Dhaval437/Baymax/assembly/amplifier-esp32-wiring.png

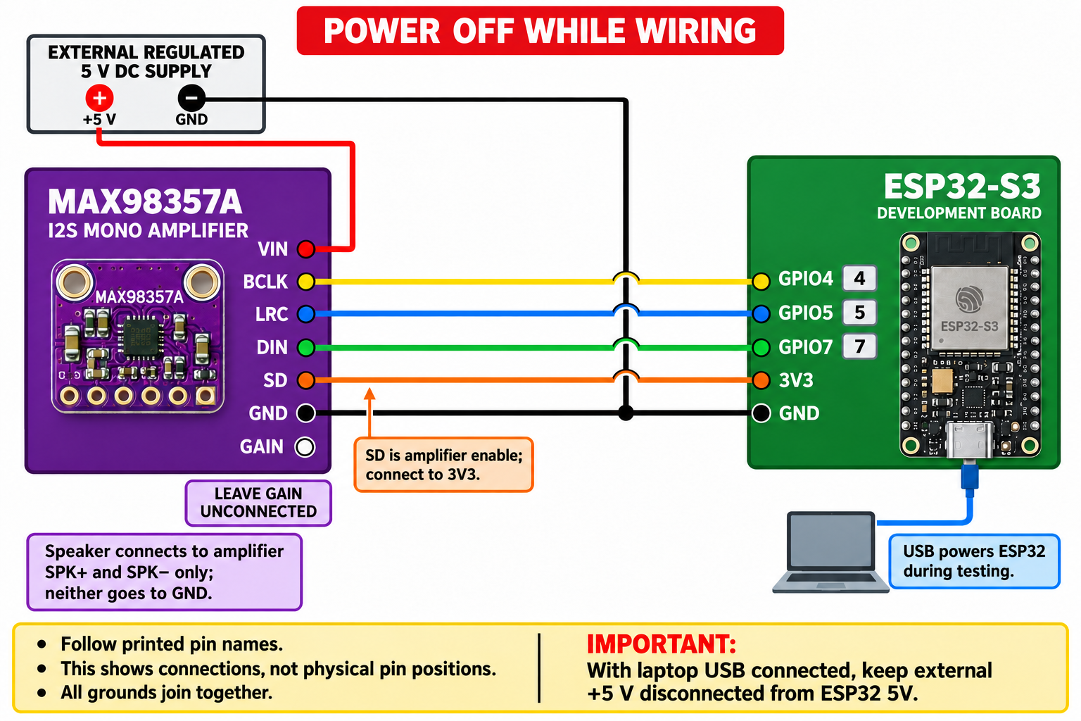
assembly/amplifier-esp32-wiring.png
