Dhaval437/Baymax/assembly/audio-wiring-corrected.png

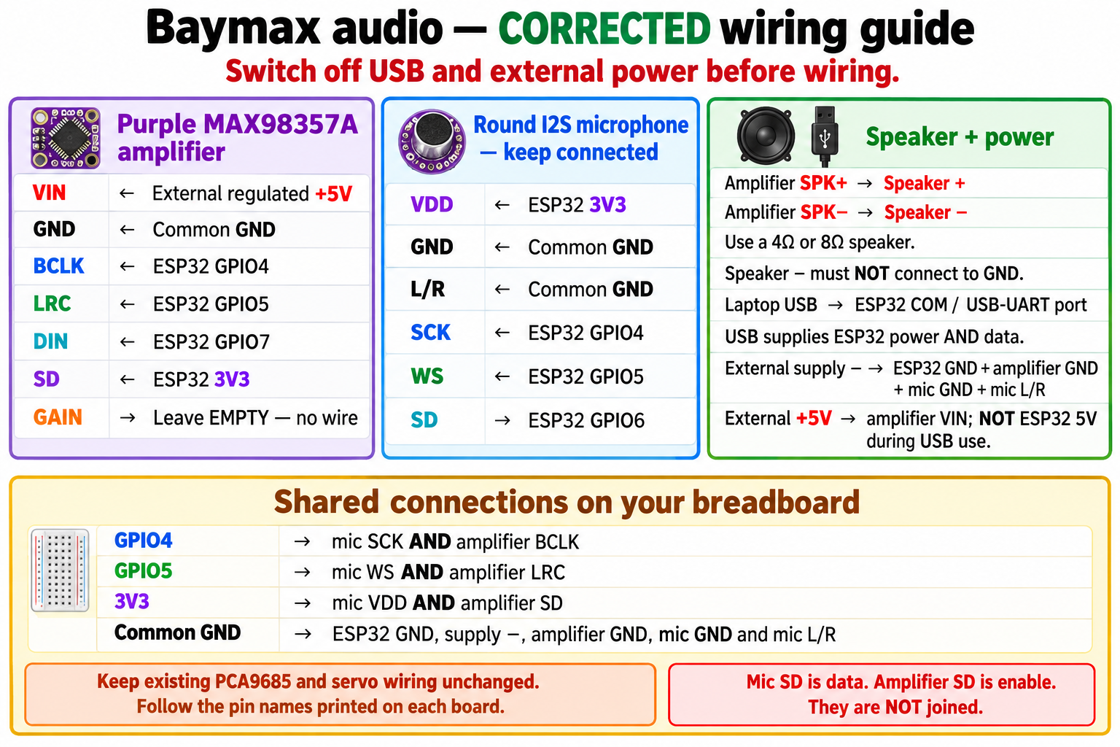
assembly/audio-wiring-corrected.png
