Dhaval437/Baymax/README.md

<div align=center>

# Mini Baymax

### A voice-first, expressive companion robot powered by an ESP32-S3 and local AI






**Listen. Think. Speak. Move.**

[Quick start](#quick-start) · [How it works](#how-it-works) · [Hardware](#hardware) · [Documentation](#documentation)

</div>

---

Mini Baymax is a laptop-assisted companion robot that listens for **“Baymax”** or a distress cue, transcribes speech, creates a contextual response with a local language model, speaks it aloud, and performs gentle head and arm gestures.

The project combines an ESP32-S3 audio and motion controller with a local Node.js service, Whisper speech recognition, Ollama conversation generation, and local voice synthesis. It is designed to keep conversations on the local network and continue working without a cloud AI subscription.

> [!IMPORTANT]
> This is an experimental hobby robot—not a medical device, emergency service, or clinically validated care system. Its health-related responses are limited educational guidance and may be wrong.

## Highlights

- **Hands-free conversation** — automatic listening, wake phrase detection, adaptive turn endings, and follow-up windows.
- **Local-first intelligence** — speech recognition, response generation, and voice synthesis run on the laptop.
- **Expressive movement** — smooth, bounded PCA9685 gestures for the head and two arms.
- **Live telemetry** — local dashboard for microphone levels, transcripts, timing, connectivity, and motion state.
- **Conversation memory** — recent turns are retained in RAM, with bounded summarization for longer discussions.
- **Phone setup** — configure Wi-Fi, update the laptop address, pause/resume, and install compatible firmware updates.
- **Resilient audio pipeline** — pre-roll capture, adaptive noise floor, speech-onset filtering, retries, and segmented replies.
- **Private by default** — authenticated device requests, local-only dashboards, temporary audio, and no persisted chat history.

## How It Works

```mermaid
flowchart LR
    User((You)) -->|voice| Mic[I2S microphone]
    Mic --> ESP[ESP32-S3 firmware]
    ESP -->|authenticated audio over Wi-Fi| Server[Node.js robot server]
    Server --> STT[Whisper speech recognition]
    STT --> LLM[Ollama · qwen3:1.7b]
    LLM --> TTS[Local voice synthesis]
    TTS -->|PCM audio + gesture cue| ESP
    ESP --> Speaker[I2S amplifier + speakers]
    ESP --> Motion[PCA9685 + servos]
    ESP -. USB telemetry .-> Dashboard[Local dashboard]
```

The ESP32 handles real-time capture, playback, Wi-Fi, and safe motion. The laptop handles the heavier AI workload. The robot therefore needs the laptop awake and connected to the same network during normal conversation.

## Quick Start

### Laptop prototype

Use this path to try the browser conversation interface without assembling the robot.

**Requirements**

- Windows, macOS, or Linux
- Node.js **22.9 or newer**
- A configured AI provider; local mode uses Ollama, FFmpeg, Python, `faster-whisper`, and the included speech worker

```powershell
git clone https://github.com/Dhaval437/Baymax.git
cd Baymax
Copy-Item .env.example .env
npm start
```

Open [http://127.0.0.1:8787](http://127.0.0.1:8787). For the full local model setup, follow [START_HERE.md](START_HERE.md).

### Complete robot

After configuring the local models, private environment file, and ESP32 firmware:

```powershell
npm run check:robot
.\Start-Baymax.cmd
```

The launcher starts:

| Service | Default address | Purpose |
|---|---|---|
| Browser prototype | `http://127.0.0.1:8787` | Text, microphone, and voice testing |
| Robot API | `http://<laptop-ip>:8788` | Authenticated ESP32 audio transport |
| Robot dashboard | `http://127.0.0.1:8793` | Live transcript, timing, audio, and hardware telemetry |

Upload the integrated firmware when required:

```powershell
powershell -ExecutionPolicy Bypass -File .\assembly\Build-Baymax.ps1 -Upload -Port COM14
```

Replace `COM14` with the ESP32's current port. Read [HARDWARE_SETUP.md](HARDWARE_SETUP.md) before applying external power or enabling motion.

## Configuration

Copy `.env.example` to `.env` and configure the laptop service:

```dotenv
AI_PROVIDER=local
LOCAL_MODEL=qwen3:1.7b
PORT=8787
BAYMAX_DEVICE_PORT=8788
BAYMAX_DEVICE_HOST=127.0.0.1
BAYMAX_DEVICE_TOKEN=REPLACE_WITH_AT_LEAST_32_RANDOM_CHARACTERS
```

Then copy `firmware/MiniBaymax/config.example.h` to `firmware/MiniBaymax/config.h` and set the same device token, Wi-Fi credentials, and laptop address.

> [!WARNING]
> Never commit `.env`, `config.h`, setup keys, Wi-Fi credentials, private firmware binaries, or files under `assembly/private/`.

### Local AI Stack

| Layer | Default implementation |
|---|---|
| Speech recognition | `faster-whisper` / Whisper `tiny.en` |
| Conversation | Ollama with `qwen3:1.7b` |
| Voice synthesis | Persistent local Python speech worker |
| Orchestration | Node.js HTTP services |
| Robot control | Arduino firmware for ESP32-S3 N16R8 |

Gemini and Groq adapters are also present for browser-prototype experiments, but local mode is the primary robot path.

## Hardware

The integrated build targets:

- ESP32-S3 N16R8 development board
- I2S microphone
- I2S amplifier and speakers
- PCA9685 servo controller at address `0x40`
- Three servo channels: head `0`, left arm `1`, right arm `2`
- Separate, correctly sized power for logic, audio, and servo loads

Motion is disabled by default in the shared configuration. Centre and test bare servos before connecting the mechanism, keep the robot clear of obstructions, and enable motion only after reviewing the assembly guide.

See [PARTS_INVENTORY.md](PARTS_INVENTORY.md), [MECHANICAL_LAYOUT.md](MECHANICAL_LAYOUT.md), and [ASSEMBLY_NEXT_STEPS.md](ASSEMBLY_NEXT_STEPS.md) for the physical build.

## Useful Commands

| Command | Description |
|---|---|
| `npm start` | Start the browser prototype |
| `npm run start:robot` | Start the robot API, browser app, dashboard, and speech worker |
| `npm run check:robot` | Check configuration, network address, local tools, and Ollama model |
| `npm test` | Run the Node.js regression suite |
| `npm run test:live` | Exercise the real local speech pipeline without moving hardware |
| `assembly\test-firmware-host.cmd` | Run native host tests for firmware policies and motion logic |

## Project Structure

```text
Baymax/
├── firmware/MiniBaymax/     # Integrated ESP32-S3 firmware
├── assembly/                # Build, upload, diagnostics, and verification tools
├── mechanical/              # Printable and mechanical design assets
├── public/                  # Browser app, dashboard, and phone setup UI
├── test/                    # Node, Python, and native regression tests
├── device-server.mjs        # Authenticated robot speech API
├── start-baymax.mjs         # Integrated laptop launcher
├── local-provider.mjs       # Local recognition, LLM, and speech adapter
└── conversation-policy.mjs  # Memory, response, and follow-up behavior
```

## Documentation

| Guide | Use it for |
|---|---|
| [START_HERE.md](START_HERE.md) | Laptop prototype and AI-provider setup |
| [SOFTWARE_READY.md](SOFTWARE_READY.md) | Integrated software behavior and startup |
| [HARDWARE_SETUP.md](HARDWARE_SETUP.md) | Wiring, power, and hardware bring-up |
| [ASSEMBLY_NEXT_STEPS.md](ASSEMBLY_NEXT_STEPS.md) | Safe physical assembly order |
| [assembly/PHONE_SETUP.md](assembly/PHONE_SETUP.md) | Wi-Fi provisioning and wireless updates |
| [assembly/FINAL_RELEASE.md](assembly/FINAL_RELEASE.md) | Installed firmware behavior and verification |
| [PARTS_INVENTORY.md](PARTS_INVENTORY.md) | Components and current inventory |

## Project Status

This repository is an **active hardware prototype**. Integrated firmware, authenticated Wi-Fi conversation, local speech processing, live telemetry, phone setup, and bounded servo control are implemented and covered by automated or bench verification.

Physical performance still depends on the assembled robot, room acoustics, network quality, power delivery, servo geometry, and local model behavior. Do not treat compiled firmware or simulated tests as proof of safe mechanical travel, reliable speech recognition, or medical correctness.

## Contributing

Issues and focused pull requests are welcome. Before submitting changes:

1. Keep credentials and generated private artifacts out of Git.
2. Run `npm test`.
3. Run the relevant firmware host tests for motion, capture, or setup-policy changes.
4. Document any hardware assumptions and distinguish simulation from physical verification.

## Disclaimer

This is an independent educational and hobby project inspired by a fictional healthcare companion. It is not affiliated with, endorsed by, or sponsored by Disney. “Baymax” and related character rights belong to their respective owners.

---

<div align=center>

Built with curiosity, careful testing, and a lot of gentle robot energy. 🤍

</div>
