Dhaval437/Baymax/output/CCD Practicals - Dhaval Gandhi/CCD Practical 06.pdf

### Practical no. 6

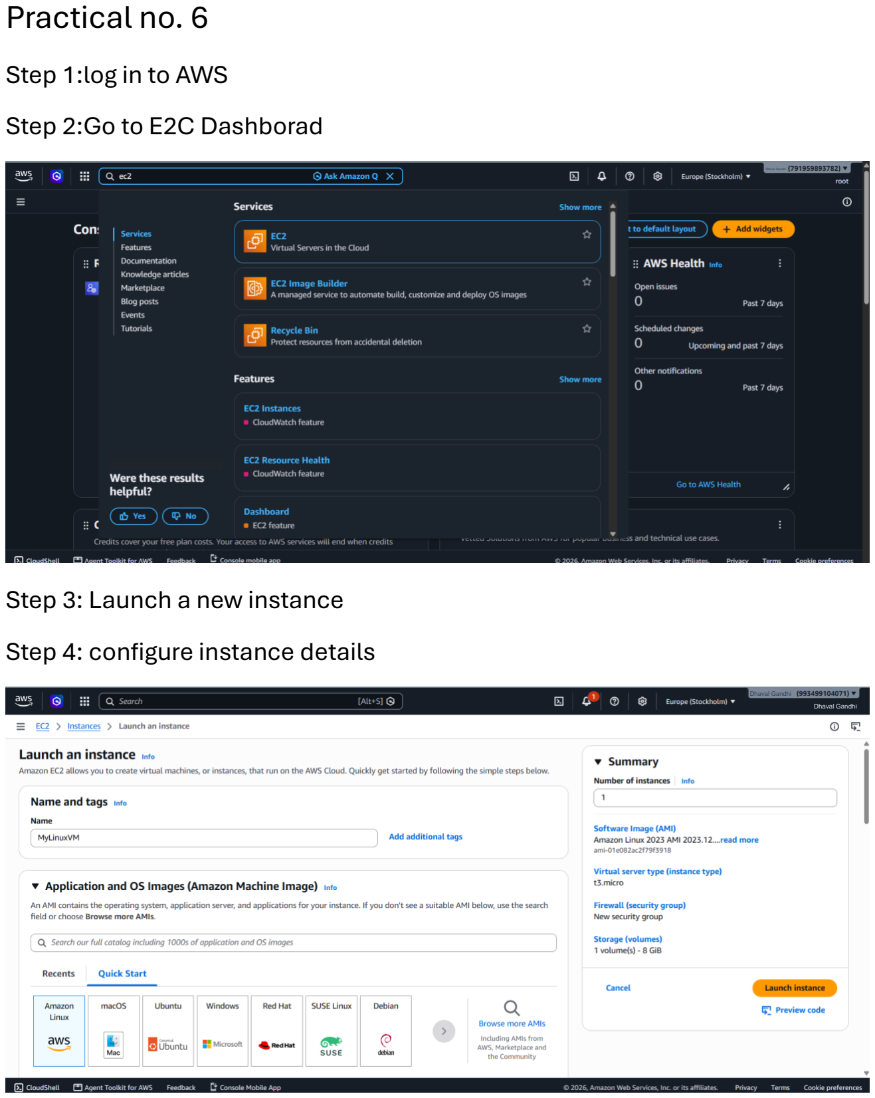
[picture p3: page 1]

Step 1:log in to AWS
Step 2:Go to E2C Dashborad
Step 3: Launch a new instance
Step 4: configure instance details

Dhaval Gandhi

Dhaval Gandhi
Dhaval Gandhi

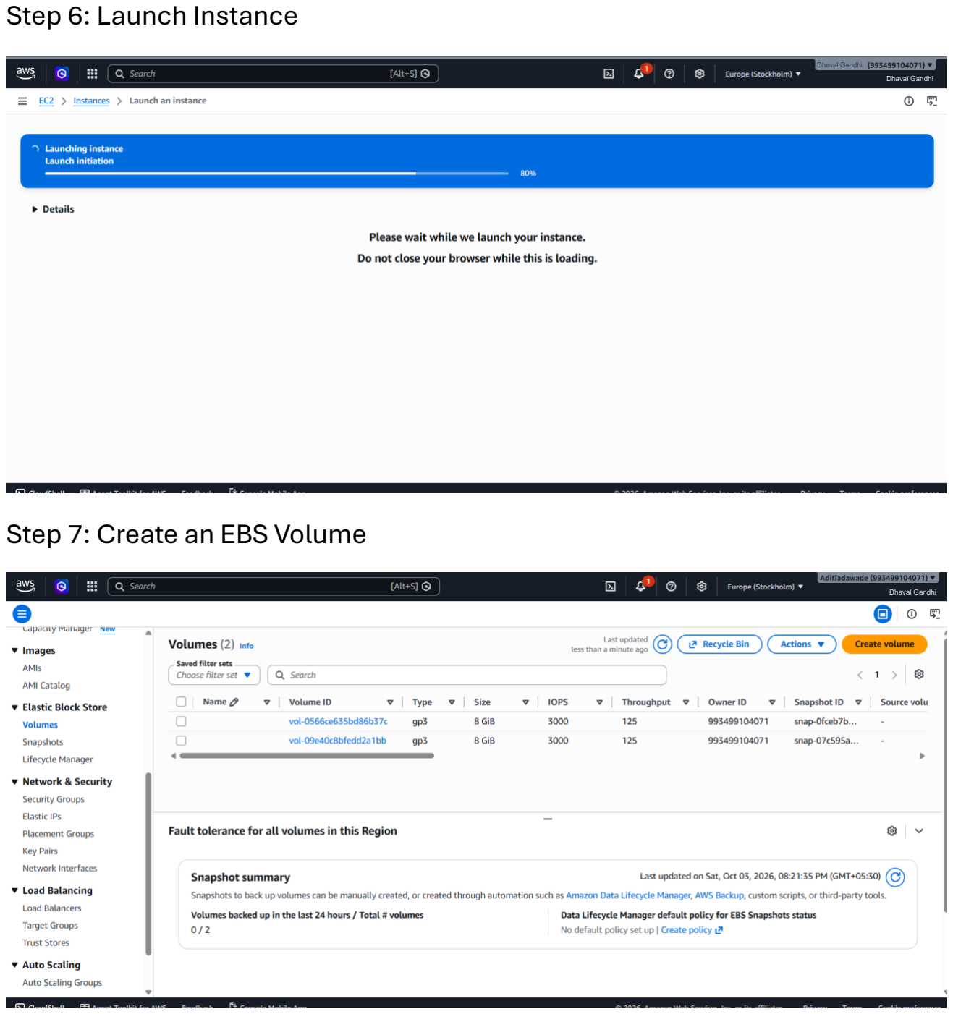
[picture p4: page 2]

Step 6: Launch Instance
Step 7: Create an EBS Volume

Dhaval Gandhi
Dhaval Gandhi

Dhaval Gandhi

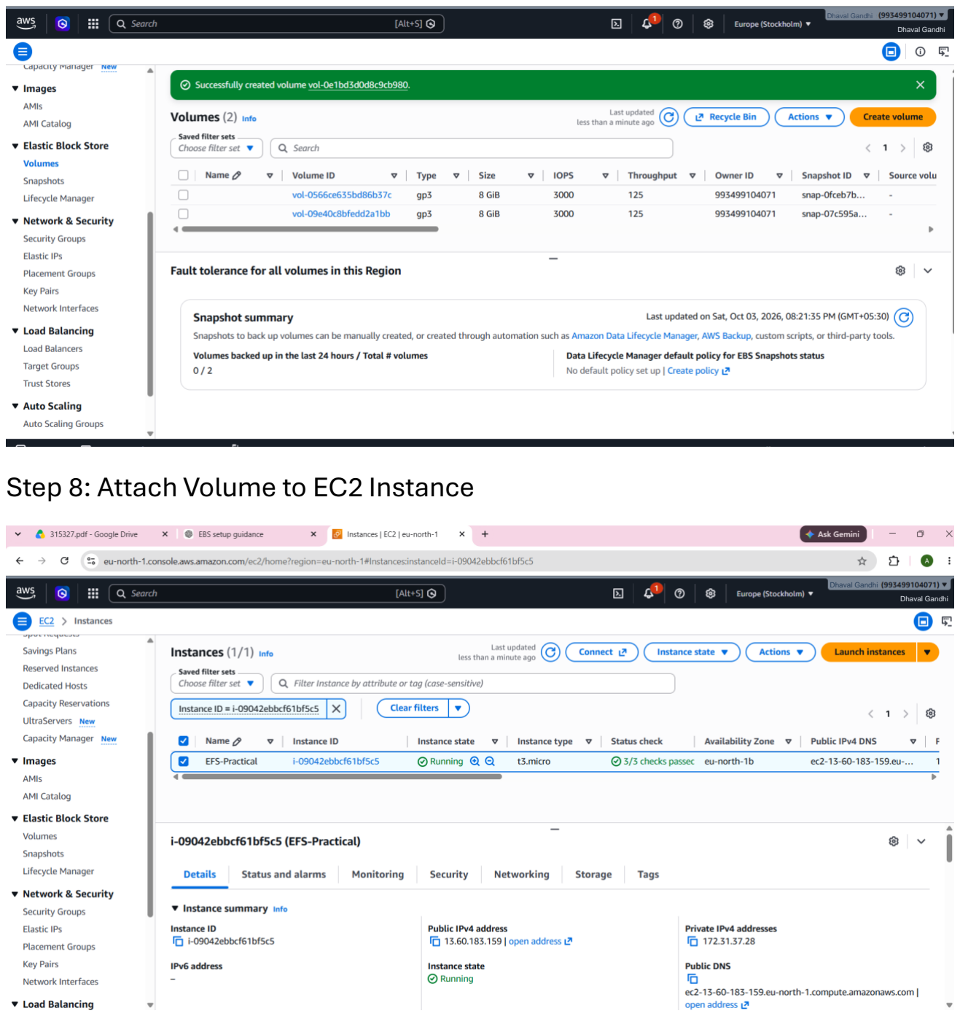
[picture p5: page 3]

Step 8: Attach Volume to EC2 Instance

Dhaval Gandhi
Dhaval Gandhi

Dhaval Gandhi

Dhaval Gandhi

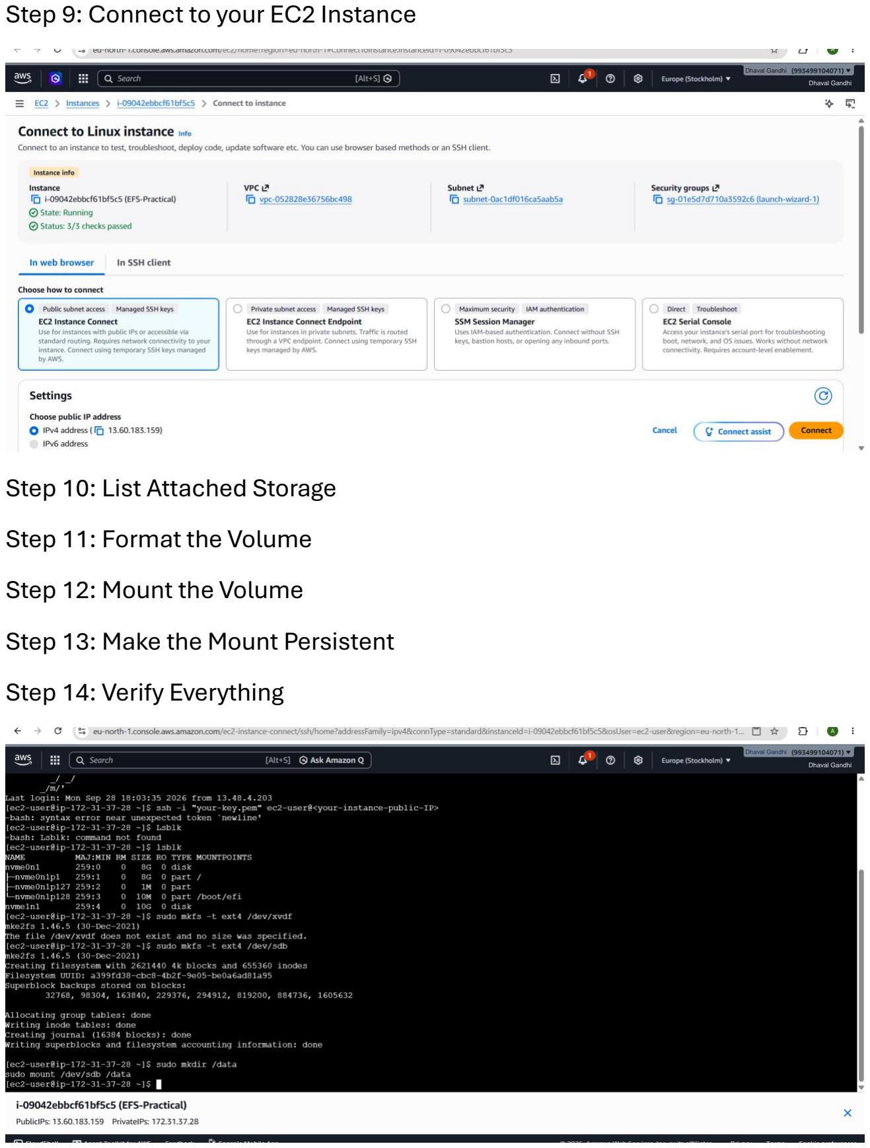
[picture p6: page 4]

Step 9: Connect to your EC2 Instance
Step 10: List Attached Storage
Step 11: Format the Volume
Step 12: Mount the Volume
Step 13: Make the Mount Persistent
Step 14: Verify Everything

Dhaval Gandhi

Dhaval Gandhi

Dhaval Gandhi
Dhaval Gandhi

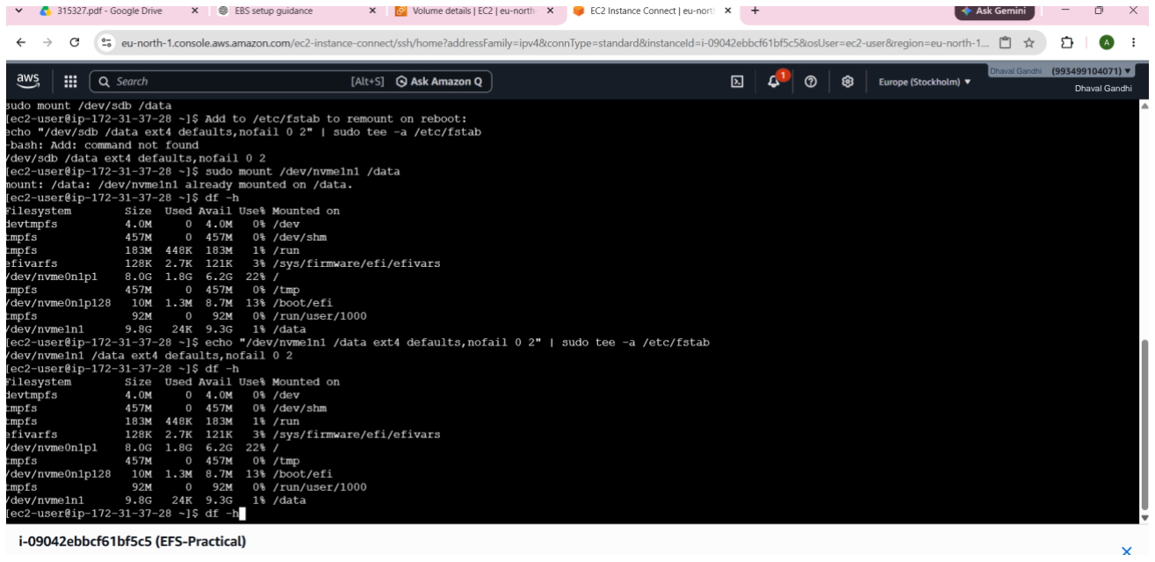
[picture p7: figure]
Dhaval Gandhi
