Dhaval437/Baymax/output/CCD Practicals - Dhaval Gandhi/CCD Practical 07.pdf

### Practical no. 7

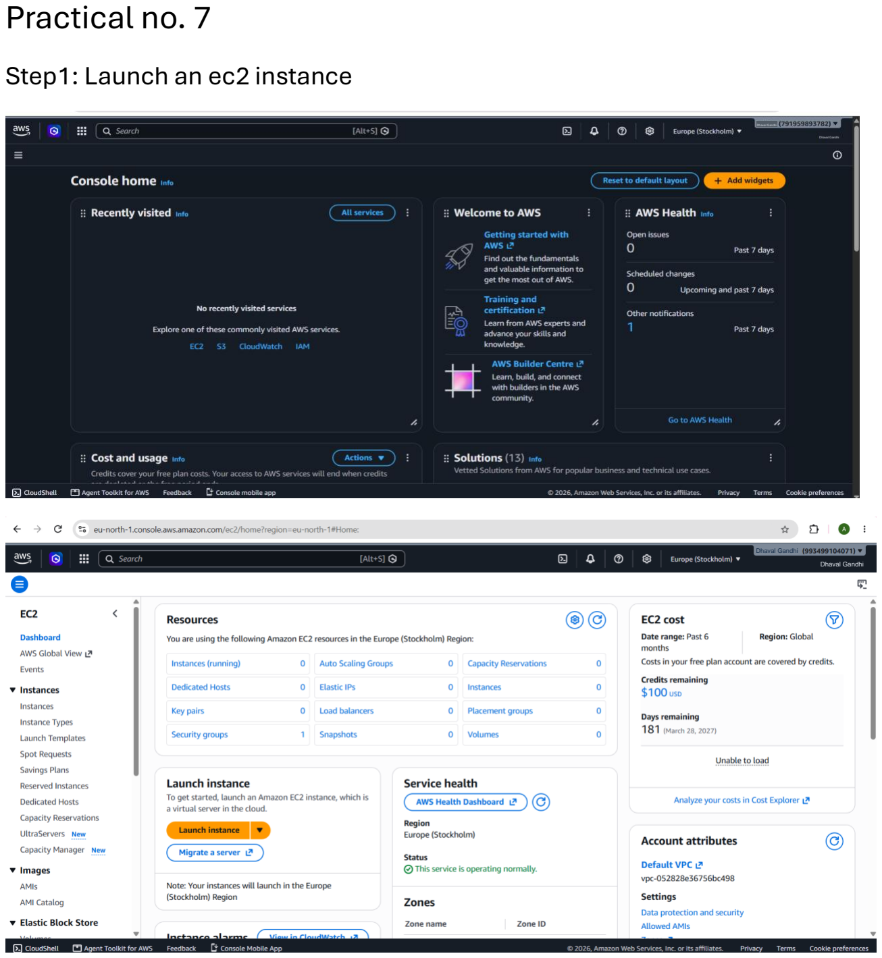
[picture p8: page 1]

Step1: Launch an ec2 instance

Dhaval Gandhi

Dhaval Gandhi

Dhaval Gandhi
Dhaval Gandhi

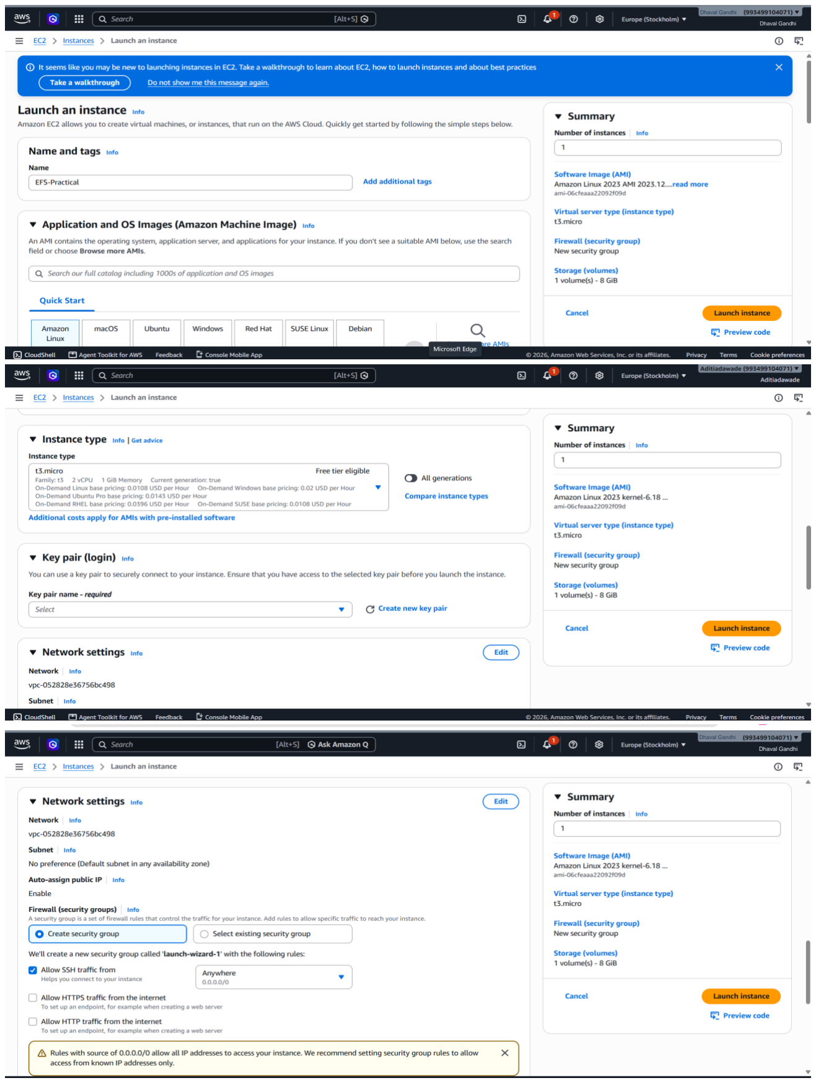
[picture p9: page 2]

Dhaval Gandhi

Dhaval Gandhi

Dhaval Gandhi
Dhaval Gandhi

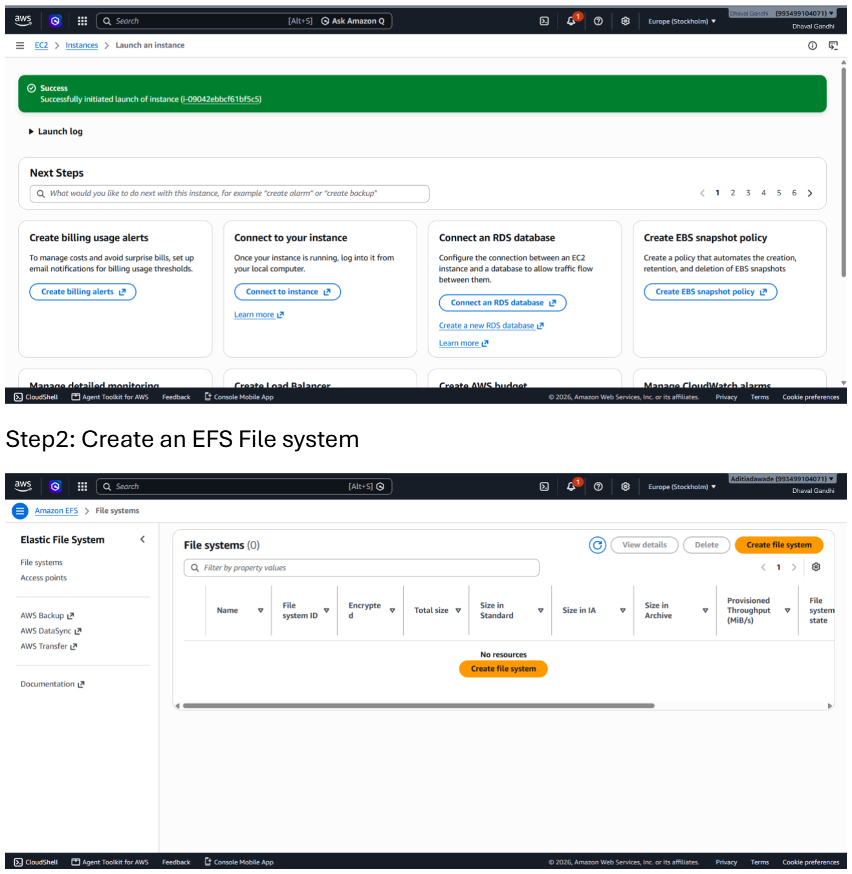
[picture p10: page 3]

Step2: Create an EFS File system

Dhaval Gandhi
Dhaval Gandhi

Dhaval Gandhi

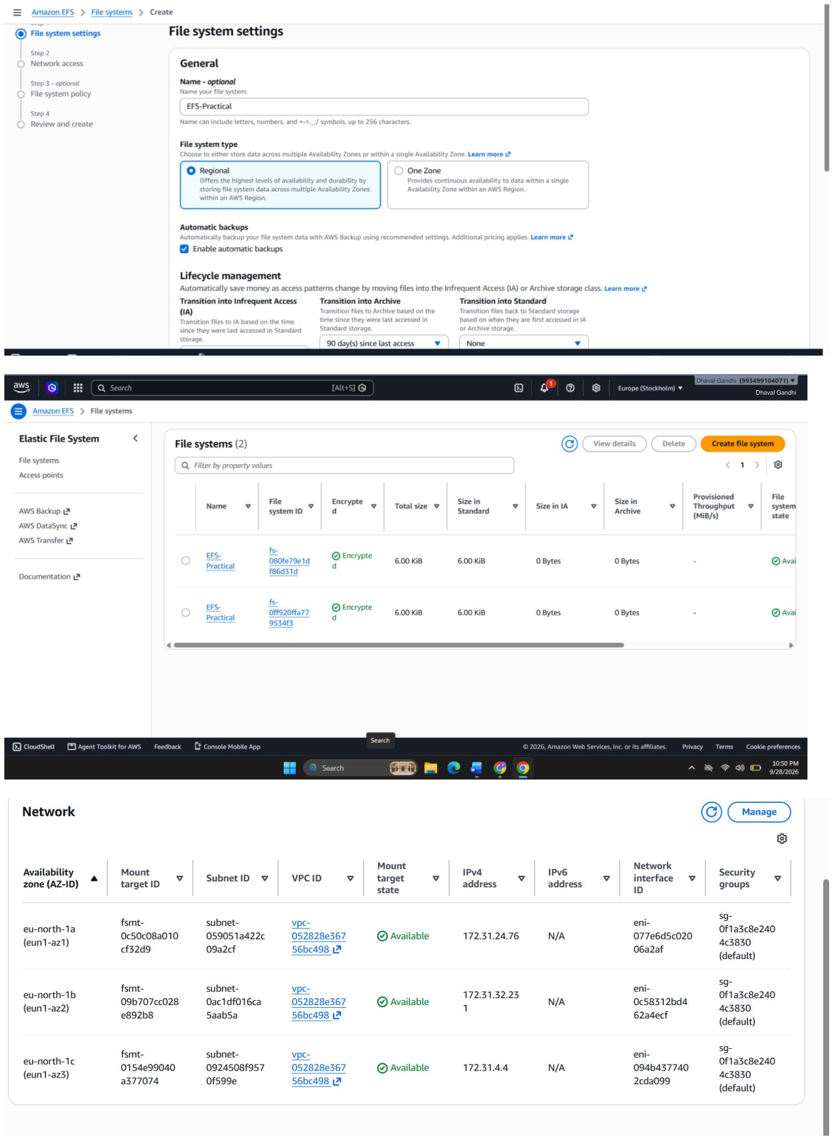
[picture p11: page 4]

Dhaval Gandhi
Dhaval Gandhi

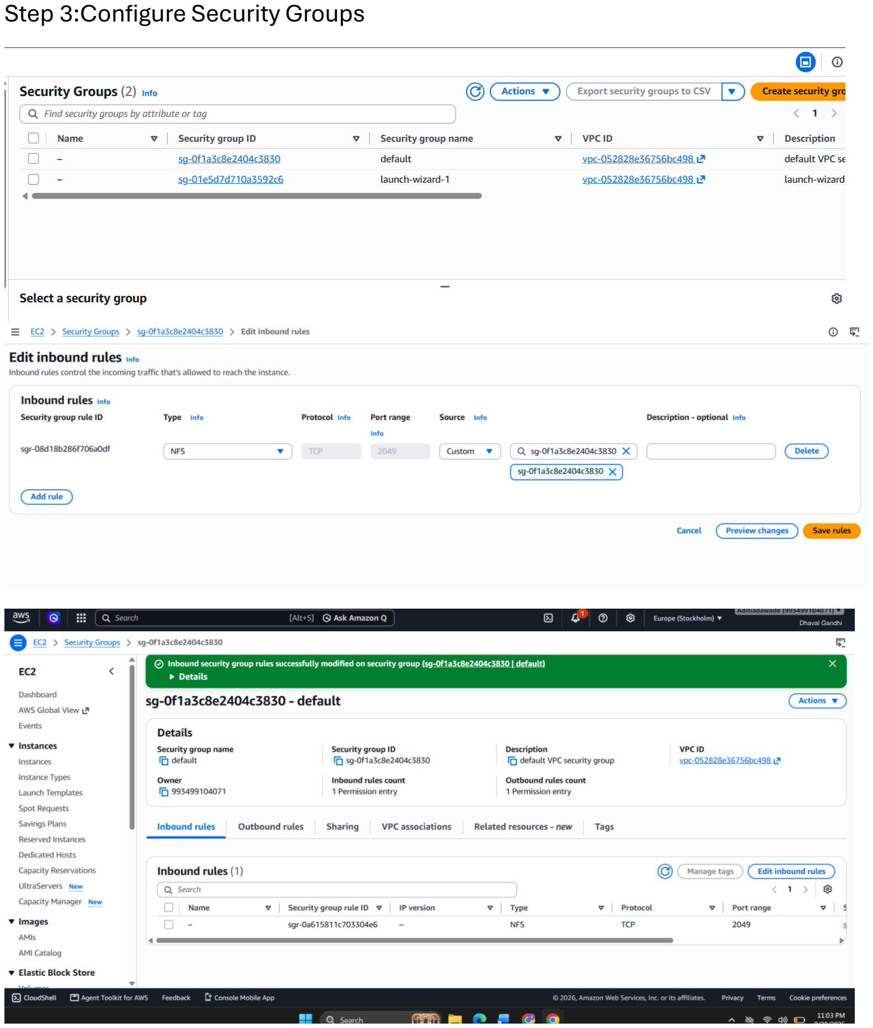
[picture p12: page 5]

Step 3:Configure Security Groups

Dhaval Gandhi

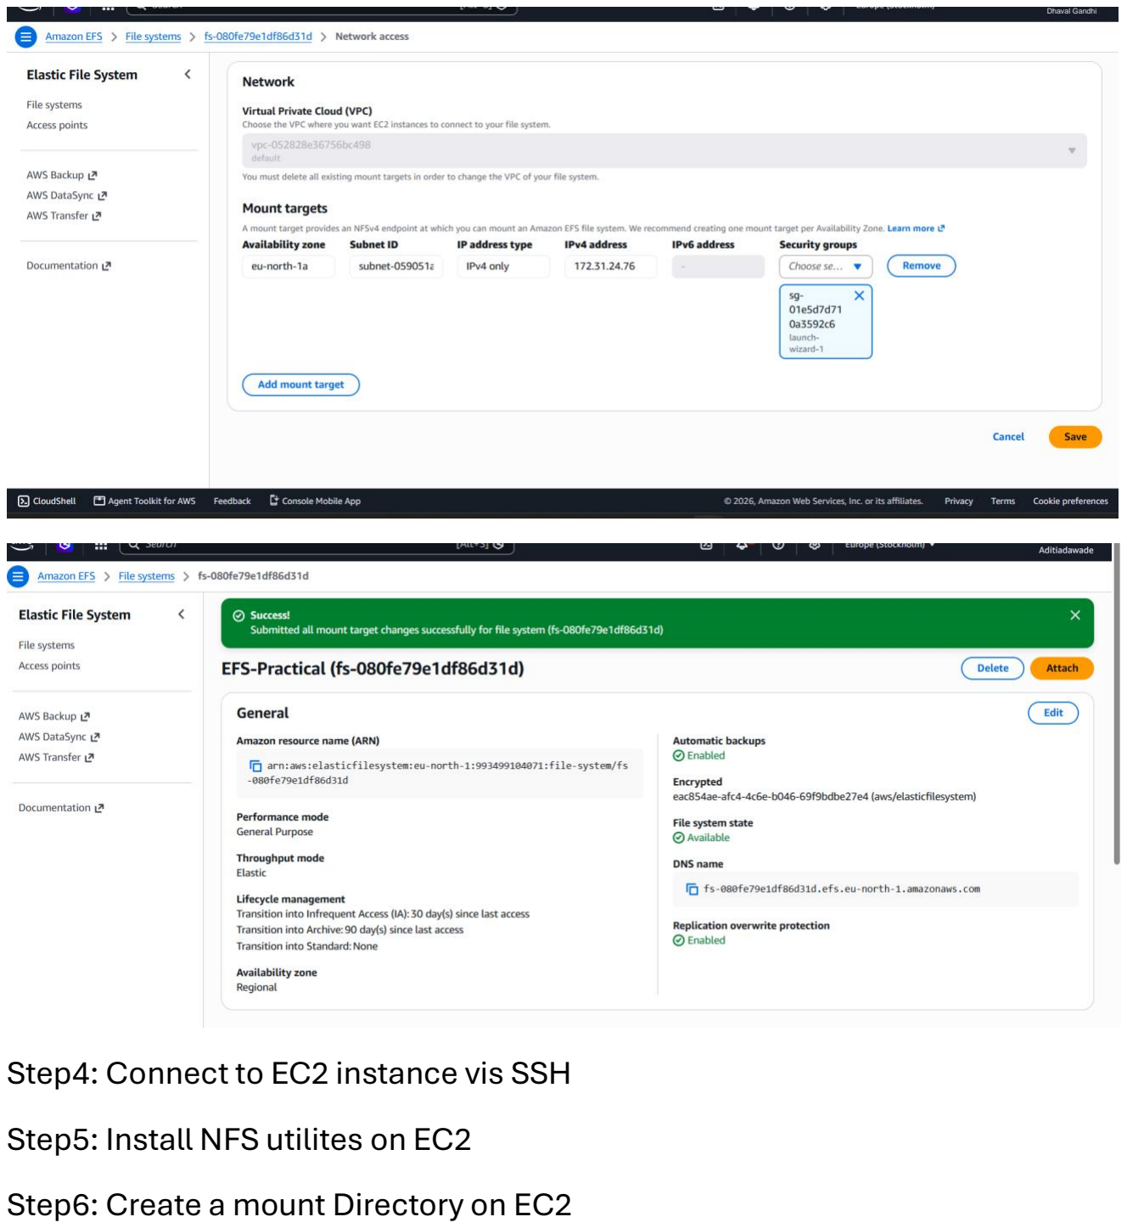
[picture p13: page 6]

Step4: Connect to EC2 instance vis SSH Step5: Install NFS utilites on EC2 Step6: Create a mount Directory on EC2

Dhaval Gandhi

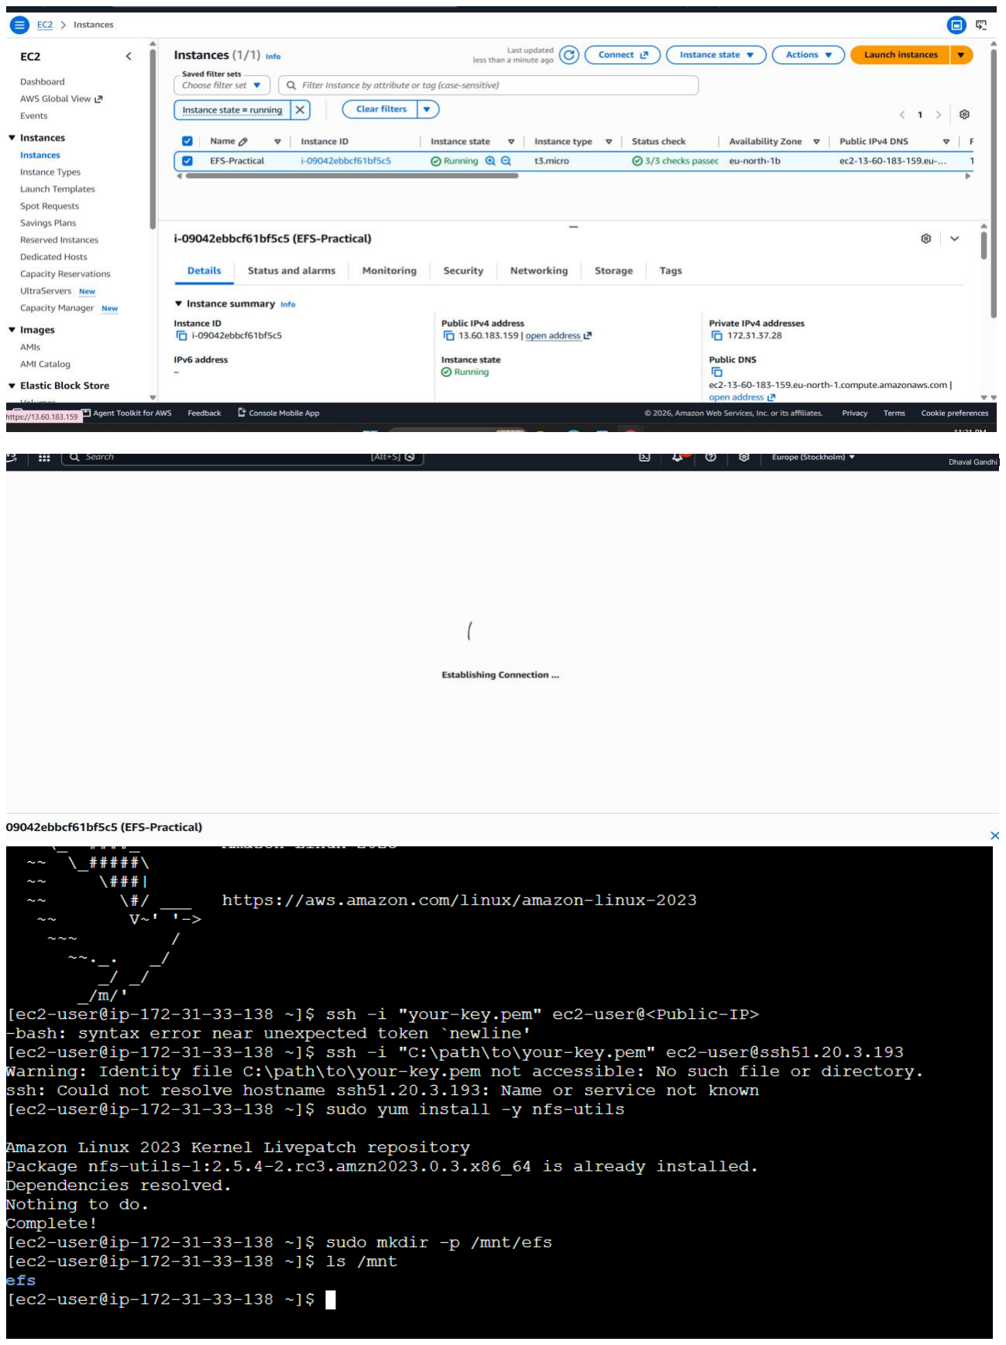
[picture p14: page 7]

Dhaval Gandhi

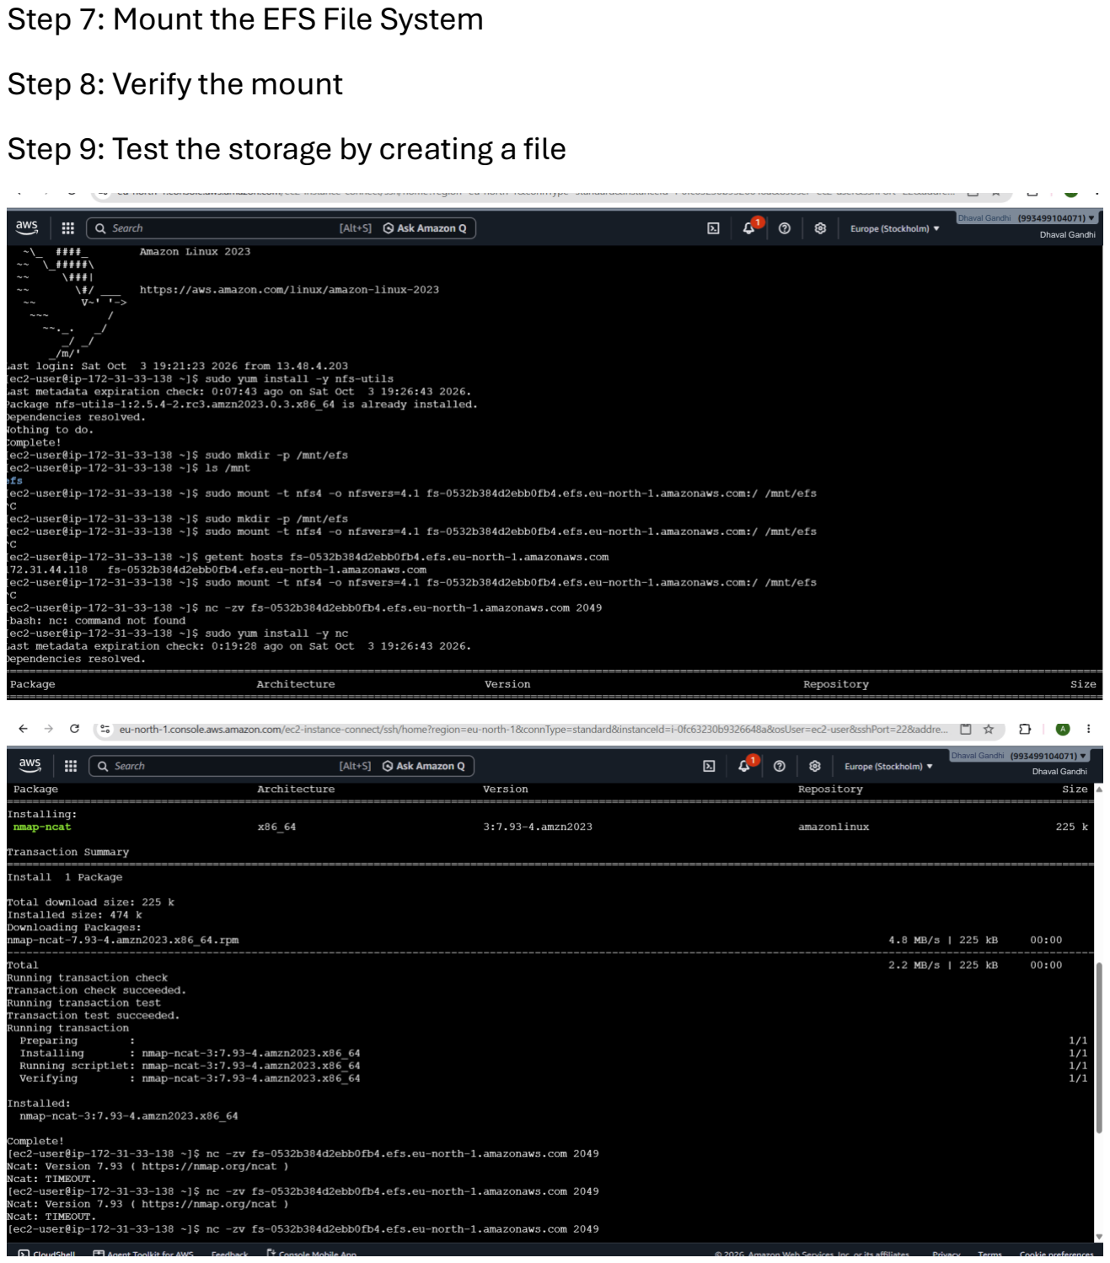
[picture p15: page 8]

Step 7: Mount the EFS File System
Step 8: Verify the mount
Step 9: Test the storage by creating a file

Dhaval Gandhi
Dhaval Gandhi

Dhaval Gandhi
Dhaval Gandhi

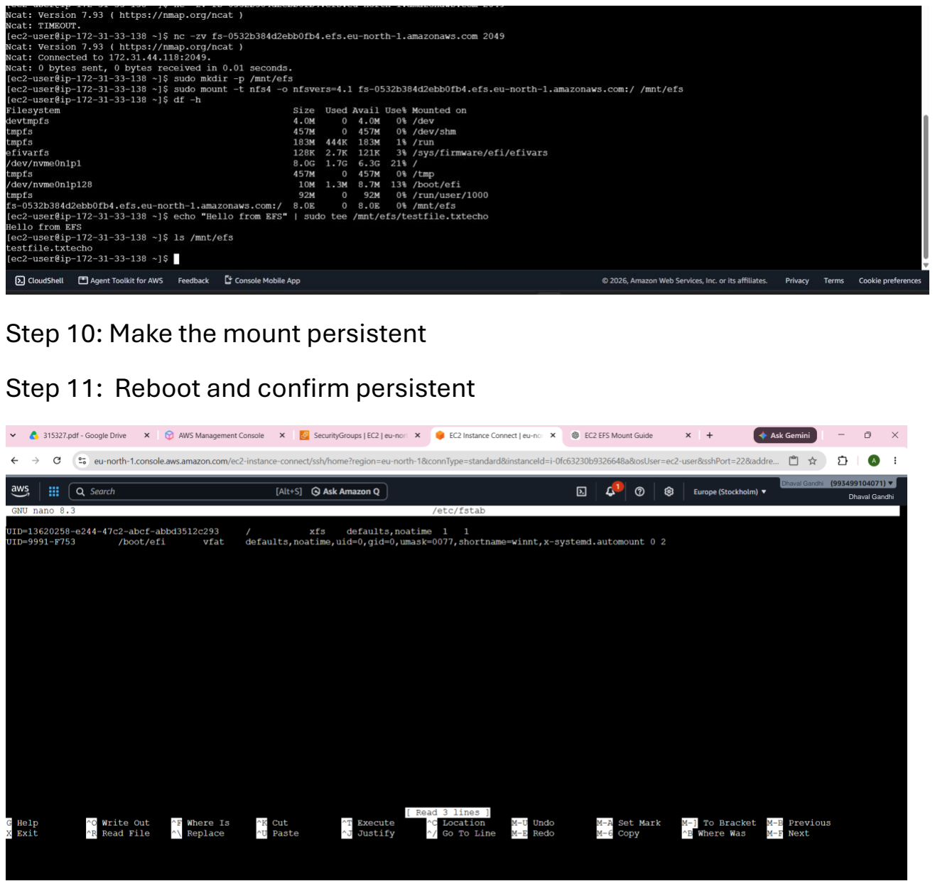
[picture p16: page 9]

Step 10: Make the mount persistent
Step 11: Reboot and confirm persistent

Dhaval Gandhi
Dhaval Gandhi

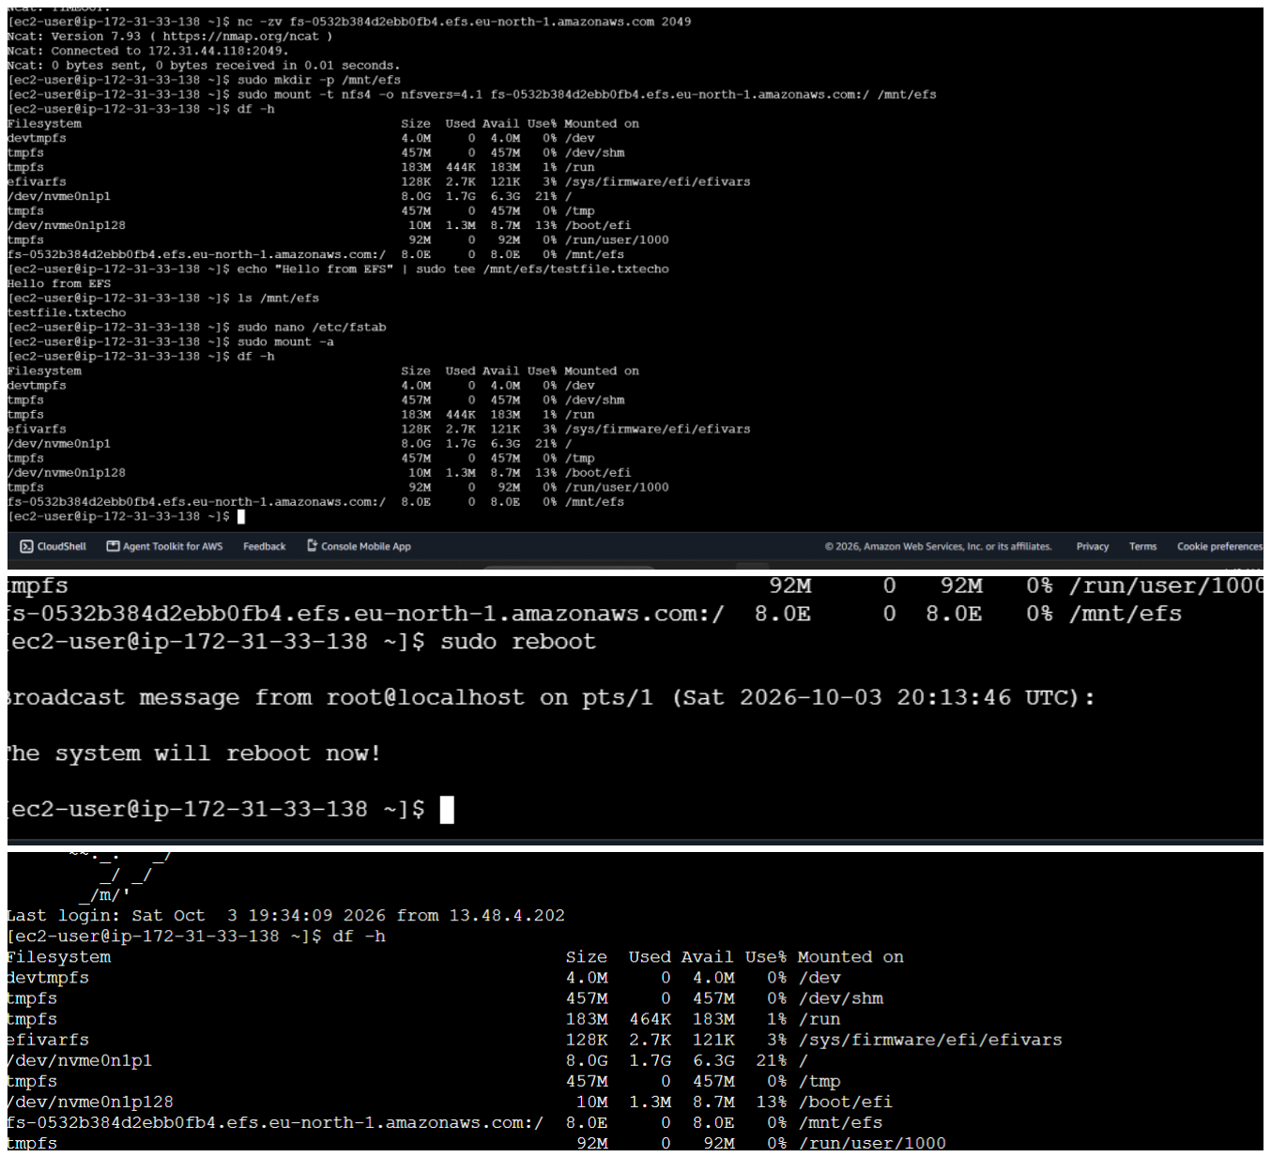
[picture p17: figure]
