Dhaval437/Baymax/output/CCD Practicals - Dhaval Gandhi/CCD Practical 04.pdf

Practical no. 4 Dhaval Gandhi | Dhaval Gandhi

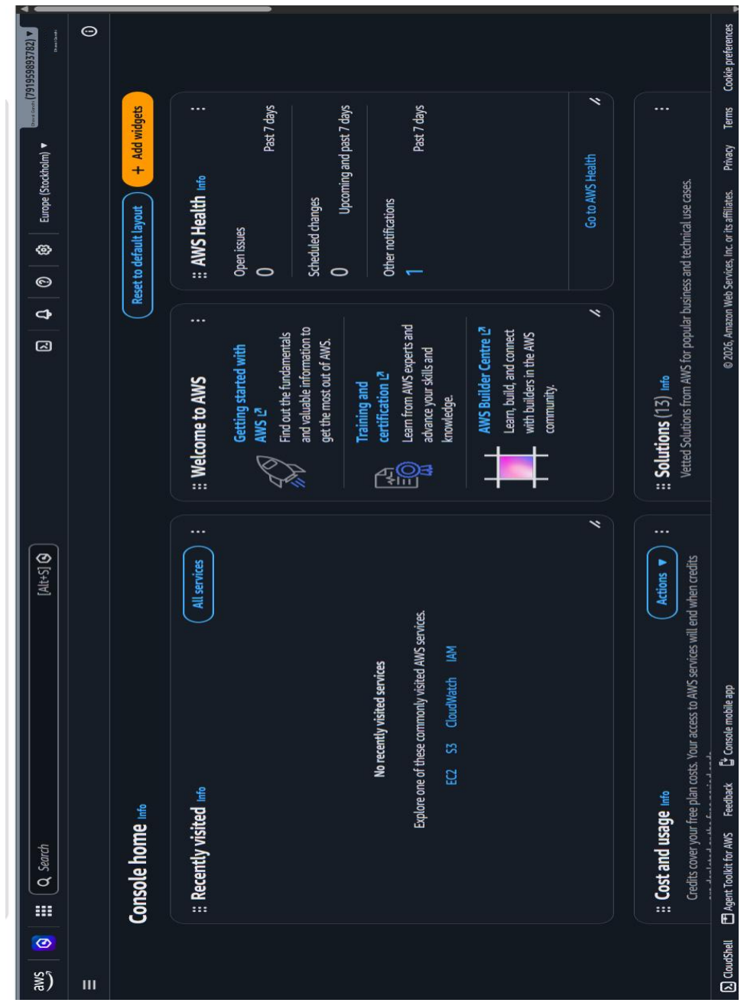
[picture p18: figure]
