Dhaval437/Baymax/output/CCD Practicals - Dhaval Gandhi/CCD Practical 05.pdf

### CCD Practical no. 5

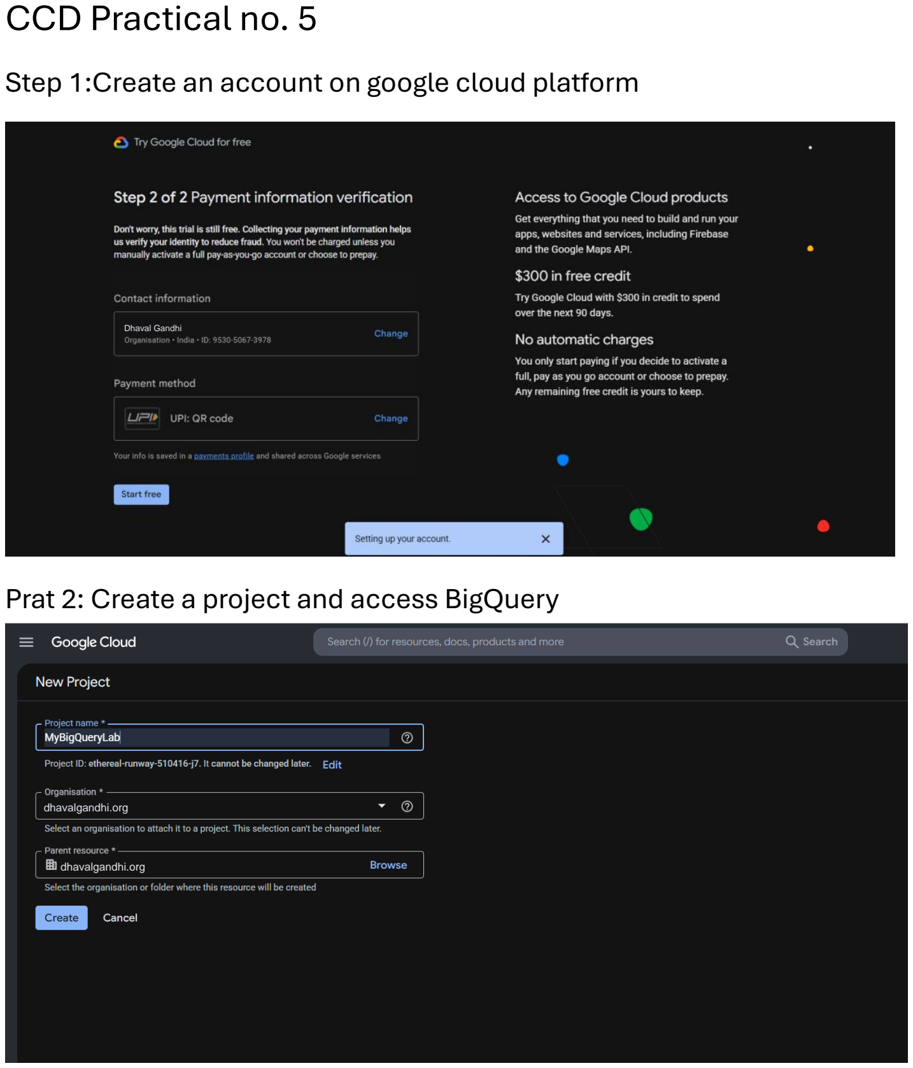
[picture p19: page 1]

Step 1:Create an account on google cloud platform

Prat 2: Create a project and access BigQuery

Dhaval Gandhi

dhavalgandhi.org

dhavalgandhi.org

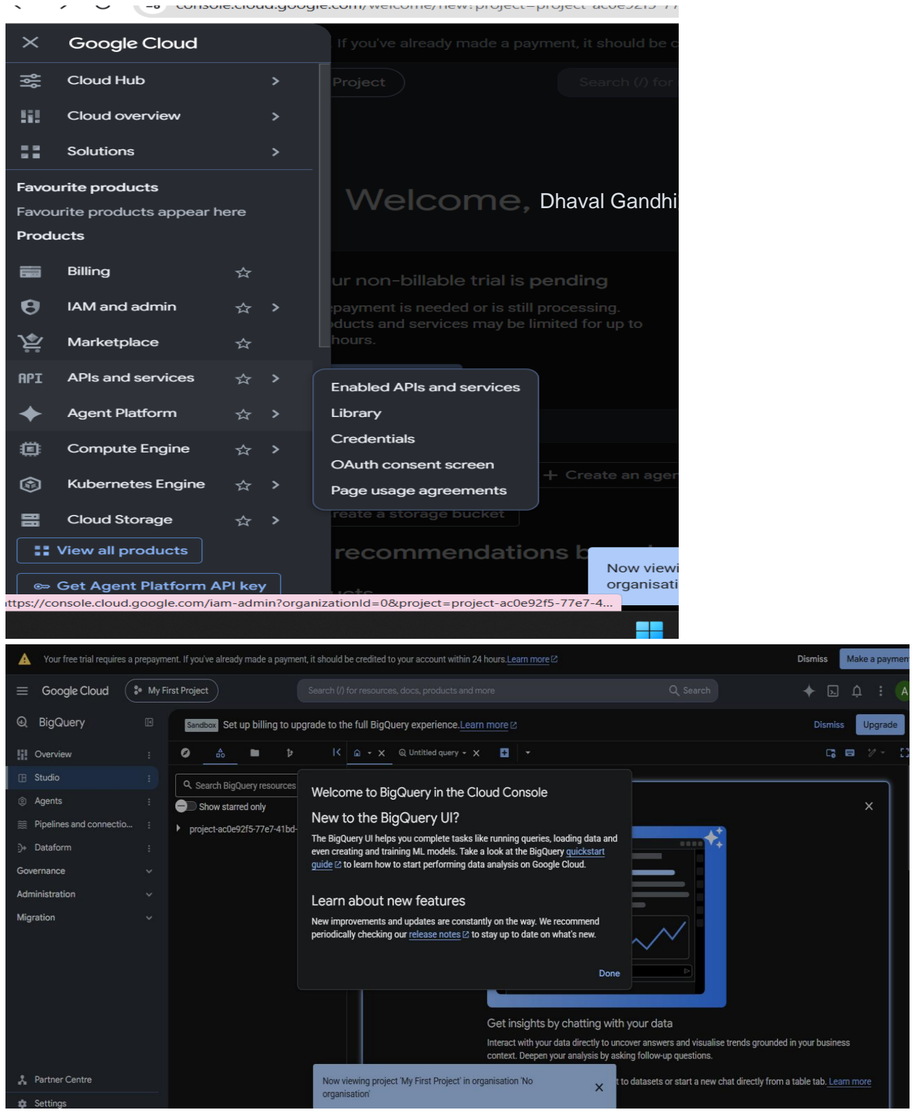
[picture p20: page 2]

Dhaval Gandhi

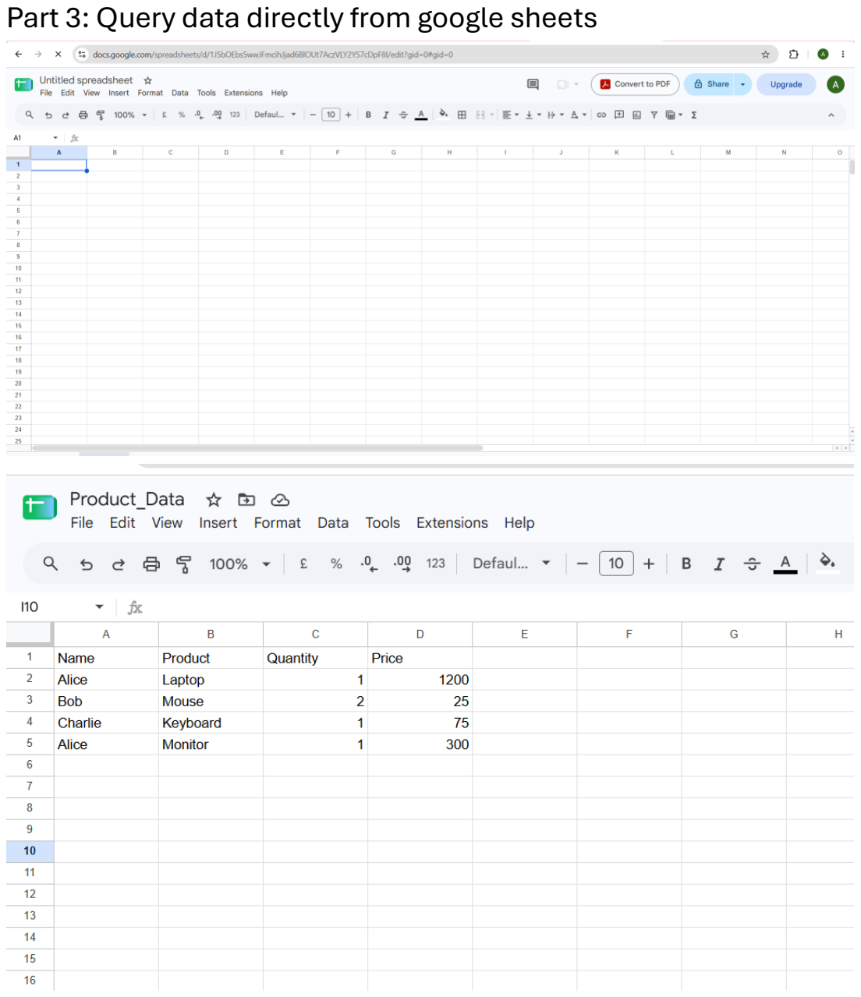
[picture p21: page 3]

Part 3: Query data directly from google sheets

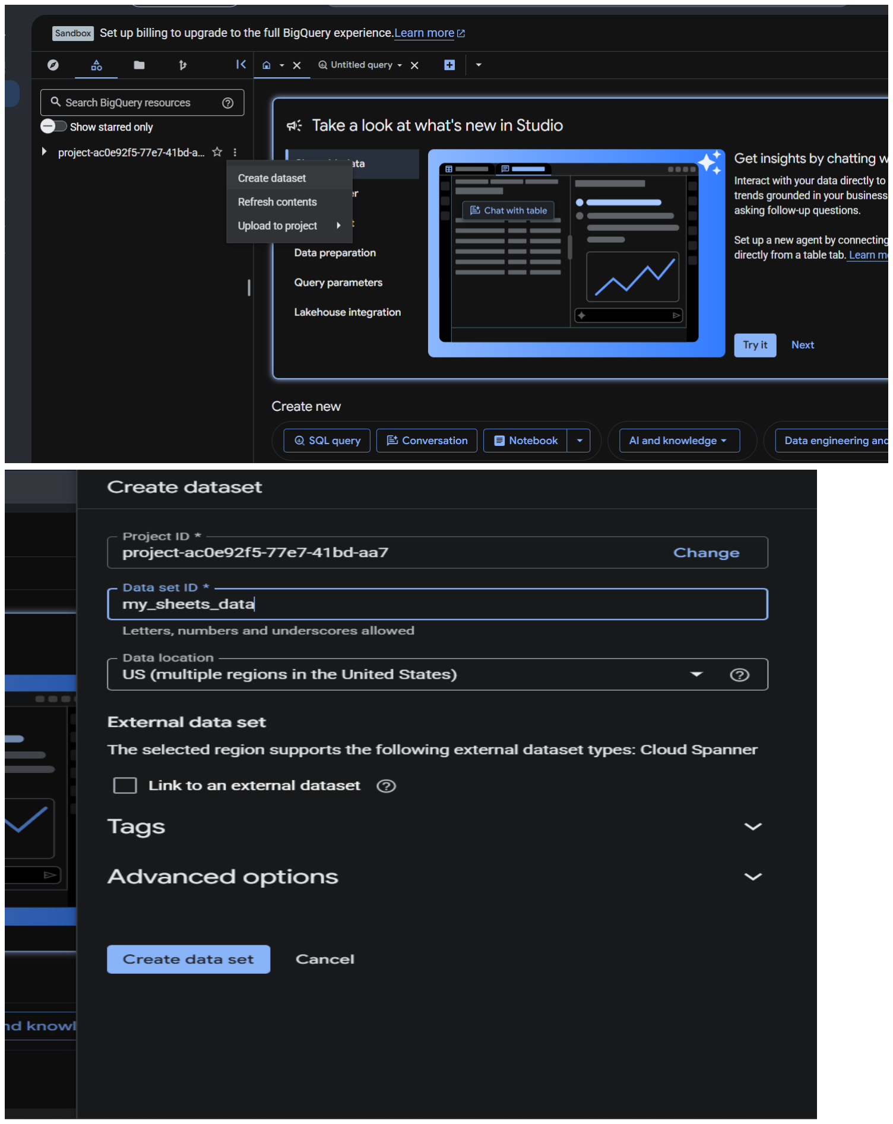
[picture p22: figure]
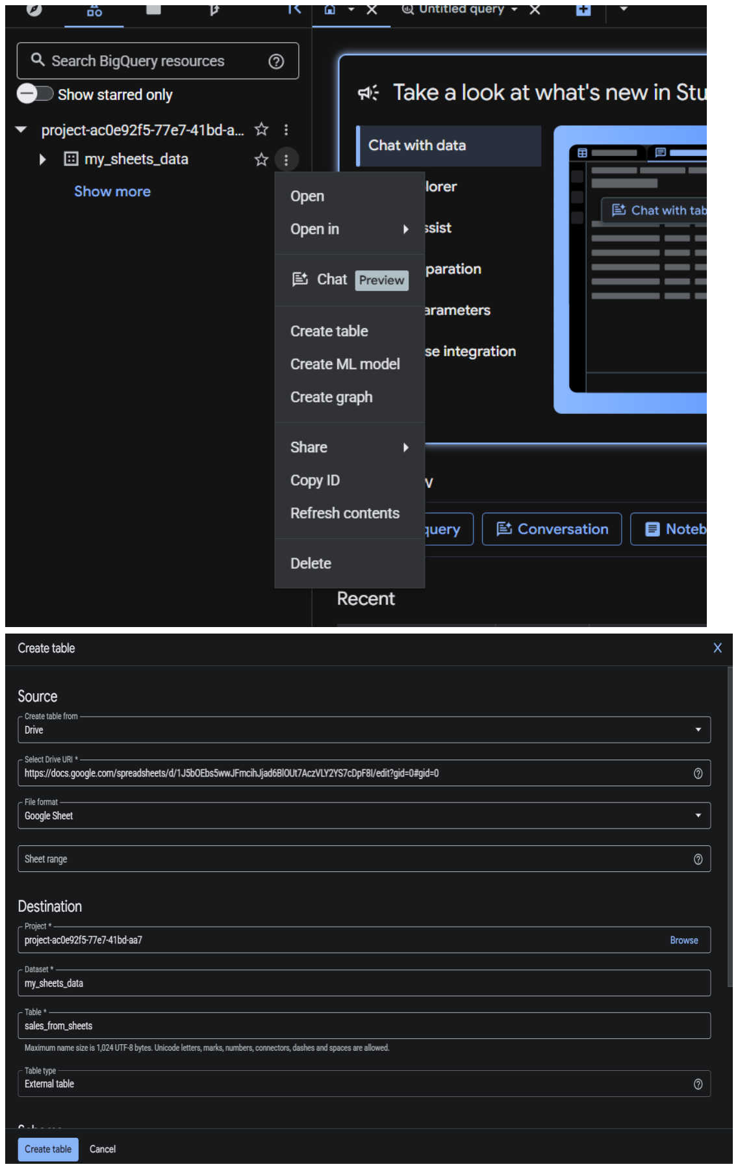
[picture p23: page 5]
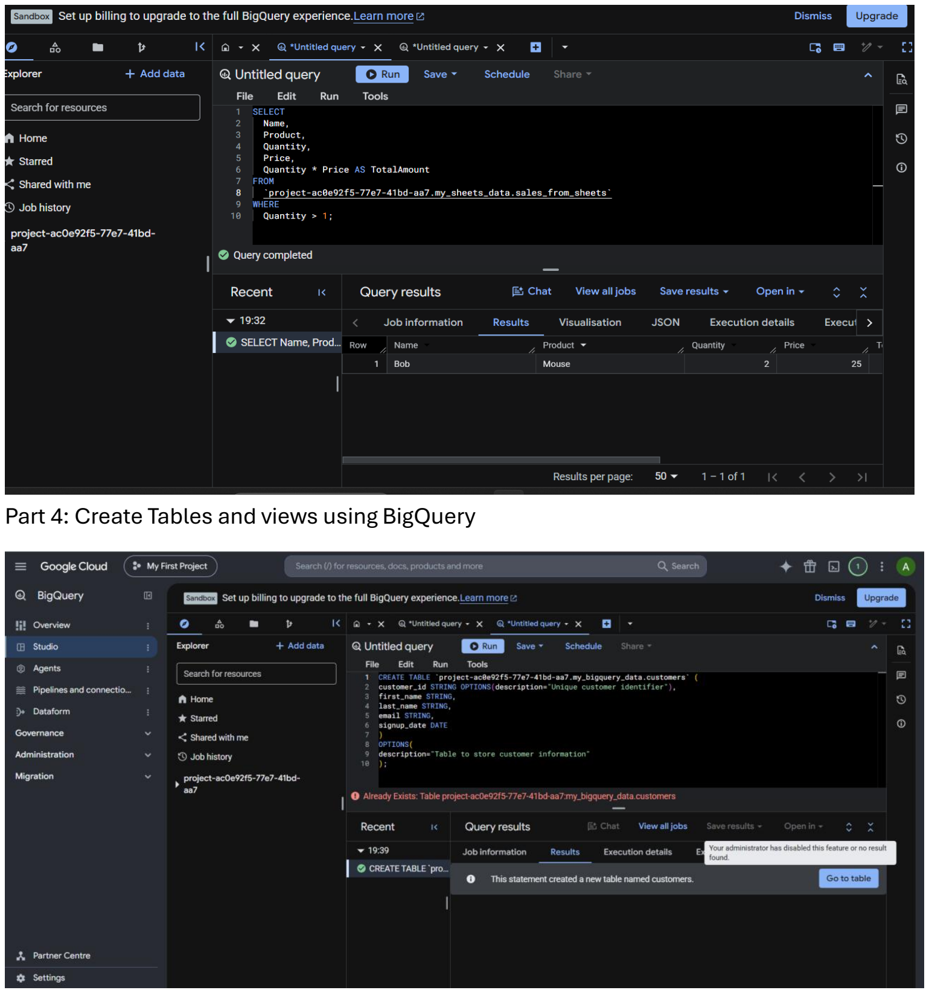
[picture p24: page 6]

Part 4: Create Tables and views using BigQuery

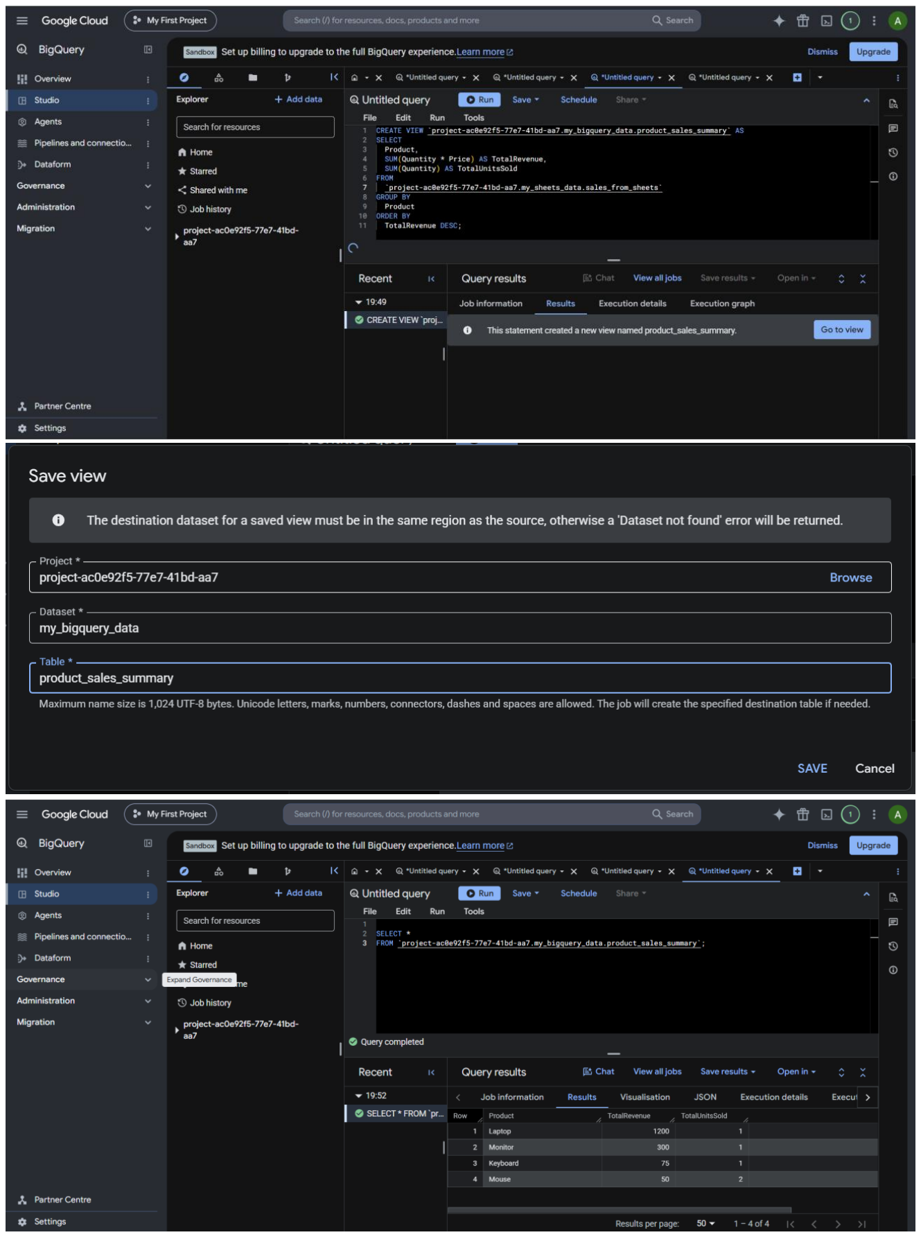
[picture p25: page 7]
