Dhaval437/Baymax/output/CCD Practicals - Dhaval Gandhi/CCD Practical 09.pdf

# Practical no. 9

# Step1: Set up AWS account and IAM

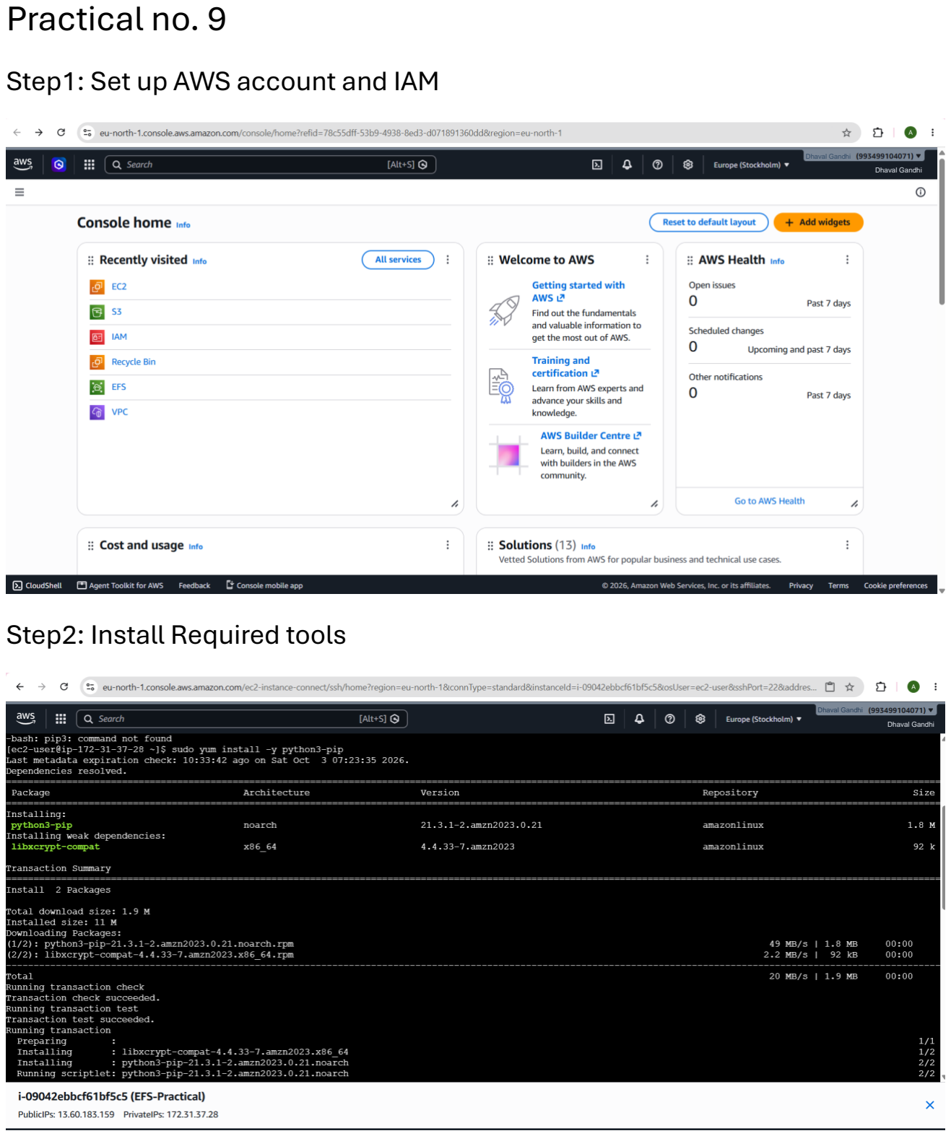
[picture p26: page 1]

# Step2: Install Required tools

Dhaval Gandhi
Dhaval Gandhi

Dhaval Gandhi
Dhaval Gandhi

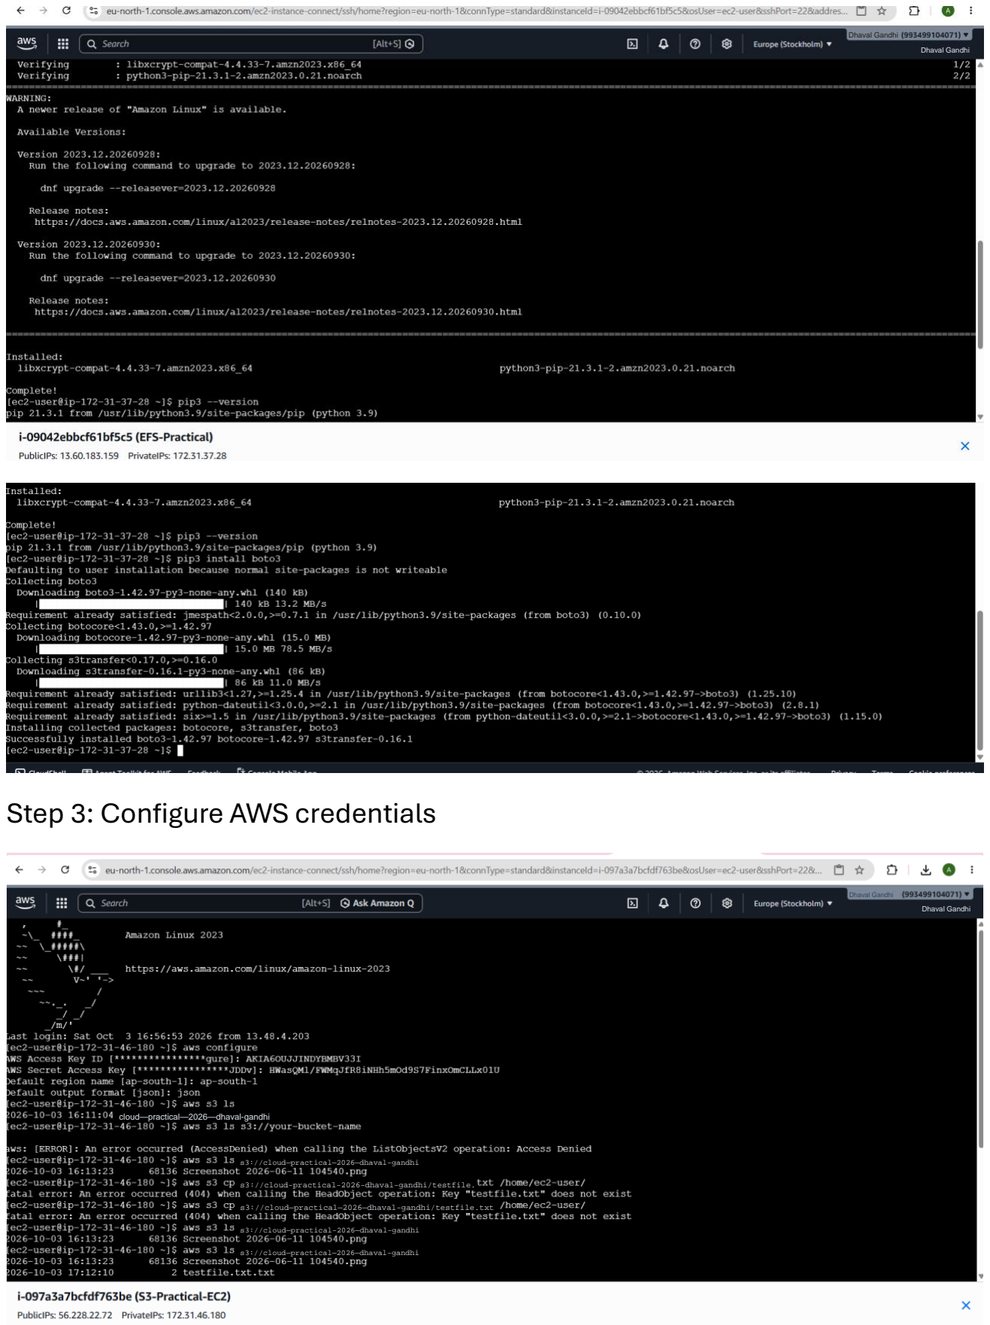
[picture p27: page 2]

# Step 3: Configure AWS credentials

Dhaval Gandhi

Dhaval Gandhi

Dhaval Gandhi
Dhaval Gandhi

### cloud—practical—2026—dhaval-gandhi

s3://cloud—practical—2026—dhaval-gandhi

s3://cloud-practical-2026-dhaval-gandhi/testfile.

s3://cloud—practical—2026—dhaval-gandhi/testfile.txt

s3://cloud—practical-2026—dhaval-gandhi

s3://cloud—practical—2026—dhaval-gandhi

# Step 4: Plan Your Script

# Step 5: initialize the Boto3 S3 client

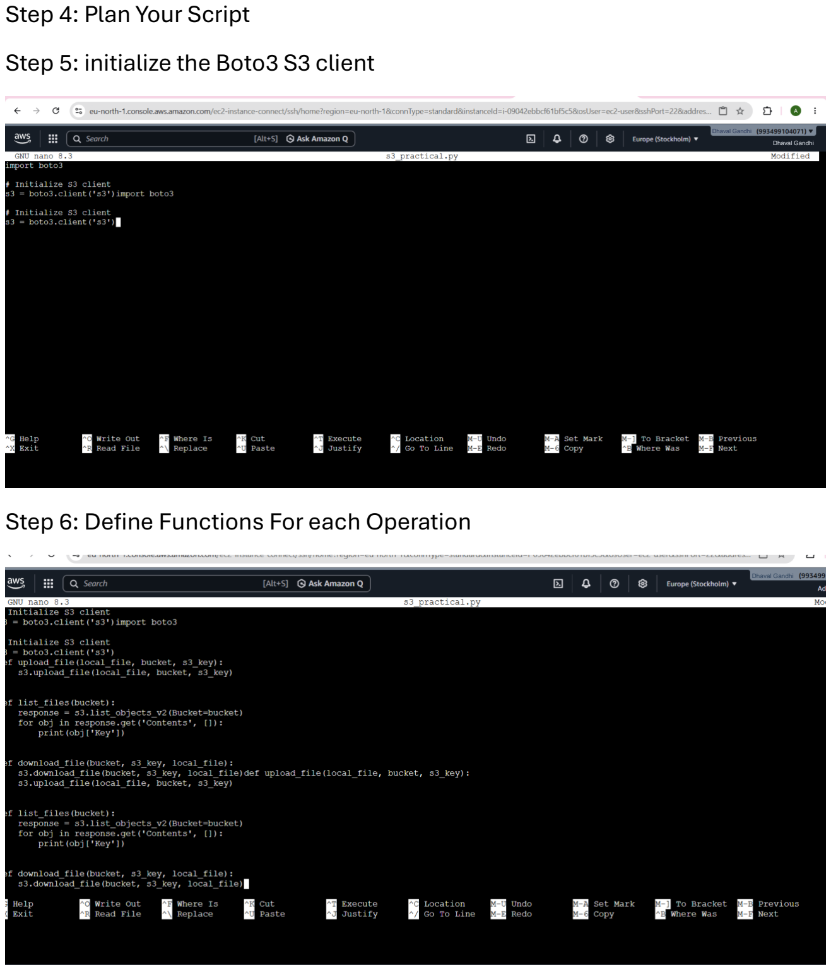
[picture p28: page 3]

# Step 6: Define Functions For each Operation

Dhaval Gandhi
Dhaval Gandhi

Dhaval Gandhi

# Step 7: Put it all together

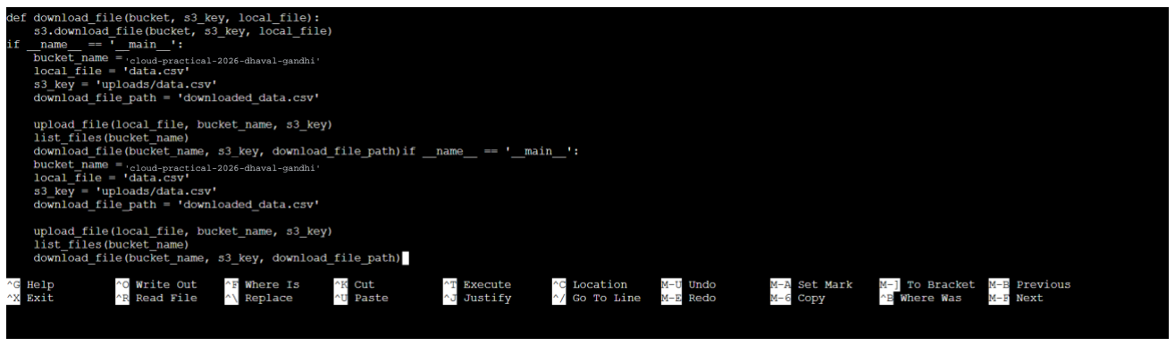
[picture p29: figure]
'cloud-practical-2026-dhaval-gandhi'

# Step 8: Test and Debug

# Step 9: Secure your Script

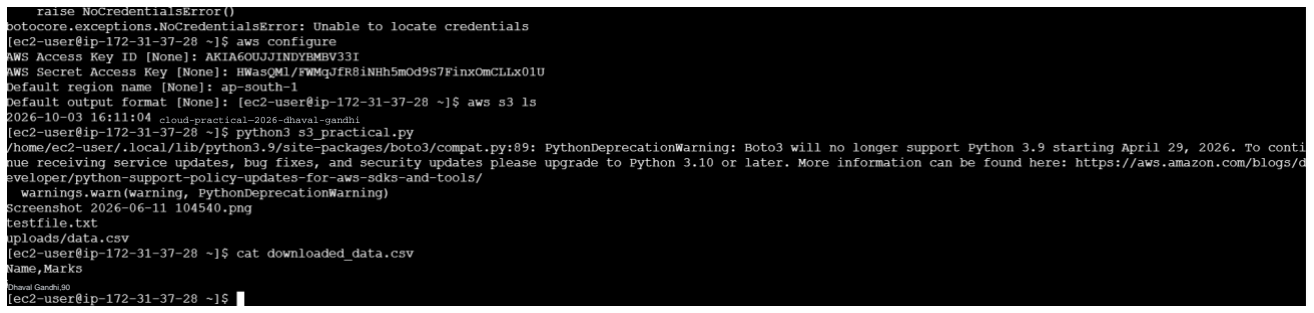
[picture p30: figure]
cloud-practical—2026-dhaval-gandhi; Dhaval Gandhi,90
