Dhaval437/Baymax/output/CCD Practicals - Dhaval Gandhi/CCD Practical 11.pdf

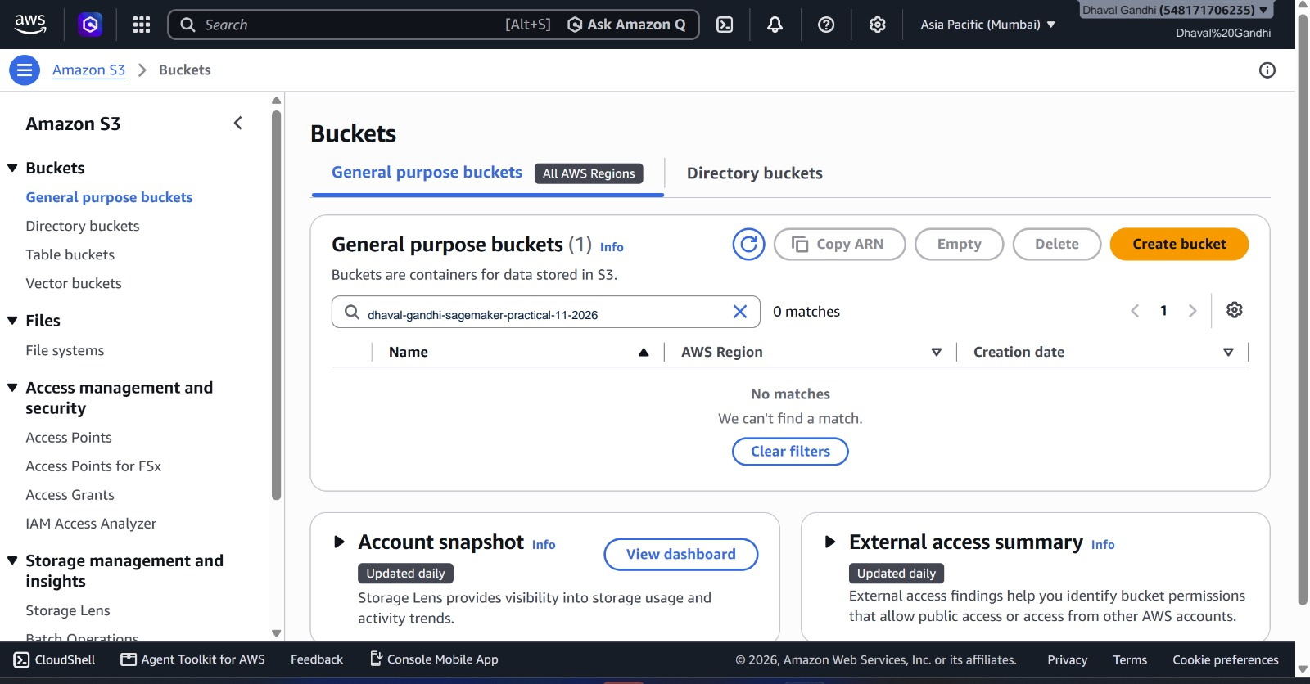
[picture p31: page 1]

dhaval-gandhi-sagemaker-practical-11-2026

Dhaval Gandhi
Dhaval%20Gandhi

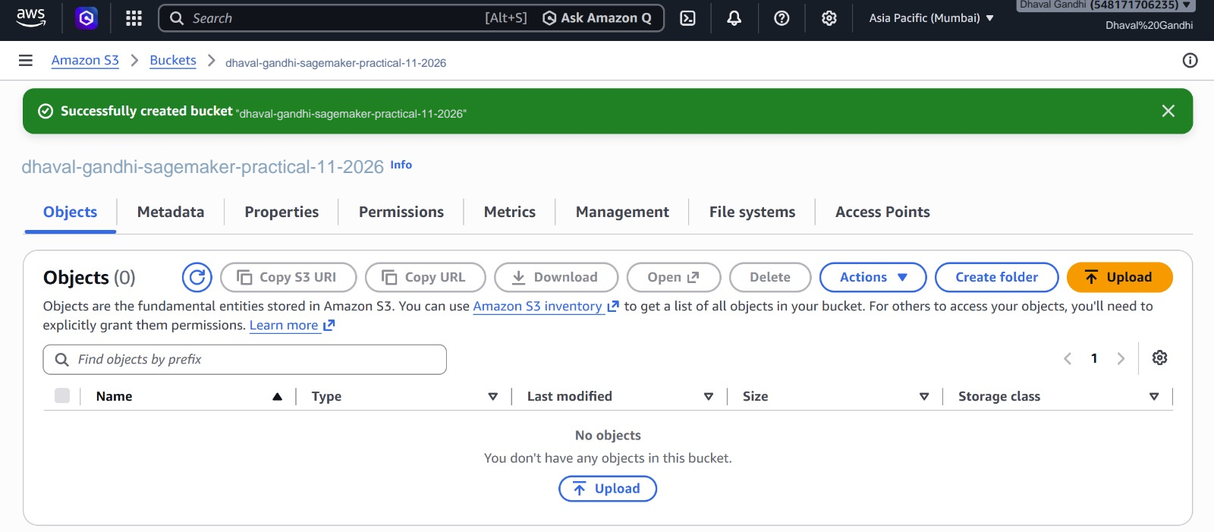
[picture p32: page 2]

dhaval-gandhi-sagemaker-practical-11-2026

"dhaval-gandhi-sagemaker-practical-11-2026"

## Dhaval Gandhi dhaval-gandhi-sagemaker-practical-11-2026

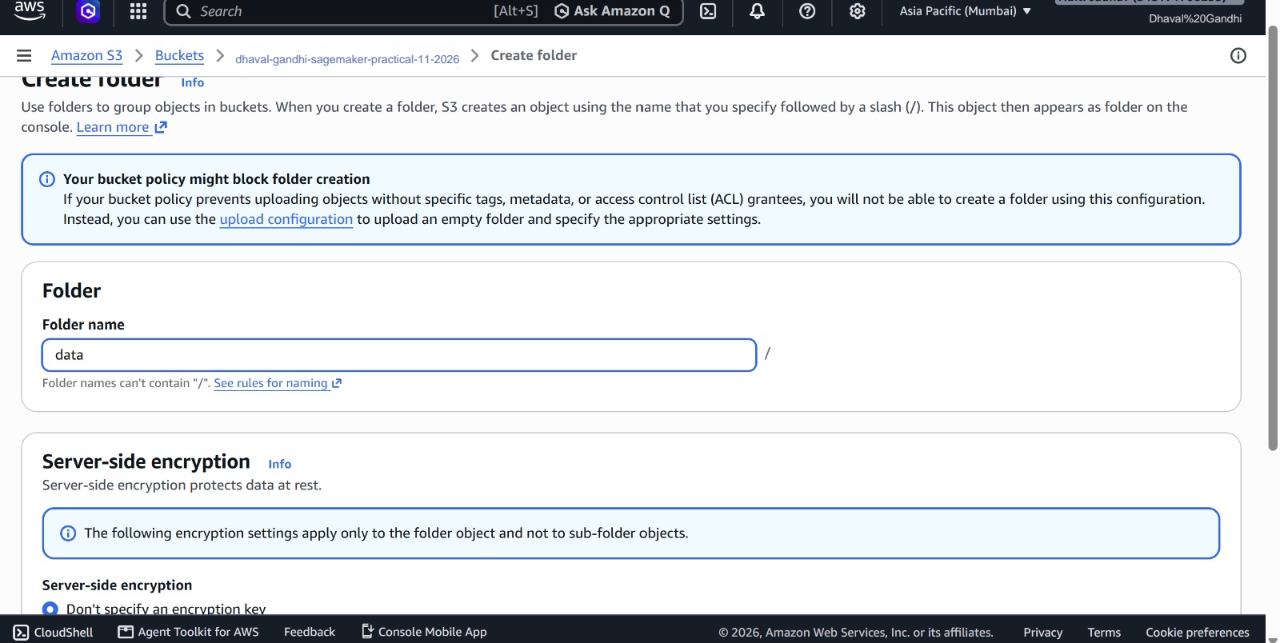
[picture p33: page 3]

dhaval-gandhi-sagemaker-practical-11-2026

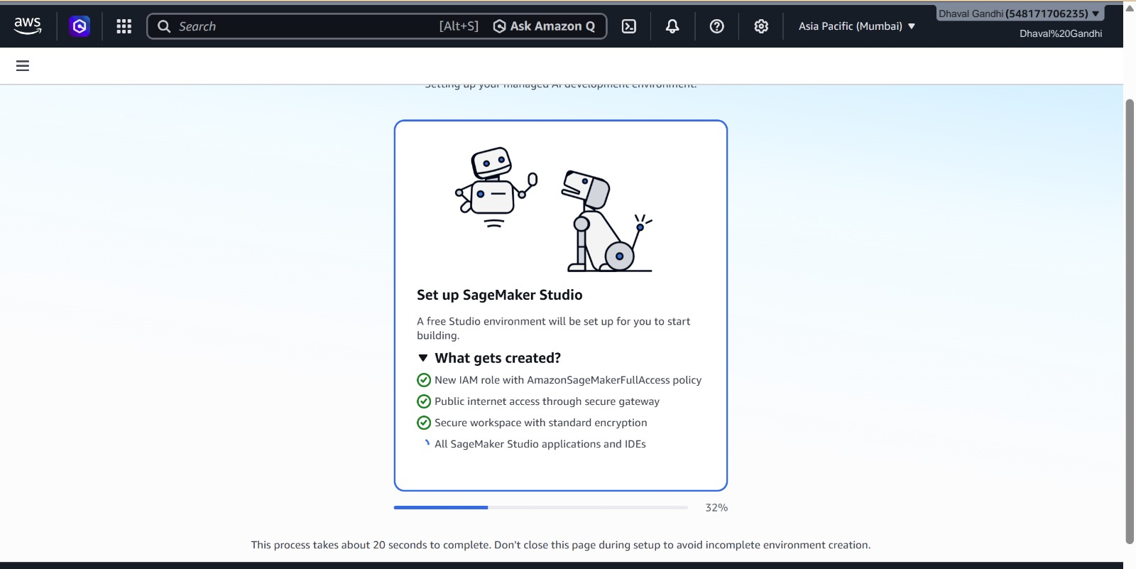
[picture p34: page 4]
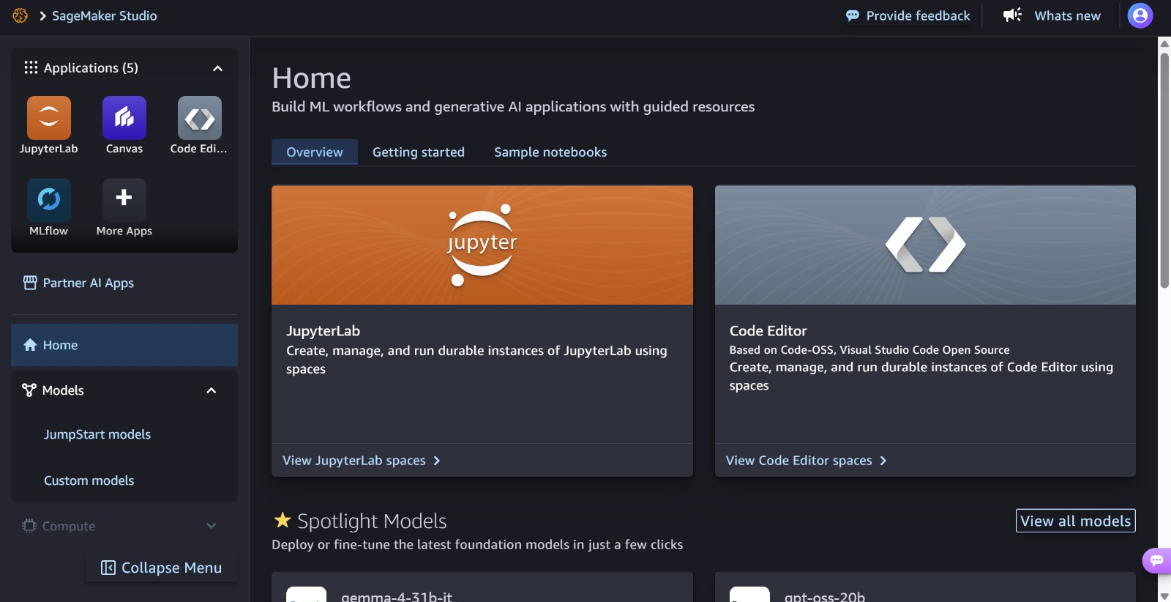
[picture p35: page 5]
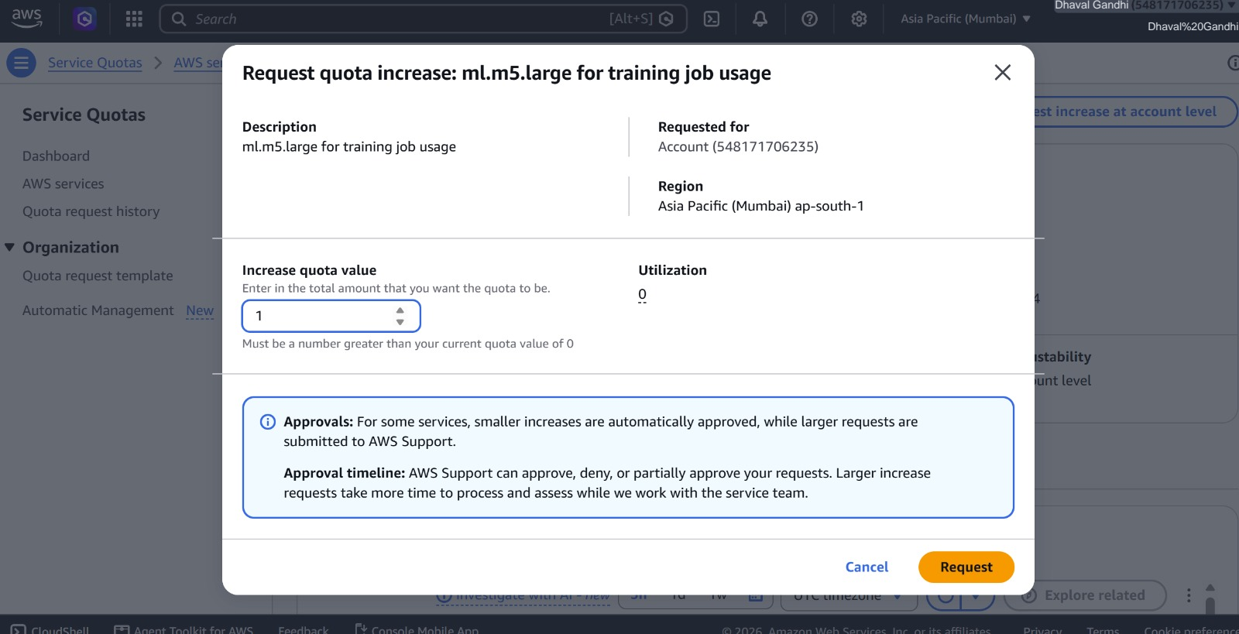
[picture p36: page 6]
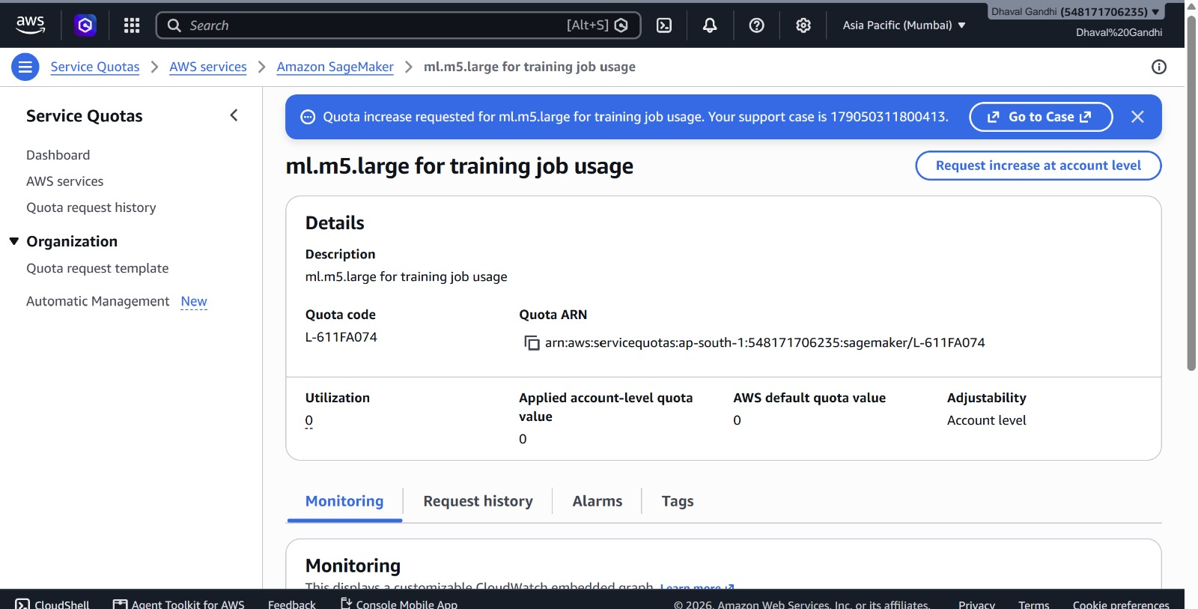
[picture p37: page 7]
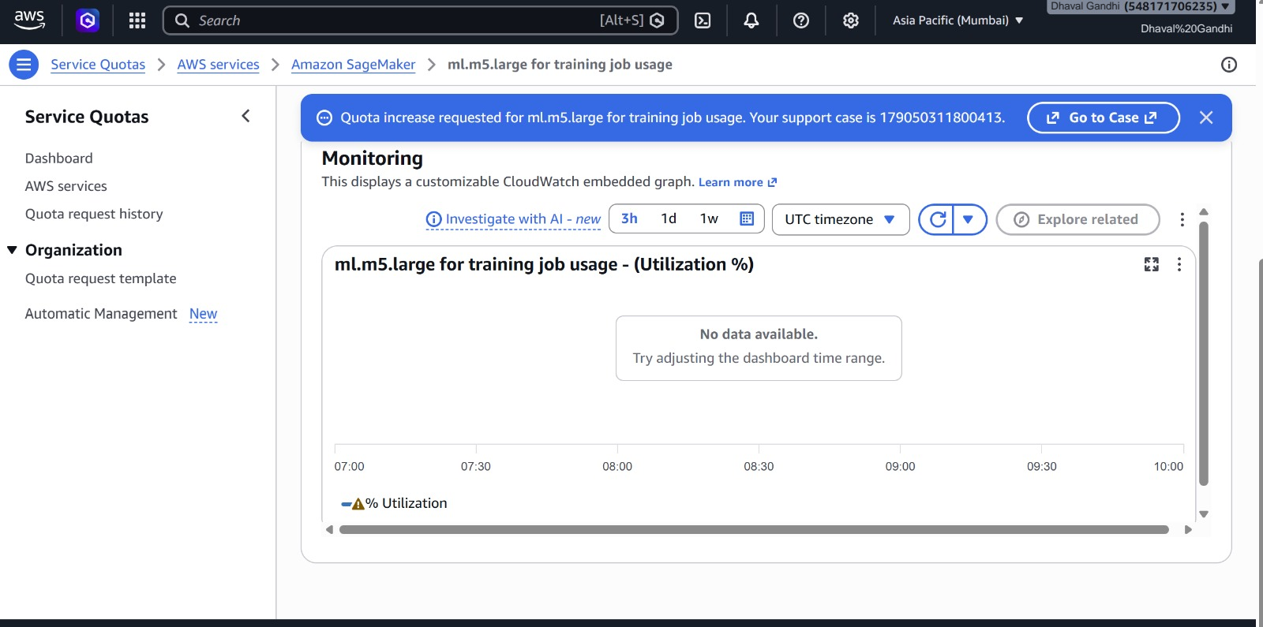
[picture p38: page 8]
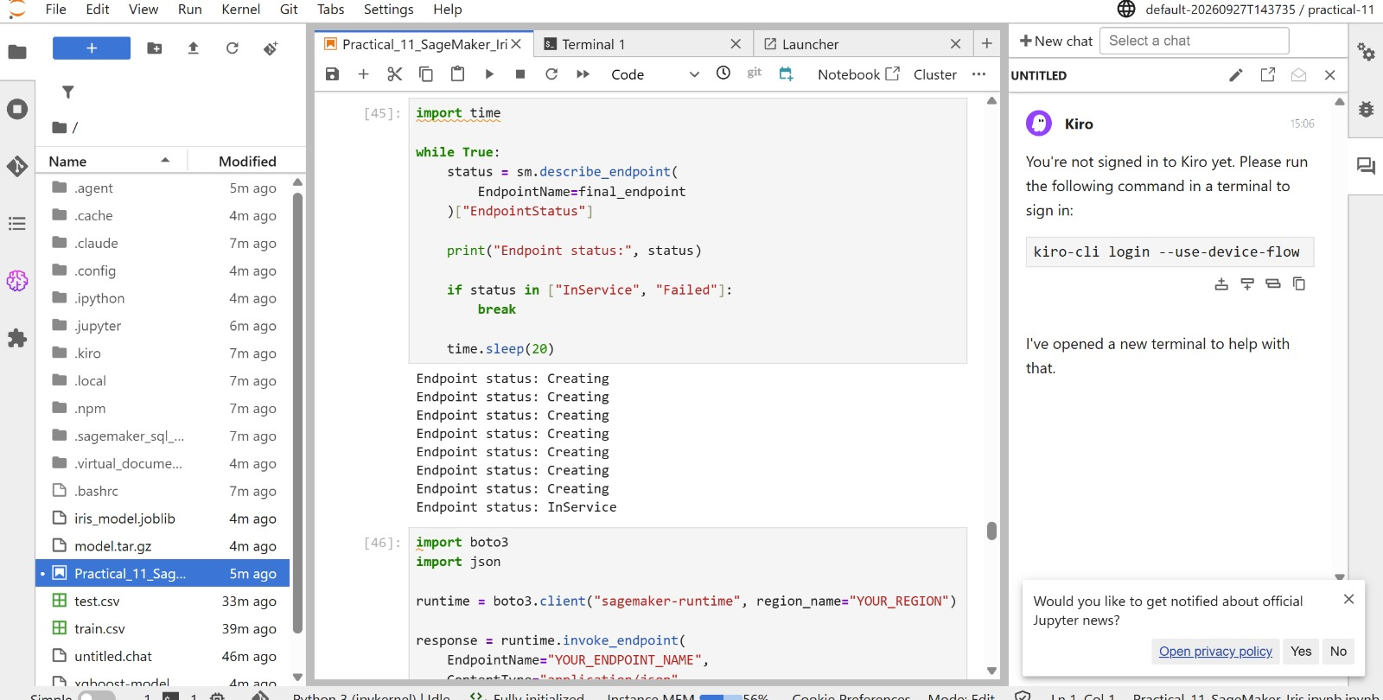
[picture p39: page 9]
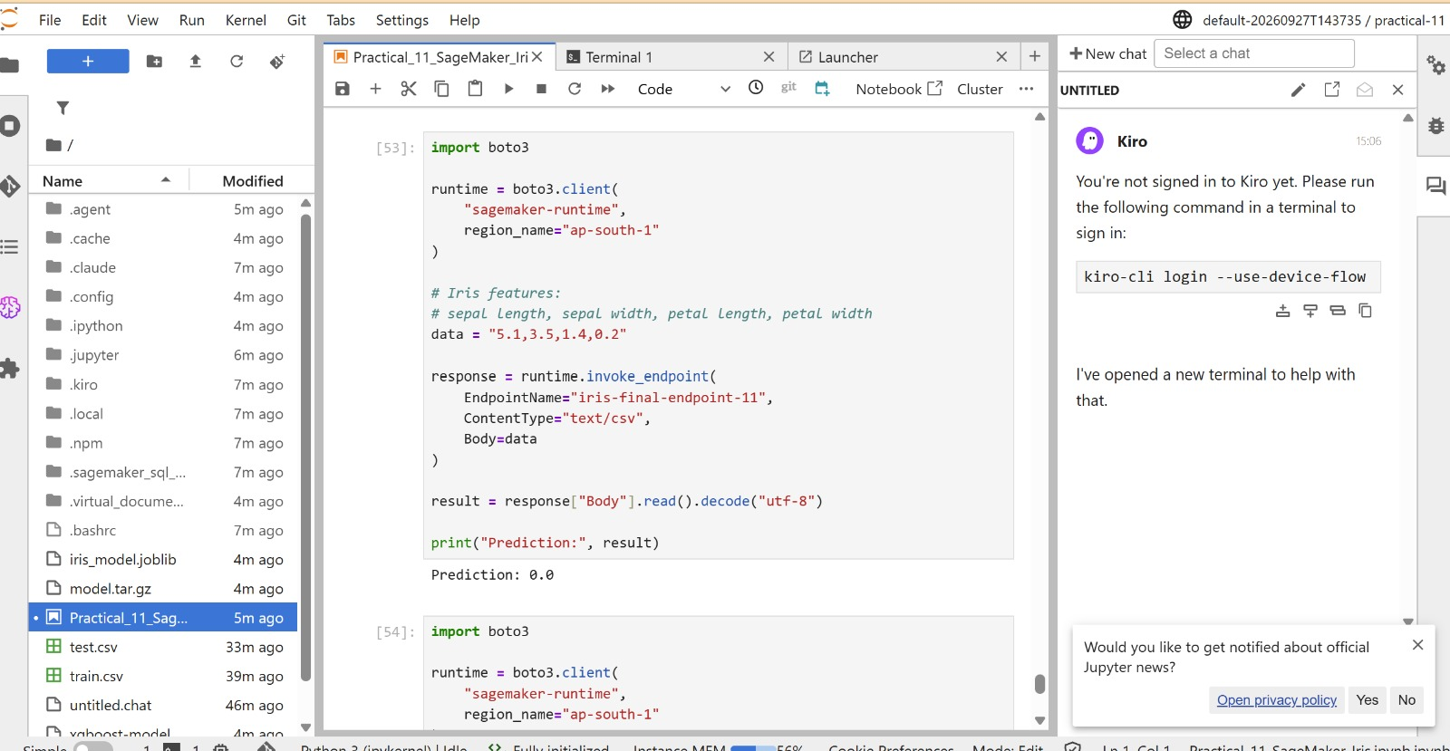
[picture p40: page 10]
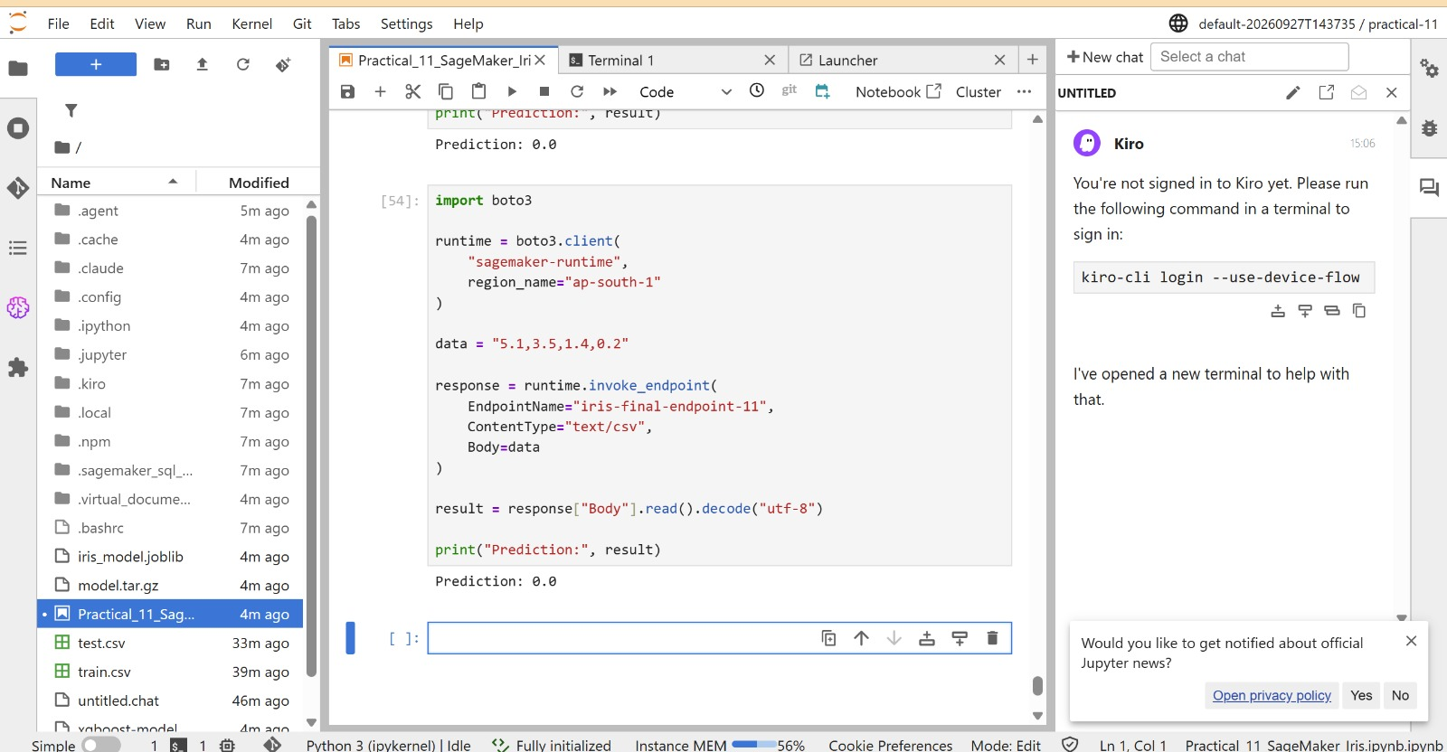
[picture p41: page 11]
