Dhaval437/Baymax/assembly/automatic-listening-concept-v2.png

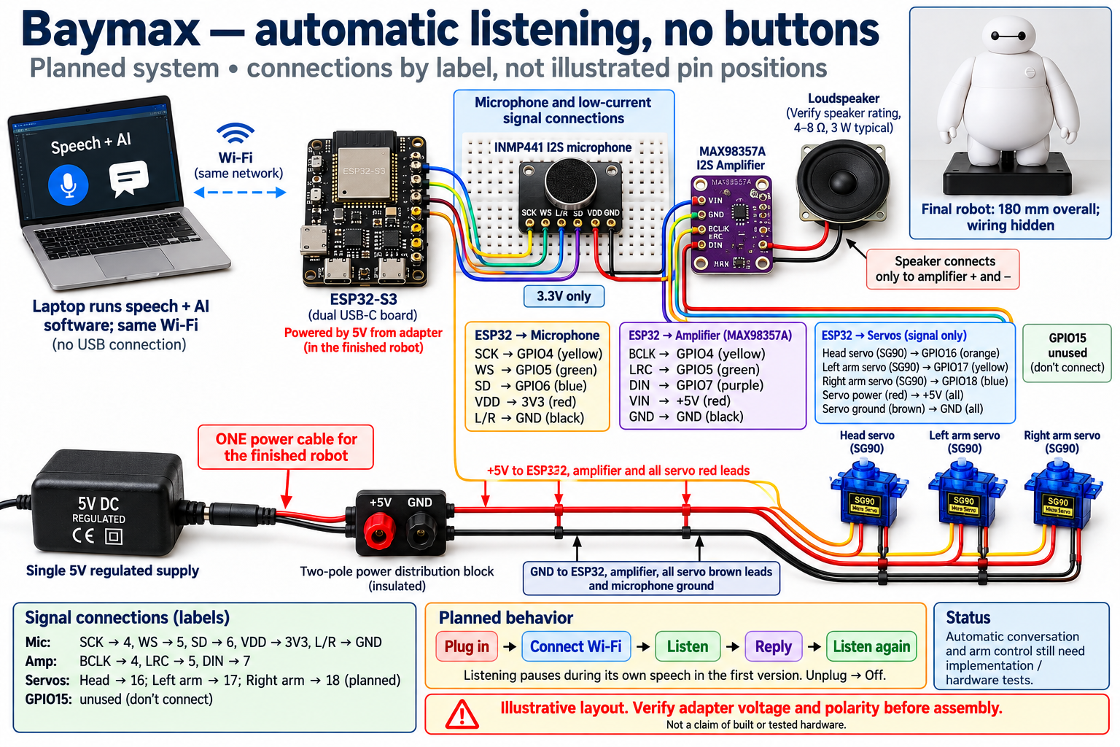
assembly/automatic-listening-concept-v2.png
