Dhaval437/Baymax/assembly/bench-overview-concept.png

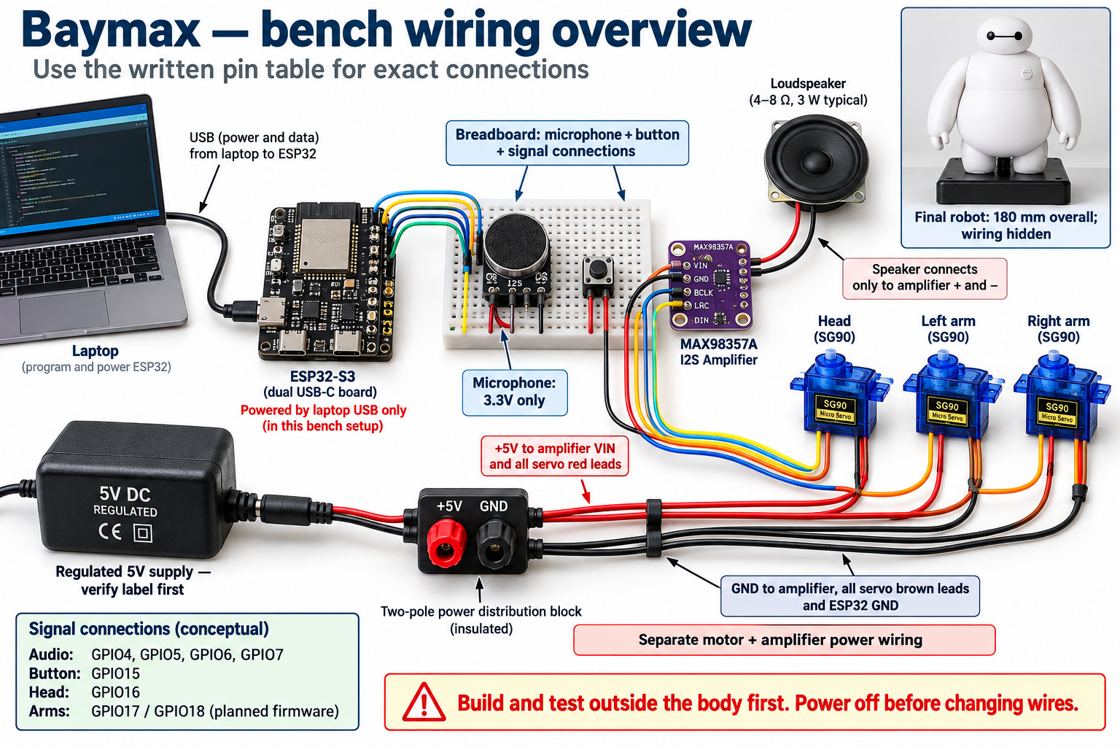
assembly/bench-overview-concept.png
