Dhaval437/Baymax/assembly/esp32-usbc-panel-mount-concept.png

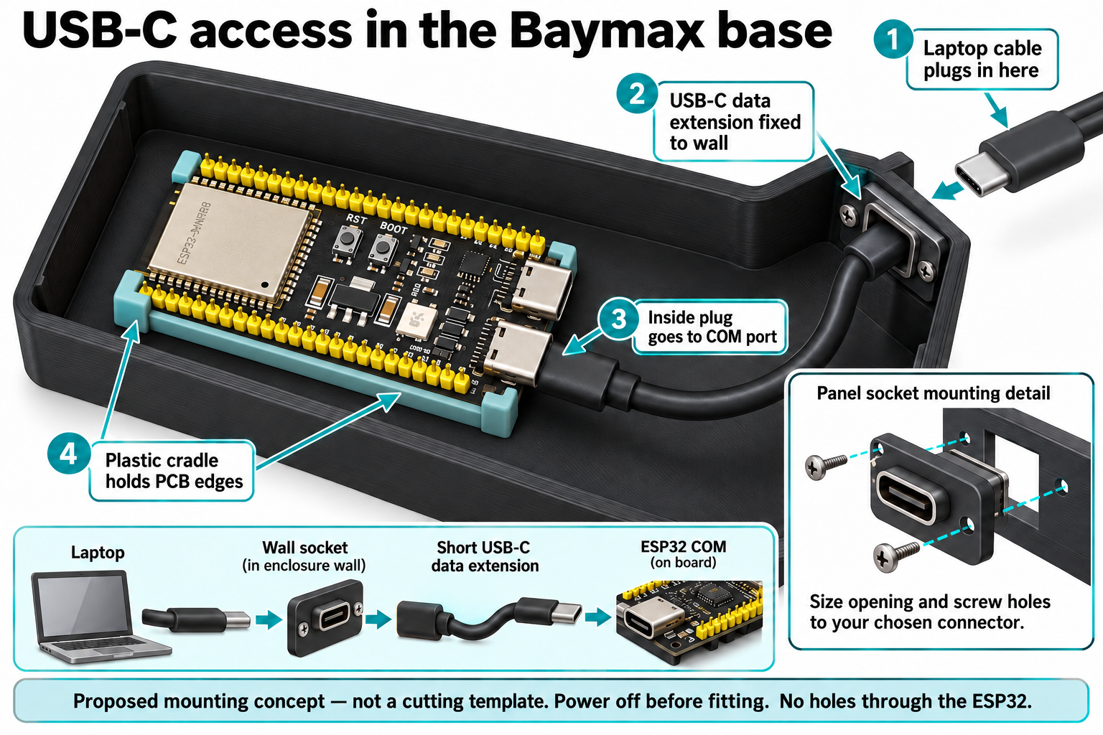
assembly/esp32-usbc-panel-mount-concept.png
