Dhaval437/Baymax/mechanical/arm_extension_10mm_5mm_fit/adapter_dimensions.png

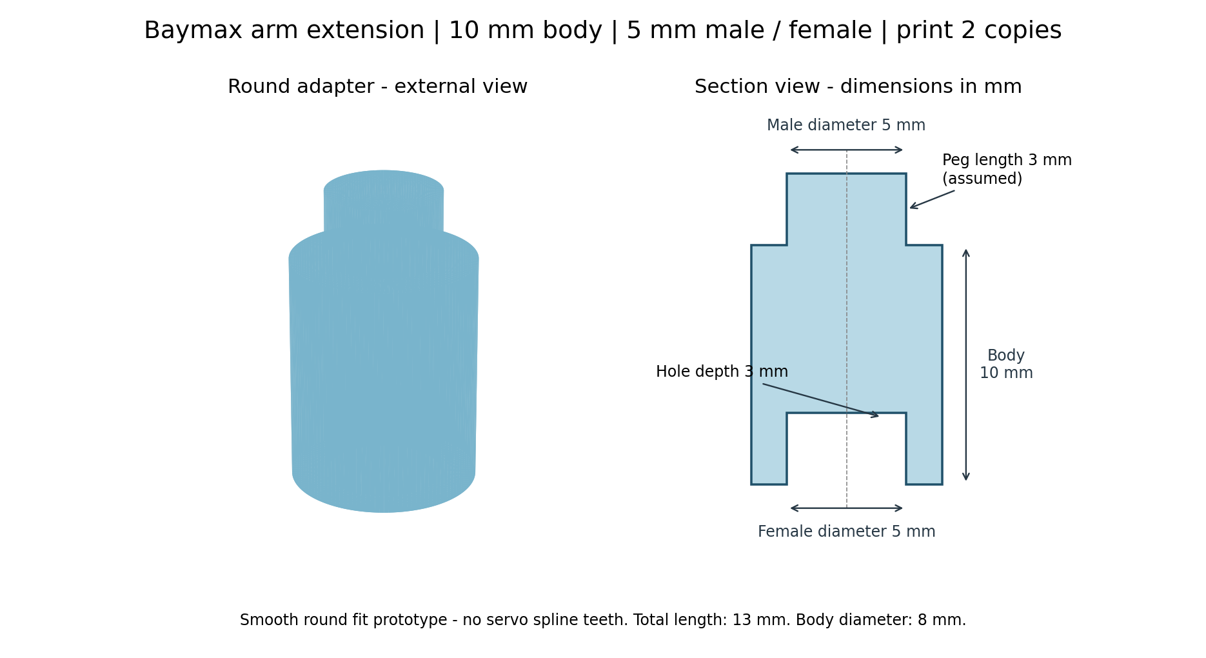
mechanical/arm_extension_10mm_5mm_fit/adapter_dimensions.png
