Dhaval437/Baymax/mechanical/blender/preview_front.png

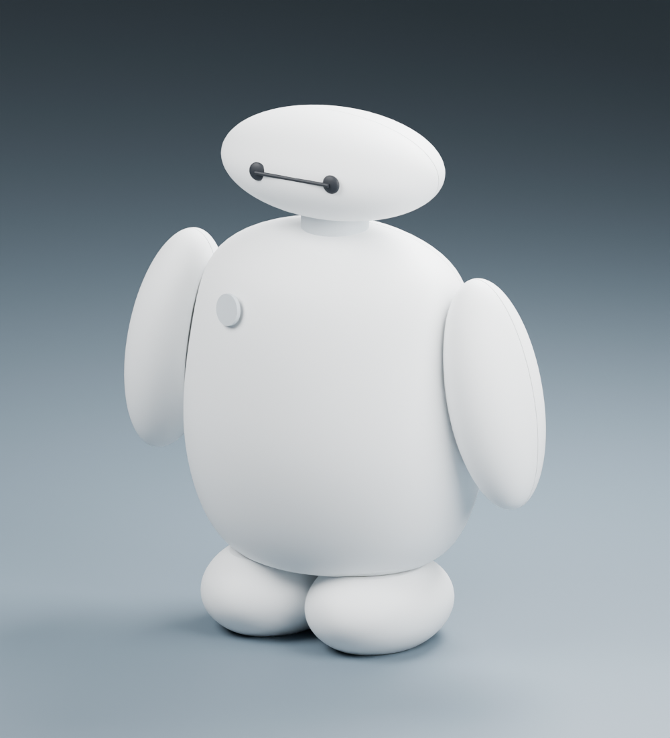
mechanical/blender/preview_front.png
