Dhaval437/Baymax/mechanical/blender/preview_packaging.png

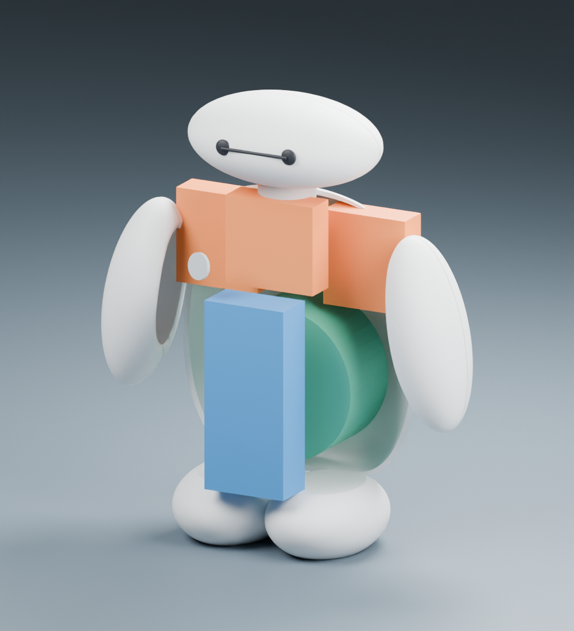
mechanical/blender/preview_packaging.png
