Dhaval437/Baymax/mechanical/blender/preview_rear.png

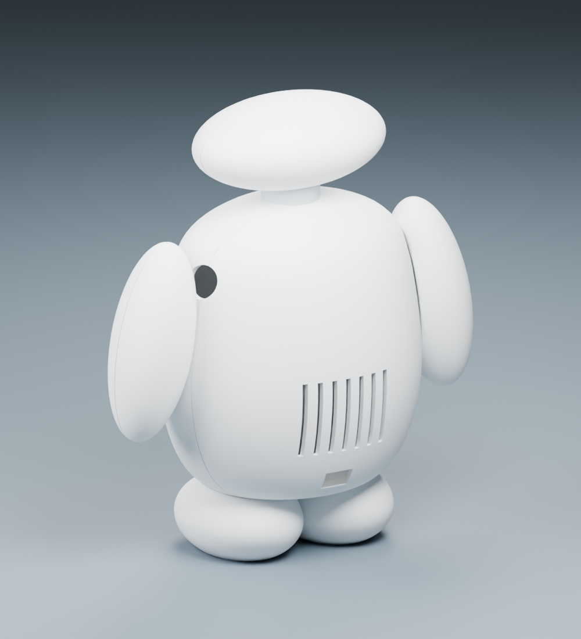
mechanical/blender/preview_rear.png
