Dhaval437/Baymax/mechanical/production_180/fit_plate_preview.png

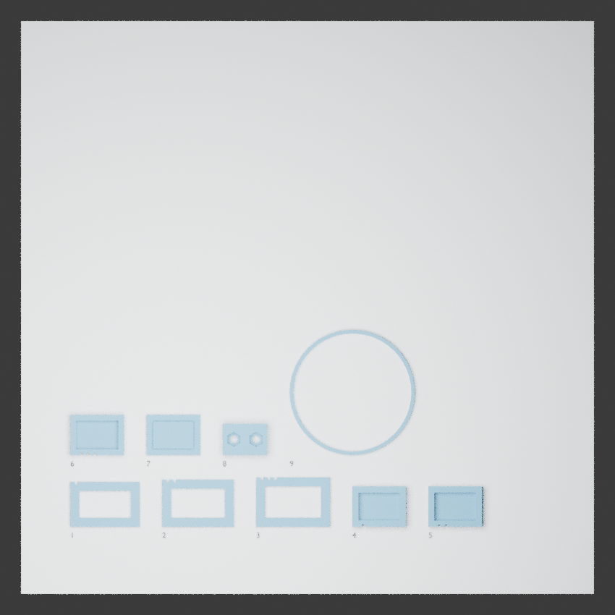
mechanical/production_180/fit_plate_preview.png
