Dhaval437/Baymax/mechanical/production_180/panel_fasteners_v2/service_panels_exploded.png

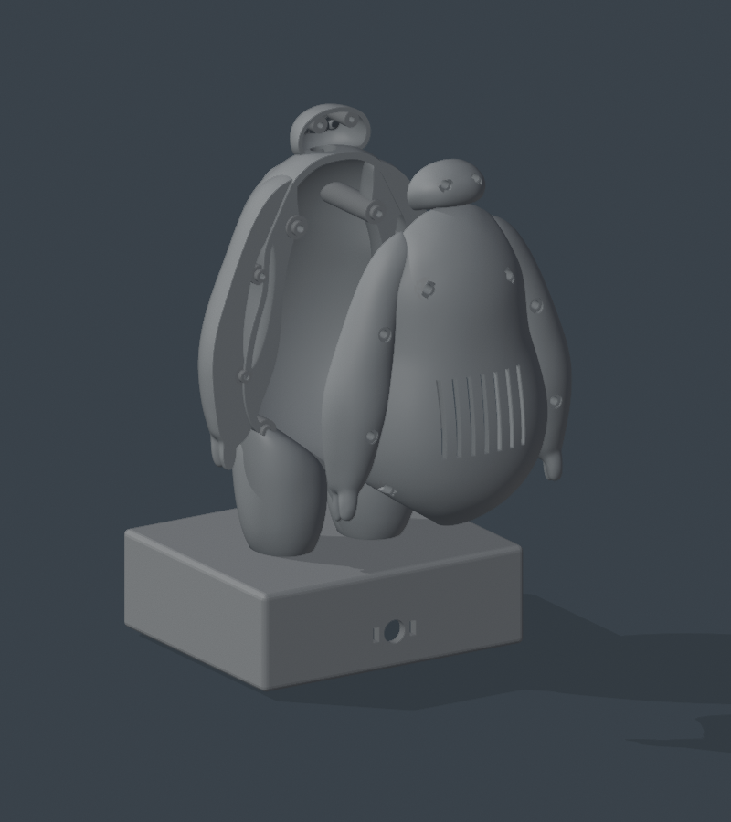
mechanical/production_180/panel_fasteners_v2/service_panels_exploded.png
