Dhaval437/Baymax/mechanical/reference_model/both_arms_down.png

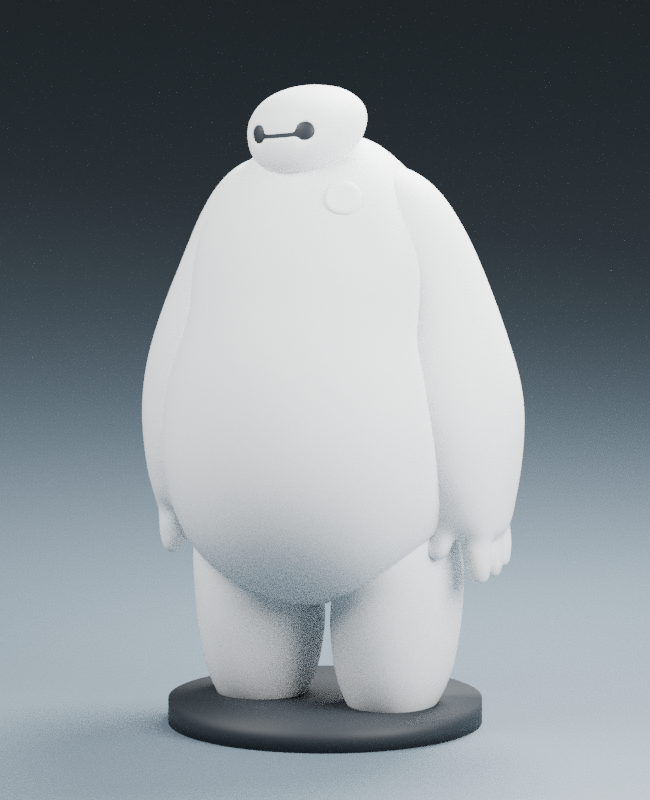
mechanical/reference_model/both_arms_down.png
