Dhaval437/Baymax/mechanical/reference_model/both_arms_down_front.png

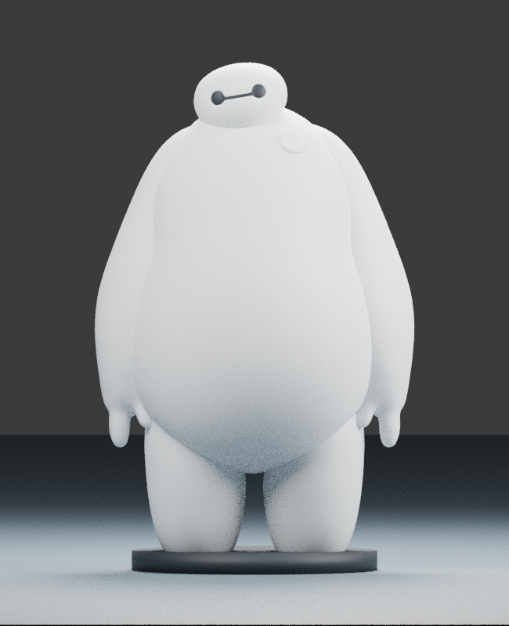
mechanical/reference_model/both_arms_down_front.png
