Dhaval437/Baymax/mechanical/reference_model/original_front.png

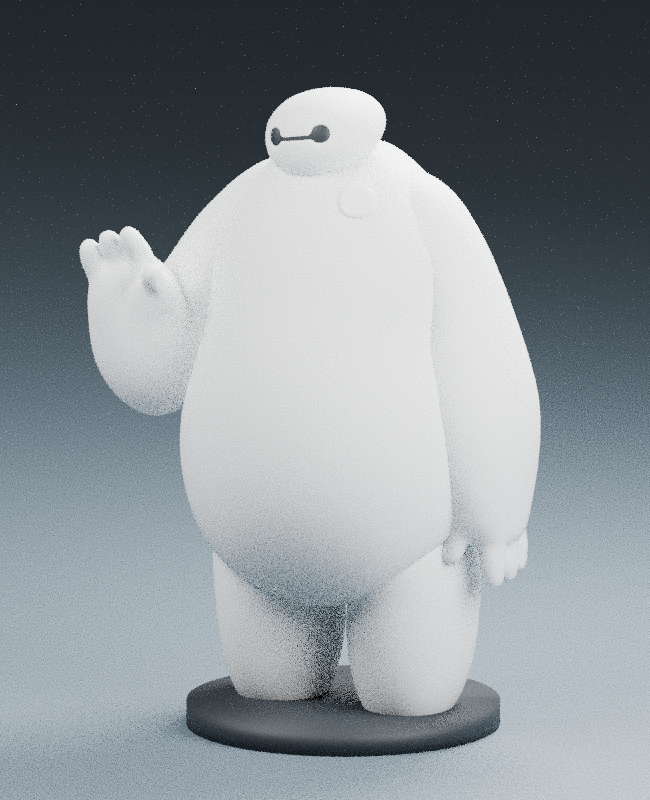
mechanical/reference_model/original_front.png
