Dhaval437/Baymax/mechanical/reference_model/original_reverse.png

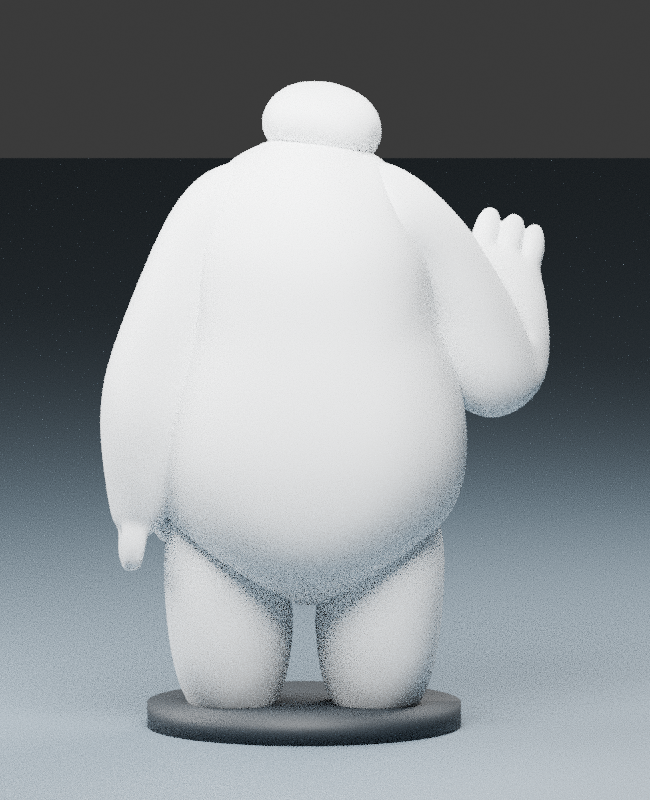
mechanical/reference_model/original_reverse.png
