Dhaval437/Baymax/mechanical/reference_model/source_preview.png

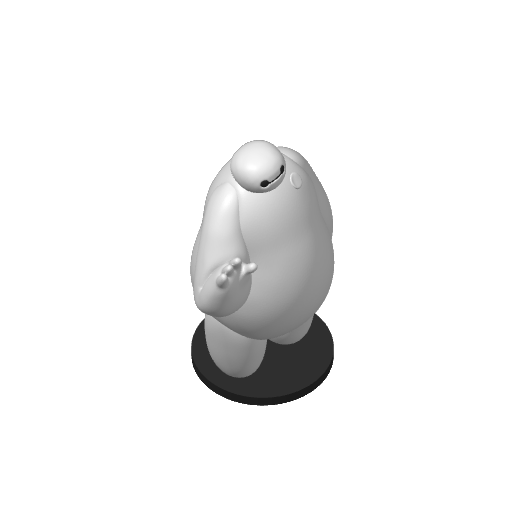
mechanical/reference_model/source_preview.png
