Dhaval437/Baymax/mechanical/servo_fit_gauge/preview.png

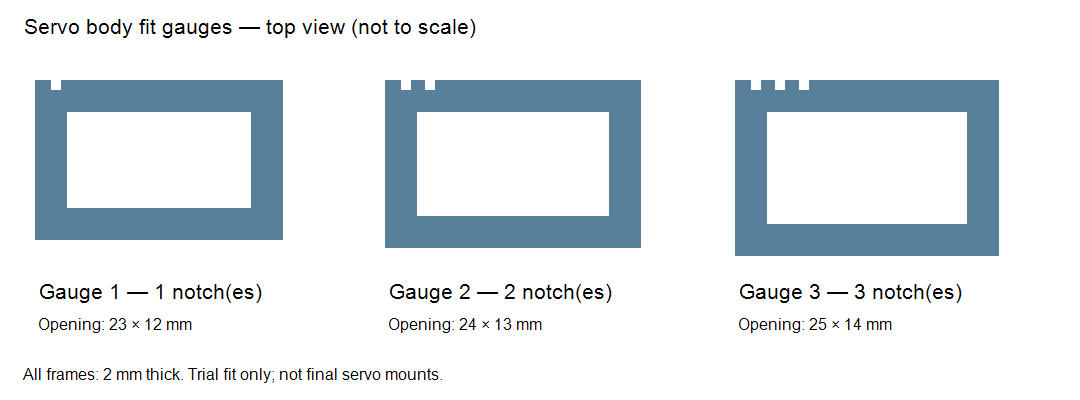
mechanical/servo_fit_gauge/preview.png
