Dhaval437/Baymax/assembly/component-placement-oct18.png

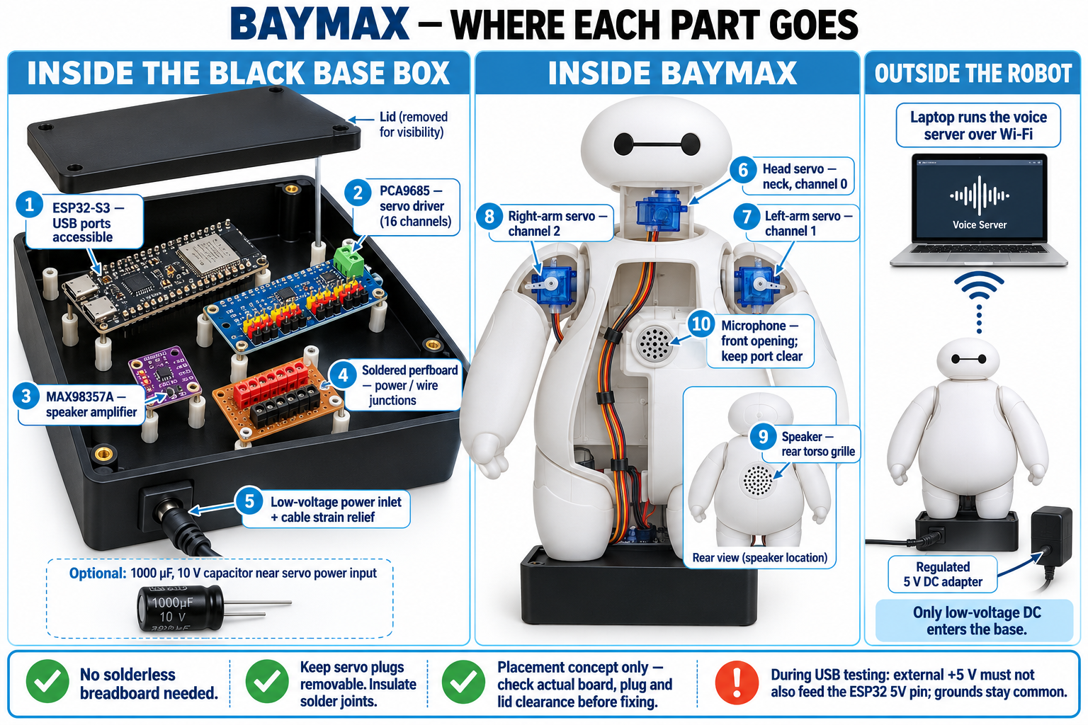
assembly/component-placement-oct18.png
