Dhaval437/Baymax/assembly/head-parts-cad-reference.png

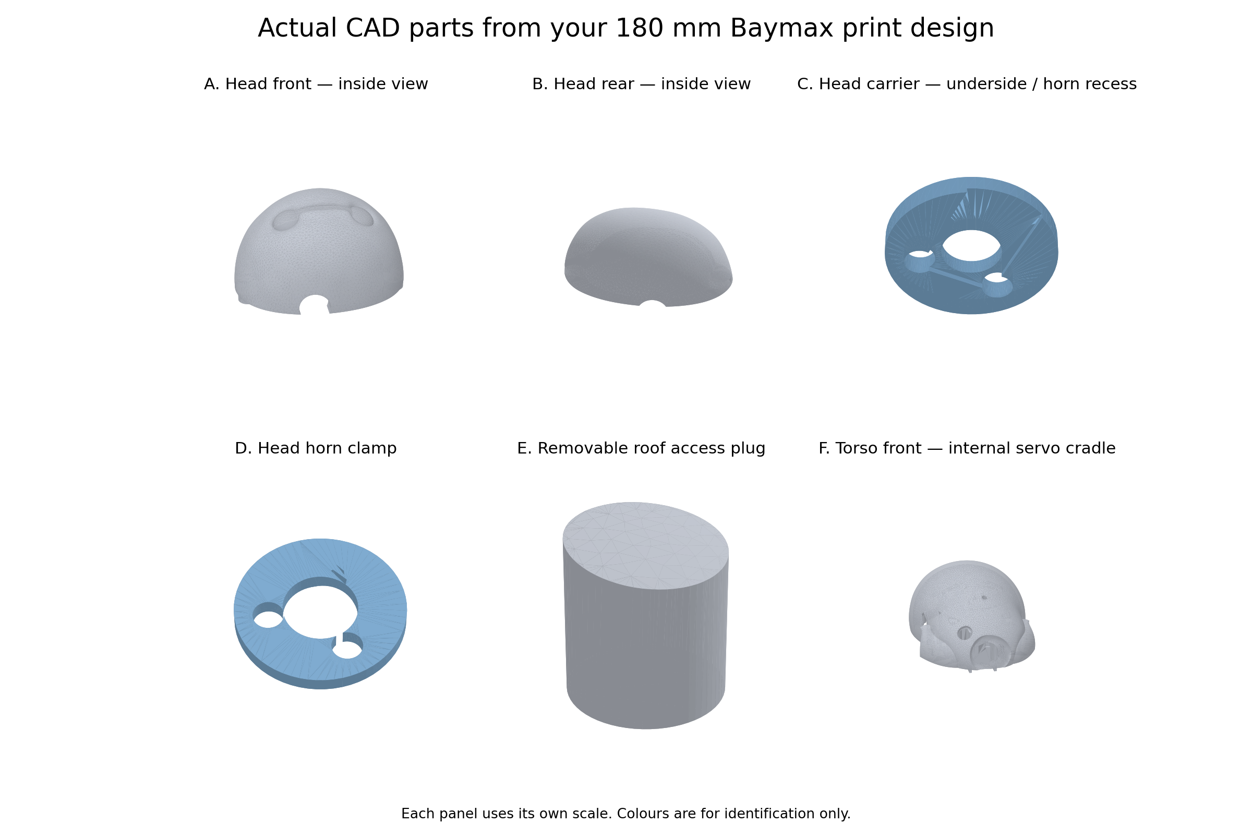
assembly/head-parts-cad-reference.png
