Dhaval437/Baymax/assembly/arm-cad/06_Left_arm_and_hand_rear_DRAFT.stl

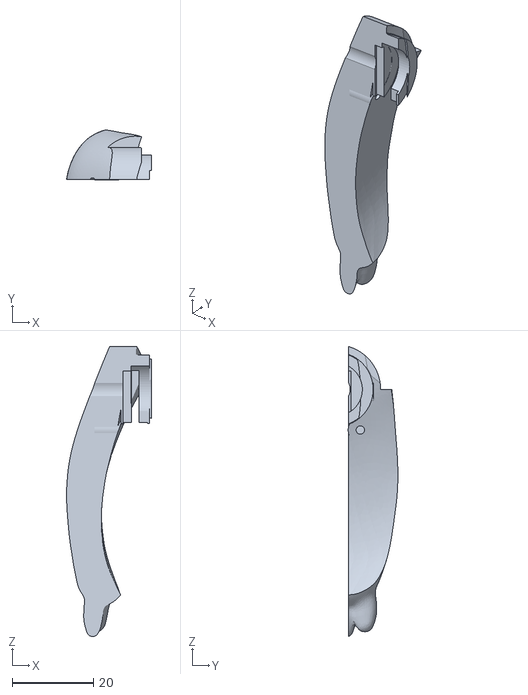
[picture p59: CAD file, 2026-10-17]
assembly/arm-cad/06_Left_arm_and_hand_rear_DRAFT.stl
20.9 x 12.2 x 71.3
