Dhaval437/Baymax/assembly/head-cad/07_head_horn_clamp_DRAFT.stl

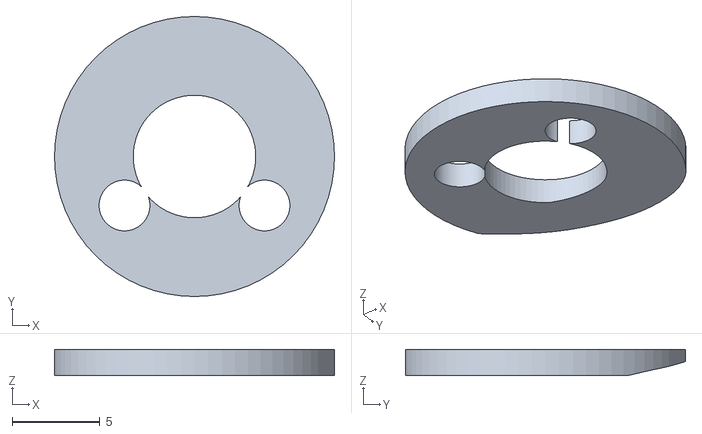
[picture p60: CAD file, 2026-10-17]
assembly/head-cad/07_head_horn_clamp_DRAFT.stl
16.0 x 16.0 x 1.50
