Dhaval437/Baymax/mechanical/arm_extension_10mm/Baymax_arm_extension_10mm_single.stl

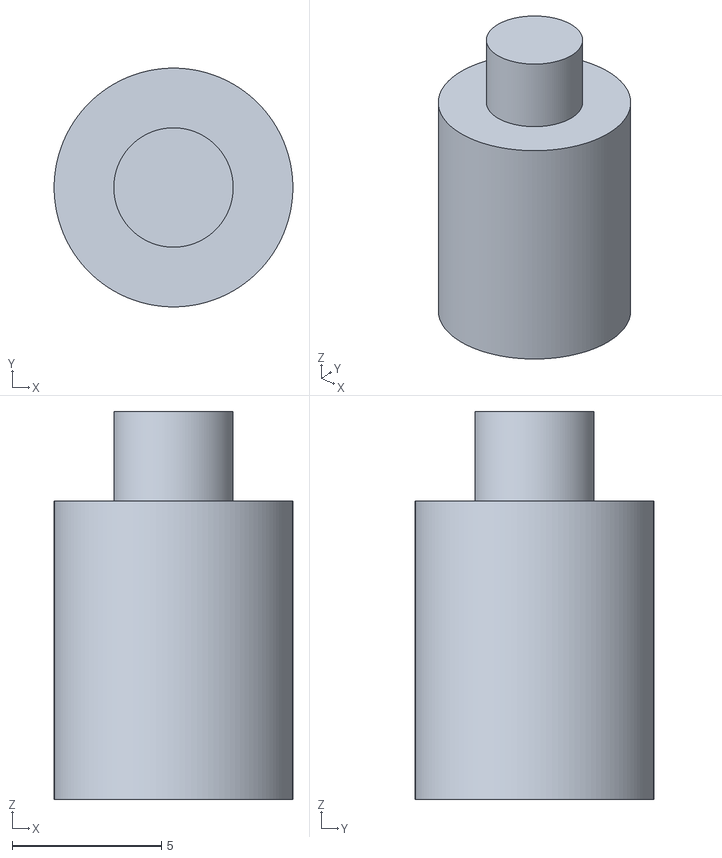
[picture p61: CAD file, 2026-10-17]
mechanical/arm_extension_10mm/Baymax_arm_extension_10mm_single.stl
8.00 x 8.00 x 13.0
