Dhaval437/Baymax/mechanical/arm_extension_10mm_5mm_fit/Baymax_arm_extension_10mm_5mm_single.stl

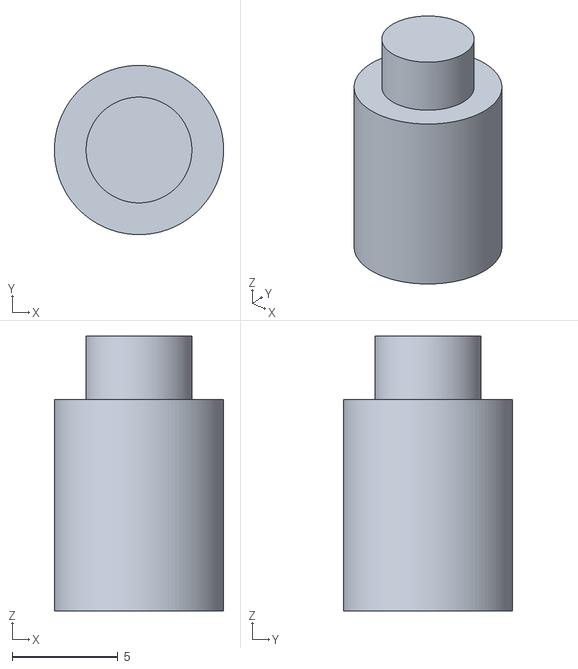
[picture p62: CAD file, 2026-10-19]
mechanical/arm_extension_10mm_5mm_fit/Baymax_arm_extension_10mm_5mm_single.stl
8.00 x 8.00 x 13.0
