Dhaval437/Baymax/mechanical/arm_extension_5mm_5mm_fit/Baymax_arm_extension_5mm_5mm_pair.stl

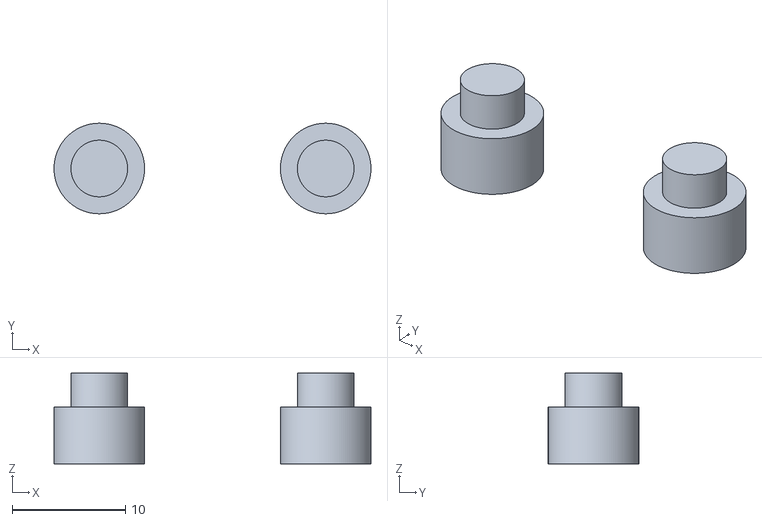
[picture p63: CAD file, 2026-10-20]
mechanical/arm_extension_5mm_5mm_fit/Baymax_arm_extension_5mm_5mm_pair.stl
28.0 x 8.00 x 8.00
