Dhaval437/Baymax/mechanical/blender/draft_stl/05_right_foot_DRAFT.stl

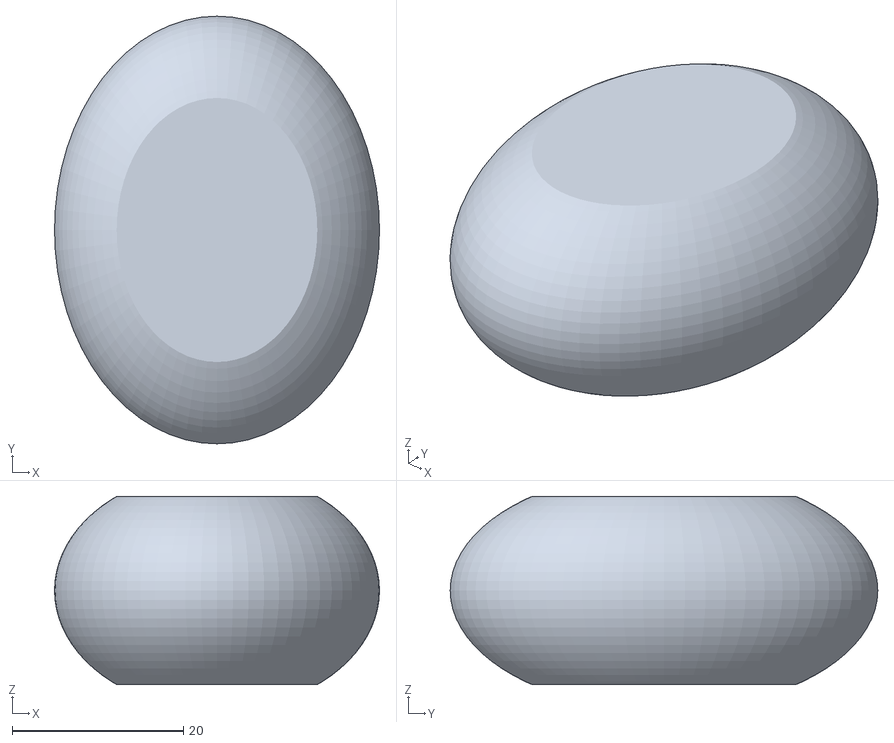
[picture p64: CAD file, 2026-10-17]
mechanical/blender/draft_stl/05_right_foot_DRAFT.stl
38.0 x 50.0 x 22.0
