Dhaval437/Baymax/mechanical/head_led_3mm/assembly_meshes/03_Right_LED_retainer.stl

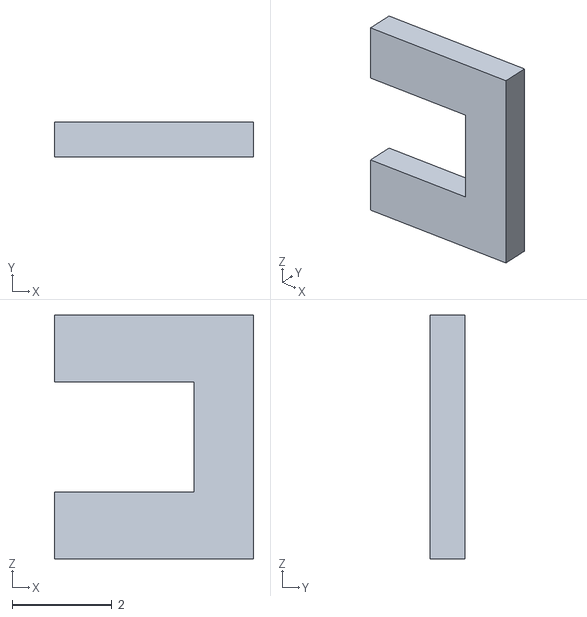
[picture p65: CAD file, 2026-10-19]
mechanical/head_led_3mm/assembly_meshes/03_Right_LED_retainer.stl
4.00 x 0.7 x 4.90
