Dhaval437/Baymax/mechanical/head_led_3mm/Baymax_LED_head_3mm_ONE_PLATE.3mf

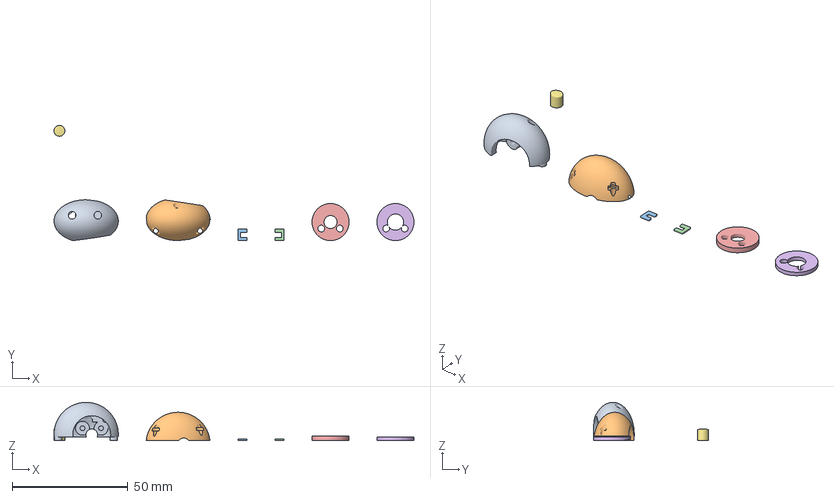
[picture p66: CAD file, 2026-10-19]
mechanical/head_led_3mm/Baymax_LED_head_3mm_ONE_PLATE.3mf
155.3 x 49.7 x 16.5 mm
01_LED_head_front
02_LED_head_rear
03_Left_LED_retainer
03_Right_LED_retainer
05_Original_head_carrier
06_Original_horn_clamp
07_Original_roof_plug
