Dhaval437/Baymax/mechanical/head_led_3mm/STL/01_LED_head_front.stl

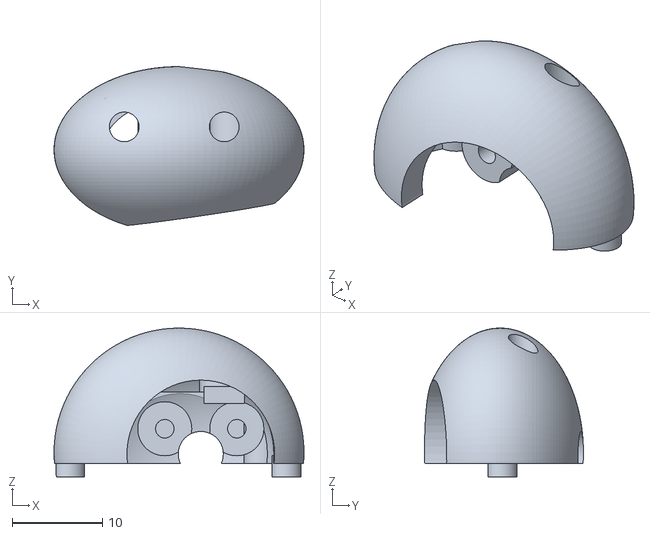
[picture p67: CAD file, 2026-10-19]
mechanical/head_led_3mm/STL/01_LED_head_front.stl
27.8 x 17.6 x 16.5
