Dhaval437/Baymax/mechanical/production_180/01_FIT_TESTS_P1S.3mf

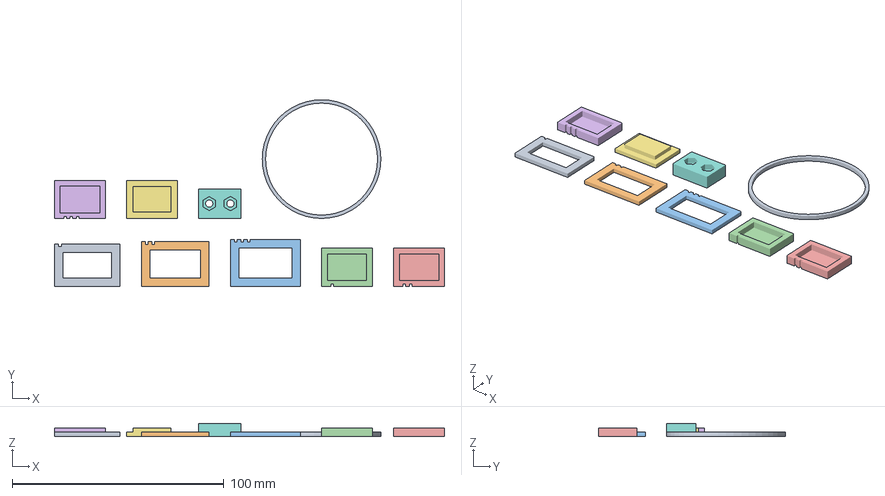
[picture p68: CAD file, 2026-10-17]
mechanical/production_180/01_FIT_TESTS_P1S.3mf
184.0 x 88.0 x 6.00 mm
servo-fit-1
servo-fit-2
servo-fit-3
fit_lip_1_socket
fit_lip_2_socket
fit_lip_3_socket
fit_lip_male
fit_M3_nut_and_screw
fit_speaker_D52_clearance
