Dhaval437/Baymax/mechanical/production_180/articulated_v3/BAMBU_REVIEW/NATIVE_P1S_PLA_TEMPLATE.3mf

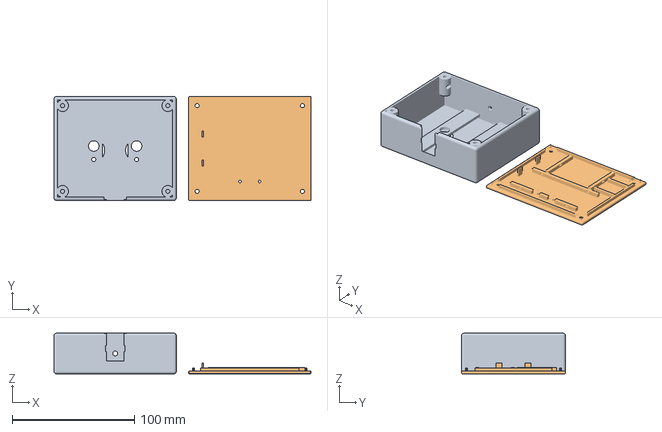
[picture p69: CAD file, 2026-10-17]
mechanical/production_180/articulated_v3/BAMBU_REVIEW/NATIVE_P1S_PLA_TEMPLATE.3mf
210.0 x 85.0 x 33.3 mm
01_base_box_DRAFT
02_base_bottom_DRAFT
