Dhaval437/Baymax/mechanical/production_180/articulated_v3/review_stl/09_button_bracket_DRAFT.stl

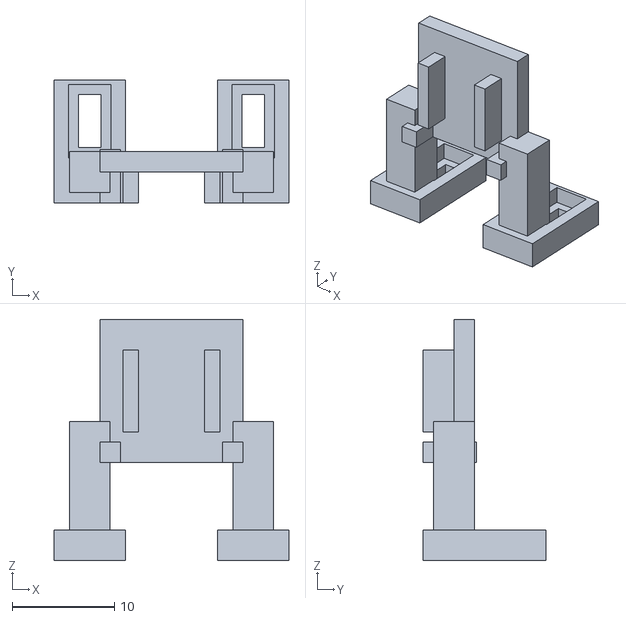
[picture p70: CAD file, 2026-10-17]
mechanical/production_180/articulated_v3/review_stl/09_button_bracket_DRAFT.stl
23.0 x 12.0 x 23.6
