Dhaval437/Baymax/mechanical/production_180/draft_stl/06_Left_arm_and_hand_front_DRAFT.stl

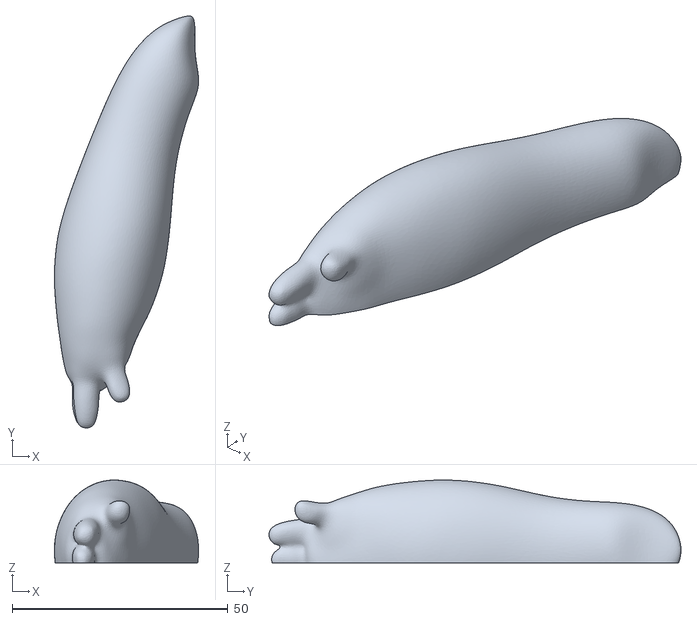
[picture p71: CAD file, 2026-10-17]
mechanical/production_180/draft_stl/06_Left_arm_and_hand_front_DRAFT.stl
33.4 x 95.5 x 19.2
