Dhaval437/Baymax/mechanical/production_180/HOLD_NOT_FOR_PRINT/04_FEET_DEVELOPMENT.3mf

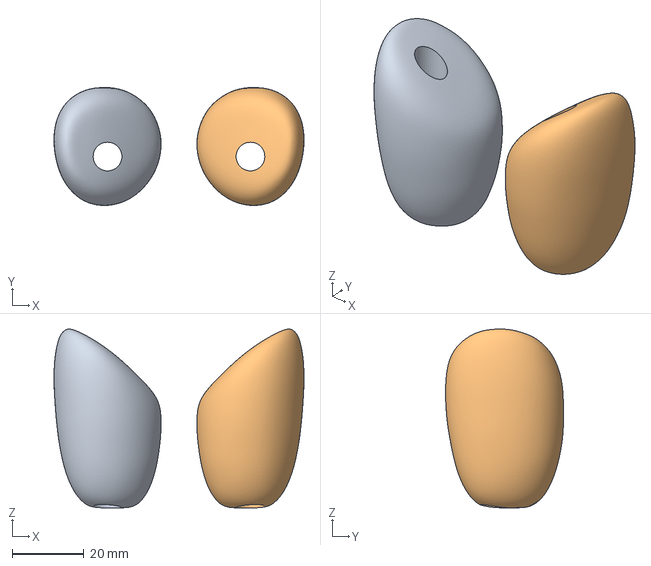
[picture p72: CAD file, 2026-10-17]
mechanical/production_180/HOLD_NOT_FOR_PRINT/04_FEET_DEVELOPMENT.3mf
69.7 x 32.9 x 49.9 mm
03_Leg_left_DRAFT
03_Leg_right_DRAFT
