Dhaval437/Baymax/mechanical/production_180/panel_fasteners_v2/04_torso_rear_DRAFT.stl

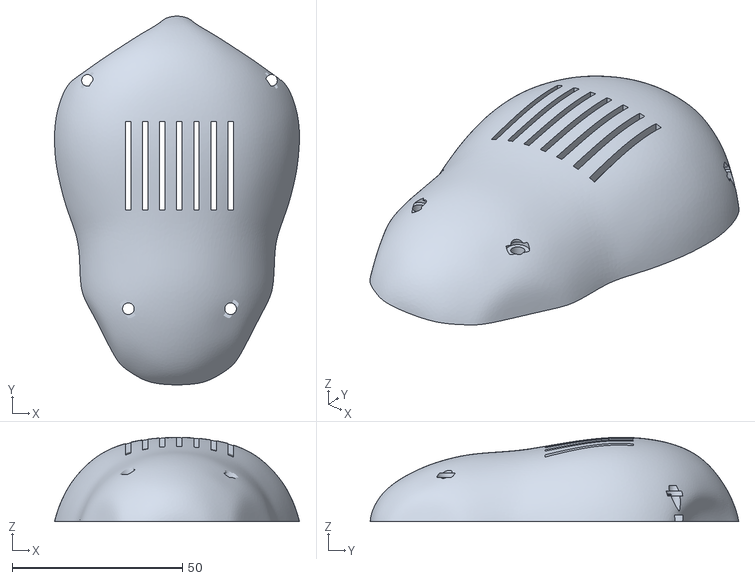
[picture p73: CAD file, 2026-10-17]
mechanical/production_180/panel_fasteners_v2/04_torso_rear_DRAFT.stl
71.9 x 108.2 x 24.7
