Dhaval437/Baymax/mechanical/production_180/PRINT_PACKAGE_180MM/Baymax_180mm_P1S_TWO_PLATES.3mf

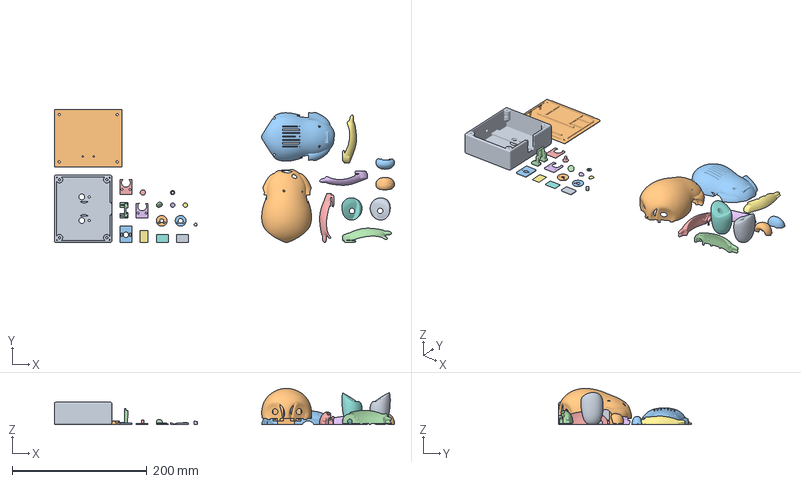
[picture p74: CAD file, 2026-10-17]
mechanical/production_180/PRINT_PACKAGE_180MM/Baymax_180mm_P1S_TWO_PLATES.3mf
504.2 x 197.0 x 53.6 mm
01_base_box
02_base_bottom
08_power_entry_insert
09_button_bracket
07_Left_horn_clamp
07_Right_horn_clamp
15_servo_shim_1
15_servo_shim_2
15_servo_shim_3
07_head_carrier
07_head_horn_clamp
12_Chest_badge
10_talk_button
13_Left_arm_access_plug
13_Right_arm_access_plug
11_button_retainer
14_head_access_plug
04_torso_front
04_torso_rear
06_Right_arm_and_hand_front
06_Left_arm_and_hand_front
06_Left_arm_and_hand_rear
06_Right_arm_and_hand_rear
03_Leg_left
03_Leg_right
05_head_front
05_head_rear
