Dhaval437/Baymax/mechanical/production_180/servo_bracket_development/SG90_tab_clamp_left.stl

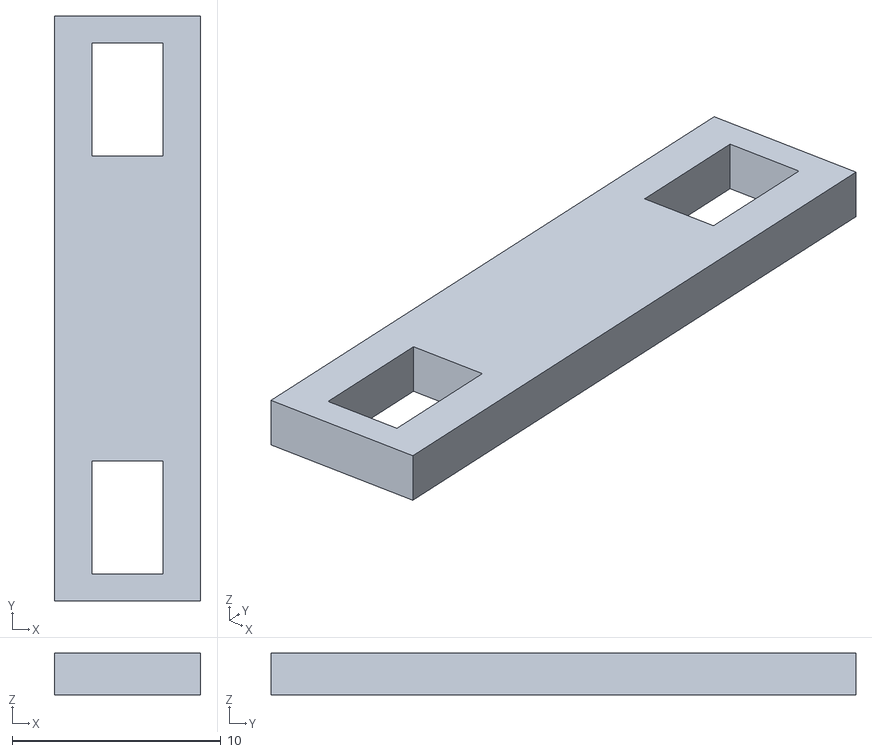
[picture p75: CAD file, 2026-10-17]
mechanical/production_180/servo_bracket_development/SG90_tab_clamp_left.stl
7.00 x 28.0 x 2.00
