Dhaval437/Baymax/mechanical/reference_model/source_Baymax1_color.3mf

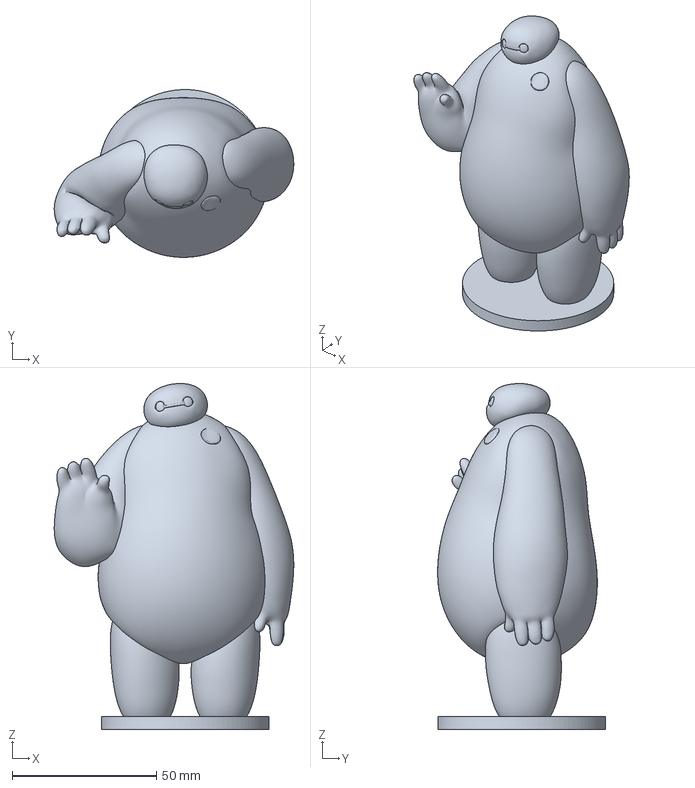
[picture p76: CAD file, 2026-10-17]
mechanical/reference_model/source_Baymax1_color.3mf
83.1 x 58.2 x 120.0 mm
