Dhaval437/Baymax/mechanical/servo_fit_gauge/servo-fit-1.stl

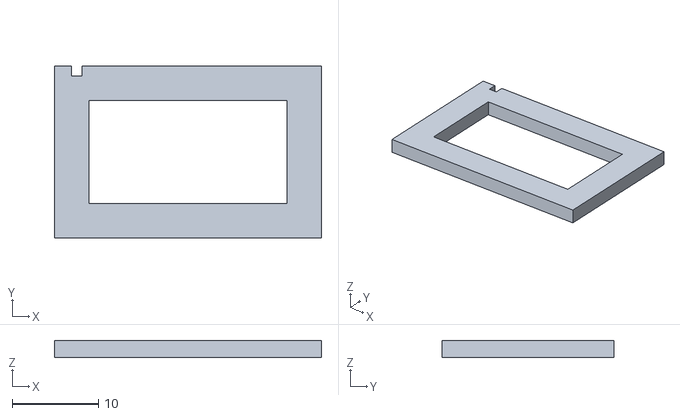
[picture p77: CAD file, 2026-10-17]
mechanical/servo_fit_gauge/servo-fit-1.stl
31.0 x 20.0 x 2.00
