Dhaval437/Baymax/assembly/arm-cad/06_Right_arm_and_hand_rear_DRAFT.stl

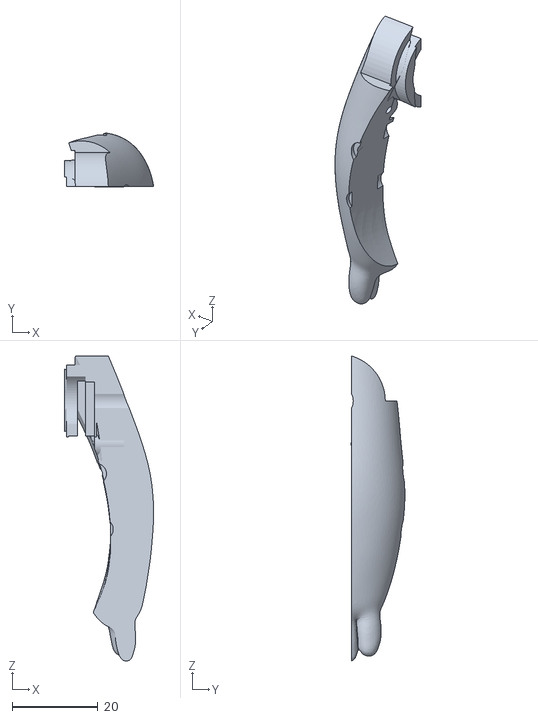
[picture p78: CAD file, 2026-10-17]
assembly/arm-cad/06_Right_arm_and_hand_rear_DRAFT.stl
20.9 x 12.6 x 71.3
