Dhaval437/Baymax/assembly/head-cad/05_head_rear_DRAFT.stl

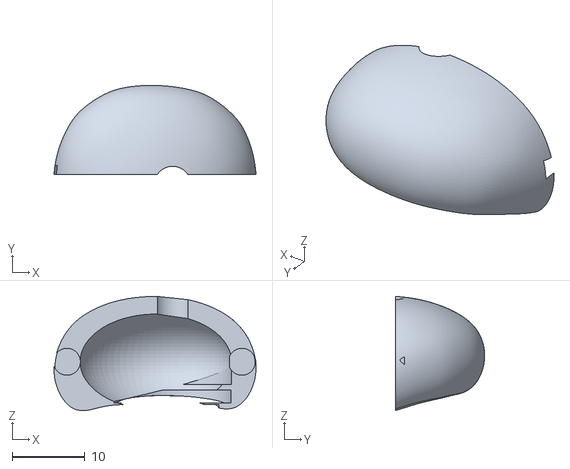
[picture p79: CAD file, 2026-10-17]
assembly/head-cad/05_head_rear_DRAFT.stl
27.7 x 12.3 x 15.7
