Dhaval437/Baymax/mechanical/arm_extension_10mm/Baymax_arm_extension_10mm_pair.stl

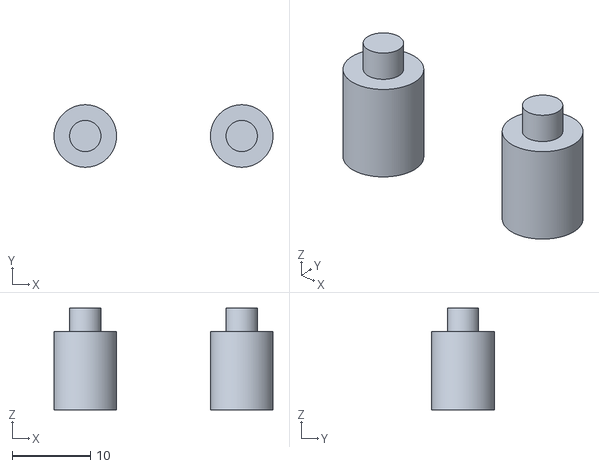
[picture p80: CAD file, 2026-10-17]
mechanical/arm_extension_10mm/Baymax_arm_extension_10mm_pair.stl
28.0 x 8.00 x 13.0
