Dhaval437/Baymax/mechanical/arm_extension_10mm_5mm_fit/Baymax_arm_extension_10mm_5mm_pair.stl

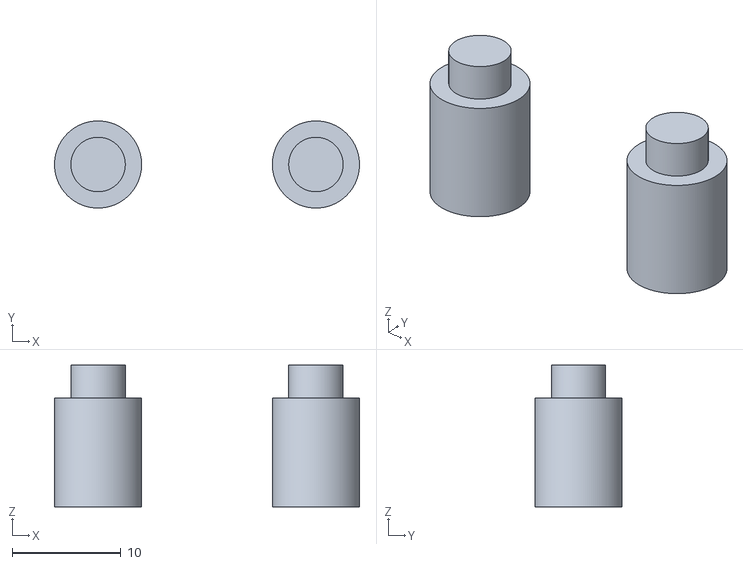
[picture p81: CAD file, 2026-10-19]
mechanical/arm_extension_10mm_5mm_fit/Baymax_arm_extension_10mm_5mm_pair.stl
28.0 x 8.00 x 13.0
