Dhaval437/Baymax/mechanical/arm_extension_5mm_5mm_fit/Baymax_arm_extension_5mm_5mm_single.stl

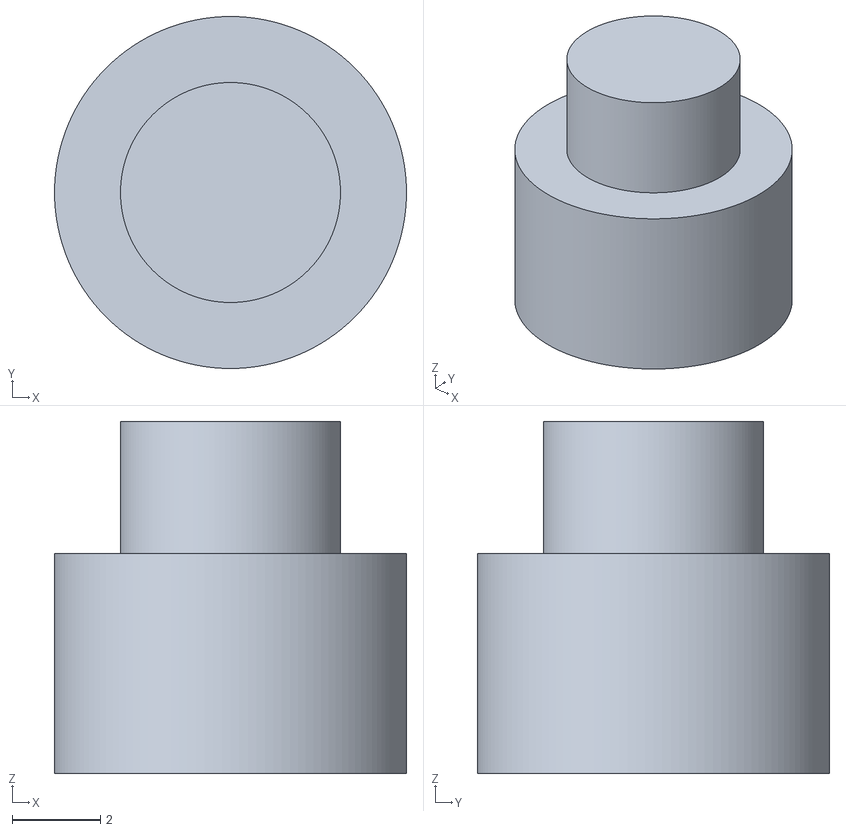
[picture p82: CAD file, 2026-10-20]
mechanical/arm_extension_5mm_5mm_fit/Baymax_arm_extension_5mm_5mm_single.stl
8.00 x 8.00 x 8.00
