Dhaval437/Baymax/mechanical/blender/draft_stl/04_right_arm_rear_DRAFT.stl

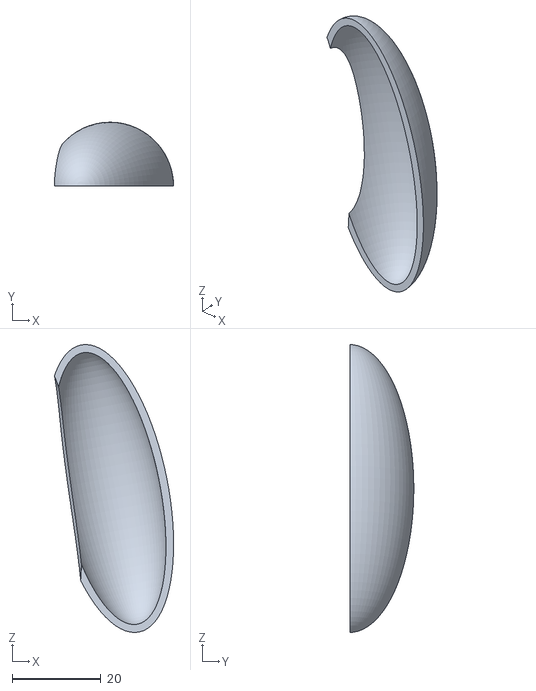
[picture p83: CAD file, 2026-10-17]
mechanical/blender/draft_stl/04_right_arm_rear_DRAFT.stl
26.9 x 14.4 x 64.9
