Dhaval437/Baymax/mechanical/head_led_3mm/assembly_meshes/02_LED_head_rear.stl

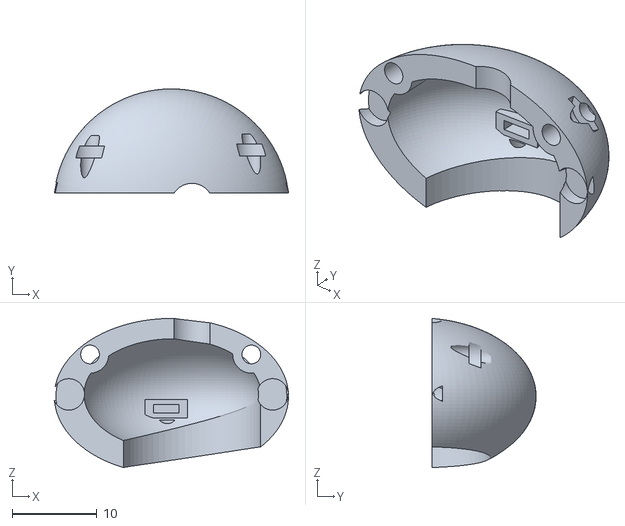
[picture p84: CAD file, 2026-10-19]
mechanical/head_led_3mm/assembly_meshes/02_LED_head_rear.stl
27.6 x 12.3 x 17.6
