Dhaval437/Baymax/mechanical/head_led_3mm/STL/05_Original_head_carrier.stl

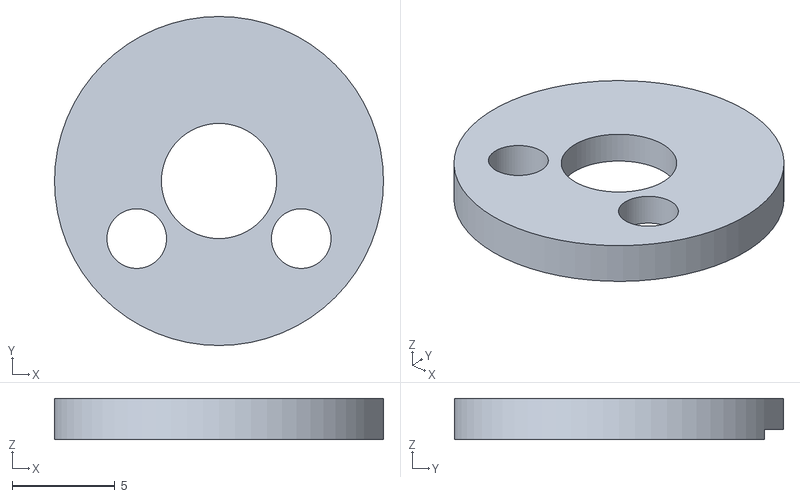
[picture p85: CAD file, 2026-10-19]
mechanical/head_led_3mm/STL/05_Original_head_carrier.stl
16.0 x 16.0 x 2.00
