Dhaval437/Baymax/mechanical/production_180/articulated_v3/BAMBU_REVIEW/TWO_PLATE_NATIVE_REFERENCE.3mf

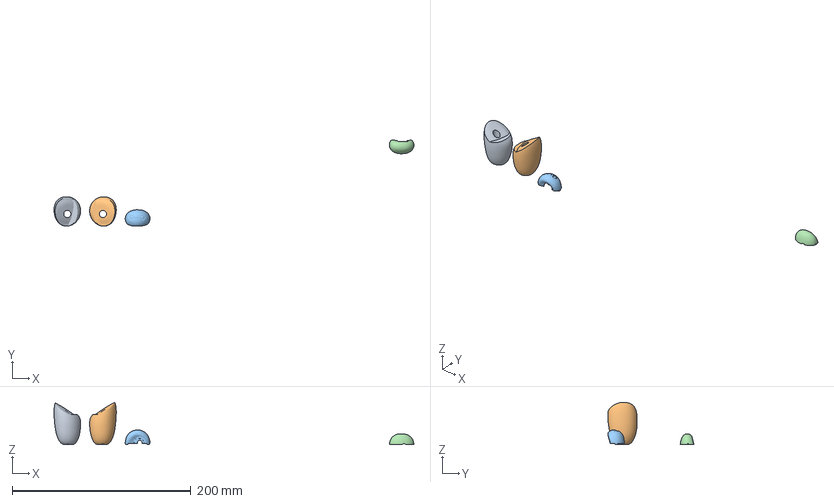
[picture p86: CAD file, 2026-10-17]
mechanical/production_180/articulated_v3/BAMBU_REVIEW/TWO_PLATE_NATIVE_REFERENCE.3mf
403.1 x 96.7 x 47.5 mm
03_Leg_left_DRAFT
03_Leg_right_DRAFT
05_head_front_DRAFT
05_head_rear_DRAFT
