Dhaval437/Baymax/mechanical/production_180/articulated_v3/review_stl/12_Chest_badge_DRAFT.stl

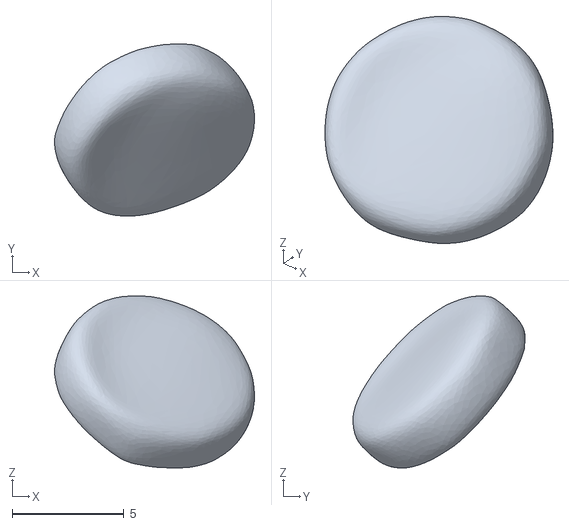
[picture p87: CAD file, 2026-10-17]
mechanical/production_180/articulated_v3/review_stl/12_Chest_badge_DRAFT.stl
8.96 x 7.71 x 7.70
