Dhaval437/Baymax/mechanical/production_180/draft_stl/03_Leg_left_DRAFT.stl

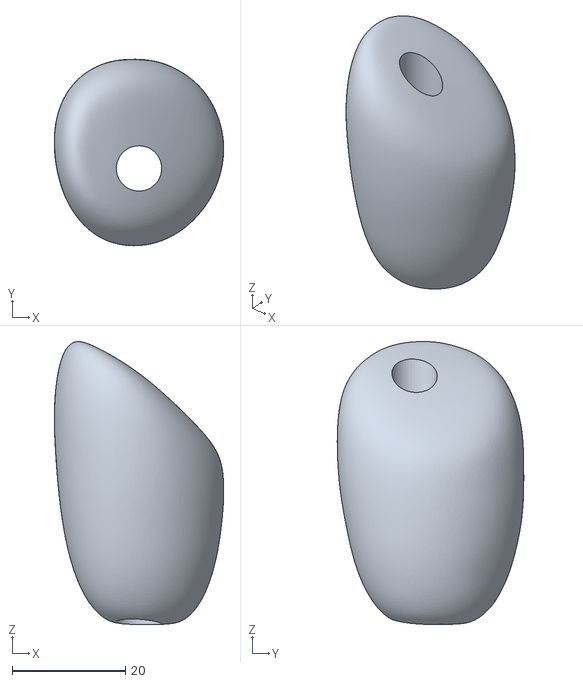
[picture p88: CAD file, 2026-10-17]
mechanical/production_180/draft_stl/03_Leg_left_DRAFT.stl
29.9 x 32.9 x 49.9
