Dhaval437/Baymax/mechanical/production_180/HOLD_NOT_FOR_PRINT/03_BASE_COVER_DEVELOPMENT.3mf

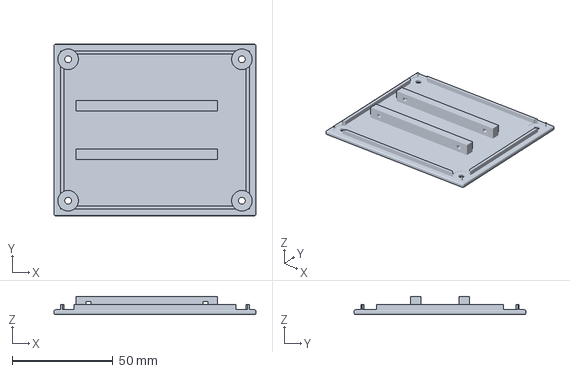
[picture p90: CAD file, 2026-10-17]
mechanical/production_180/HOLD_NOT_FOR_PRINT/03_BASE_COVER_DEVELOPMENT.3mf
100.0 x 85.0 x 9.00 mm
