Dhaval437/Baymax/mechanical/production_180/panel_fasteners_v2/01_base_box_DRAFT.stl

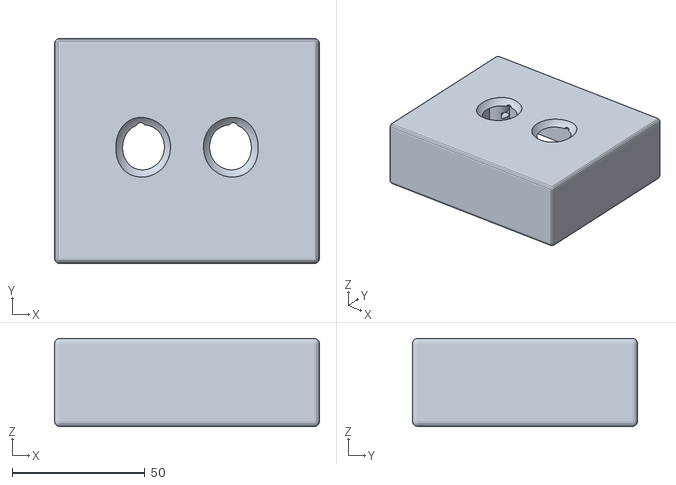
[picture p91: CAD file, 2026-10-17]
mechanical/production_180/panel_fasteners_v2/01_base_box_DRAFT.stl
100.0 x 85.0 x 33.3
