Dhaval437/Baymax/mechanical/reference_model/source_baymax.stl

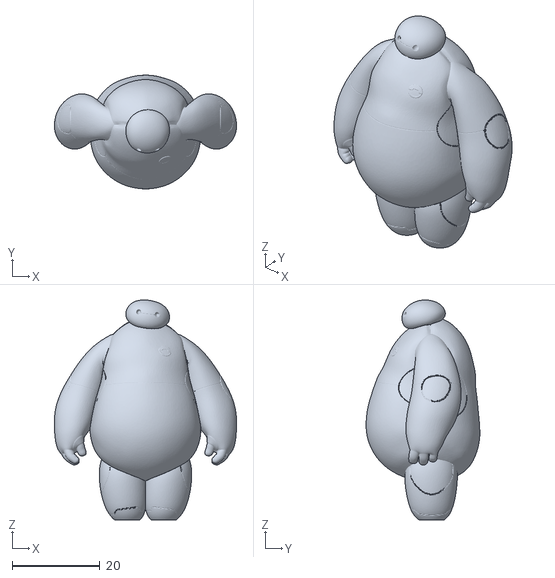
[picture p92: CAD file, 2026-10-17]
mechanical/reference_model/source_baymax.stl
41.4 x 25.8 x 50.0
