Dhaval437/Baymax/mechanical/servo_fit_gauge/servo-fit-2.stl

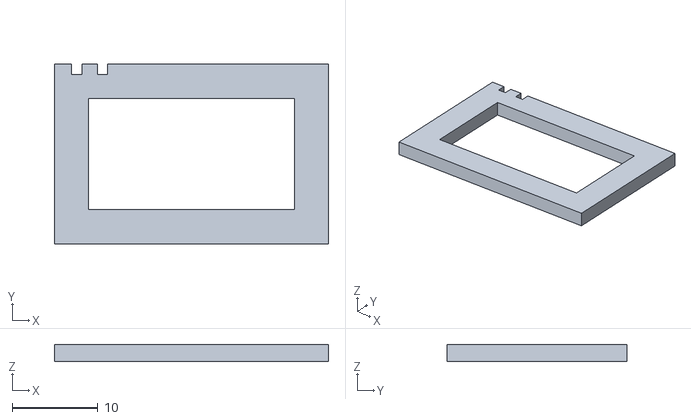
[picture p93: CAD file, 2026-10-17]
mechanical/servo_fit_gauge/servo-fit-2.stl
32.0 x 21.0 x 2.00
