Dhaval437/Baymax/assembly/arm-cad/13_Right_arm_access_plug_DRAFT.stl

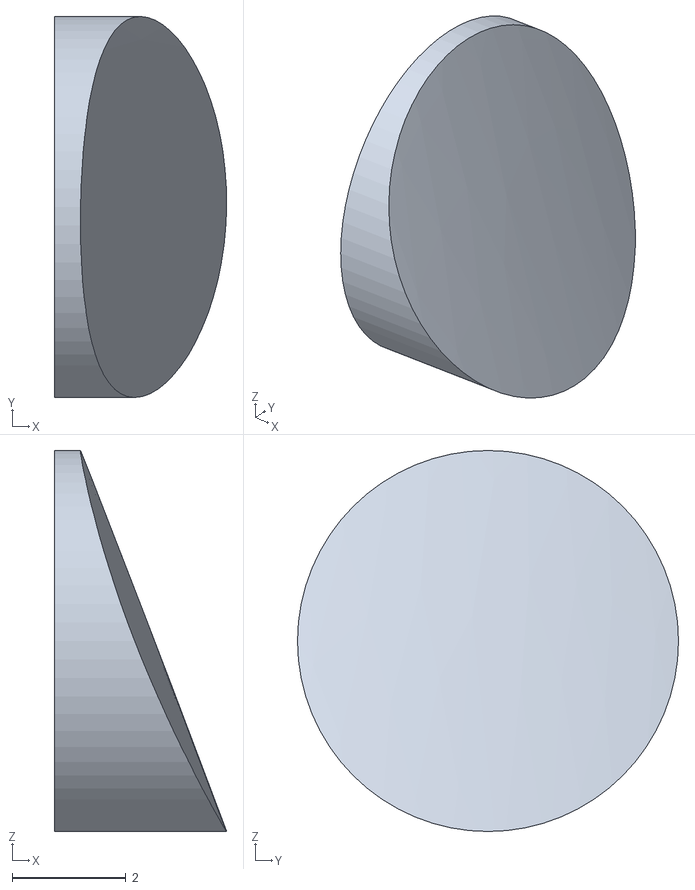
[picture p94: CAD file, 2026-10-17]
assembly/arm-cad/13_Right_arm_access_plug_DRAFT.stl
3.03 x 6.70 x 6.70
