Dhaval437/Baymax/assembly/head-cad/04_torso_front_DRAFT.stl

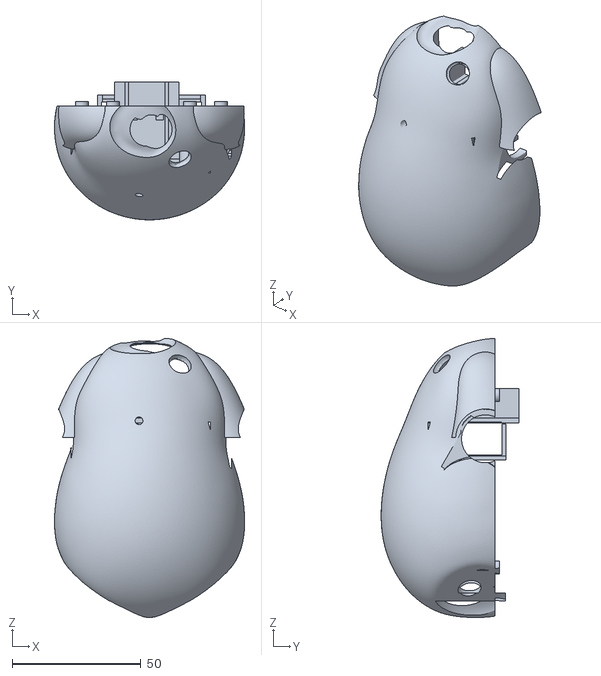
[picture p95: CAD file, 2026-10-17]
assembly/head-cad/04_torso_front_DRAFT.stl
73.9 x 53.6 x 108.4
