Dhaval437/Baymax/mechanical/blender/draft_stl/01_torso_rear_DRAFT.stl

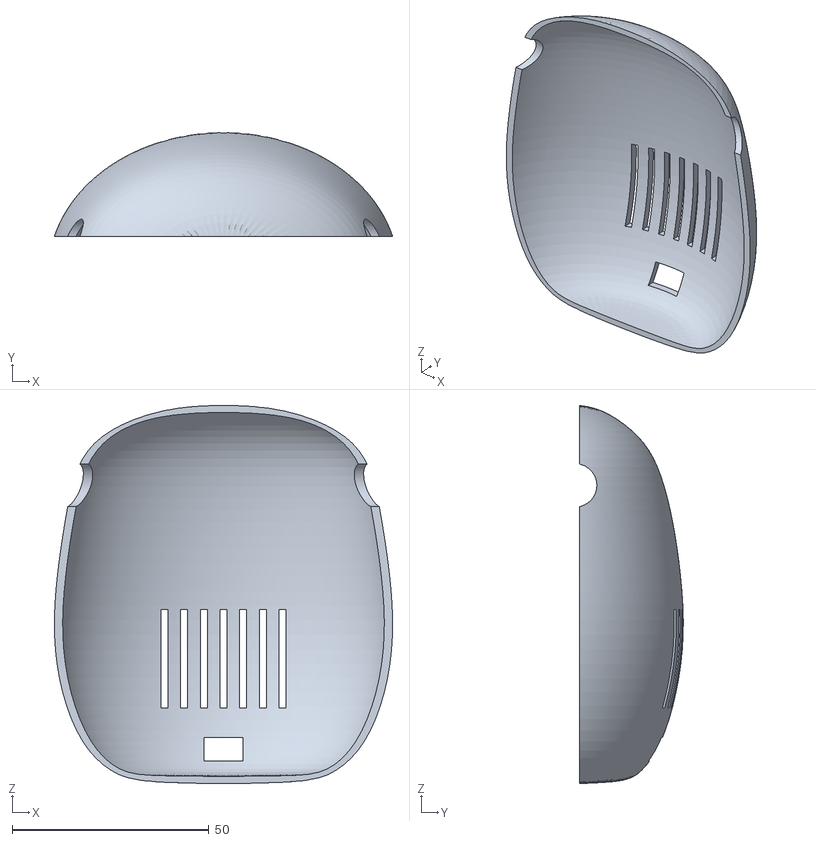
[picture p96: CAD file, 2026-10-17]
mechanical/blender/draft_stl/01_torso_rear_DRAFT.stl
85.9 x 26.3 x 96.0
