Dhaval437/Baymax/mechanical/head_led_3mm/STL/07_Original_roof_plug.stl

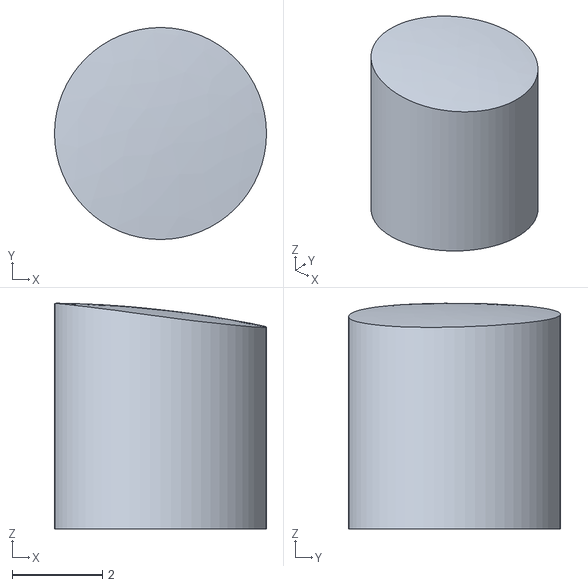
[picture p97: CAD file, 2026-10-19]
mechanical/head_led_3mm/STL/07_Original_roof_plug.stl
4.70 x 4.70 x 5.00
