Dhaval437/Baymax/mechanical/production_180/draft_stl/04_torso_front_DRAFT.stl

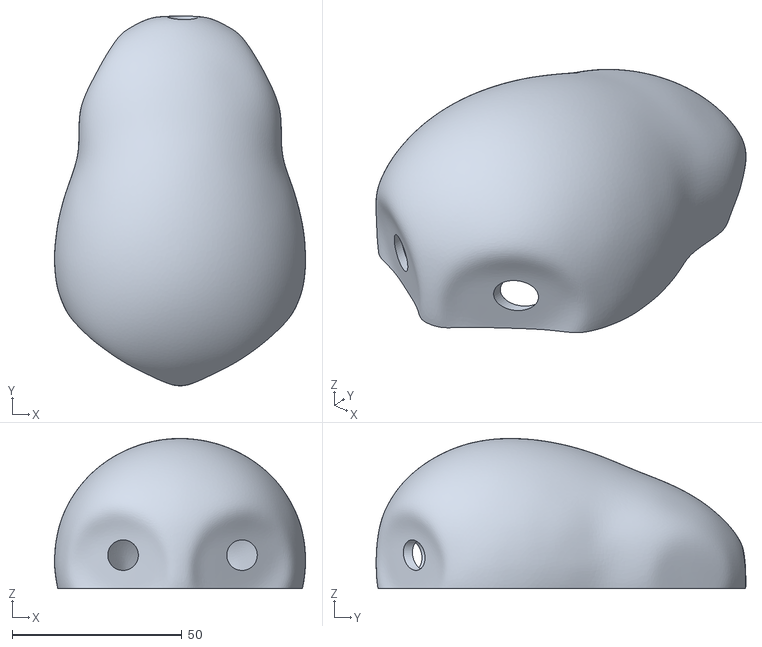
[picture p99: CAD file, 2026-10-17]
mechanical/production_180/draft_stl/04_torso_front_DRAFT.stl
73.9 x 108.9 x 44.2
