Dhaval437/Baymax/mechanical/production_180/fit_tests/fit_speaker_D52_clearance.stl

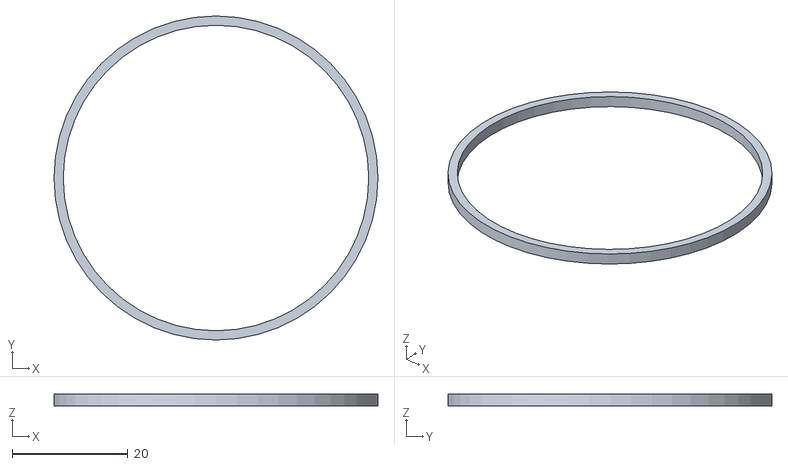
[picture p100: CAD file, 2026-10-17]
mechanical/production_180/fit_tests/fit_speaker_D52_clearance.stl
56.0 x 56.0 x 2.00
