Dhaval437/Baymax/mechanical/production_180/HOLD_NOT_FOR_PRINT/07_ARMS_DEVELOPMENT.3mf

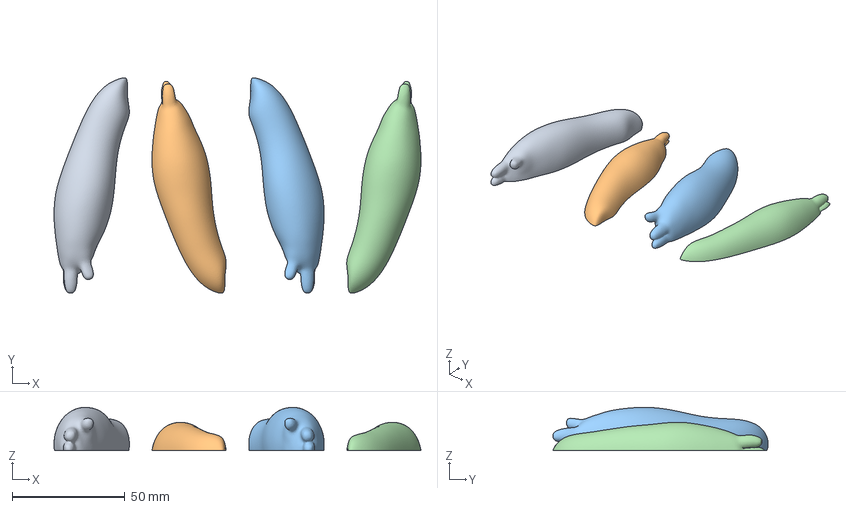
[picture p101: CAD file, 2026-10-17]
mechanical/production_180/HOLD_NOT_FOR_PRINT/07_ARMS_DEVELOPMENT.3mf
162.7 x 95.5 x 19.2 mm
06_Left_arm_and_hand_front_DRAFT
06_Left_arm_and_hand_rear_DRAFT
06_Right_arm_and_hand_front_DRAFT
06_Right_arm_and_hand_rear_DRAFT
