Dhaval437/Baymax/mechanical/production_180/panel_fasteners_v2/05_head_rear_DRAFT.stl

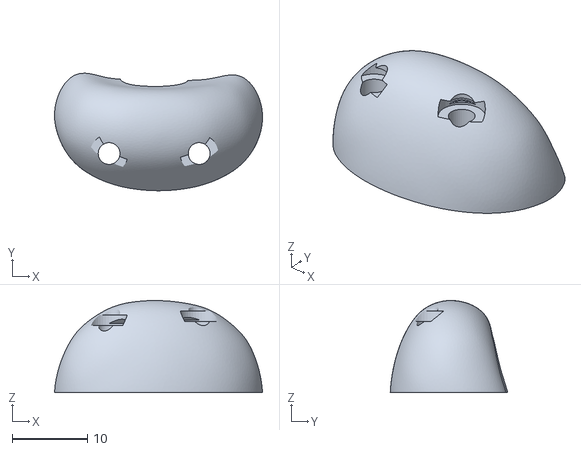
[picture p102: CAD file, 2026-10-17]
mechanical/production_180/panel_fasteners_v2/05_head_rear_DRAFT.stl
27.7 x 15.7 x 12.3
