Dhaval437/Baymax/mechanical/production_180/servo_bracket_development/SG90_clamp_frame.stl

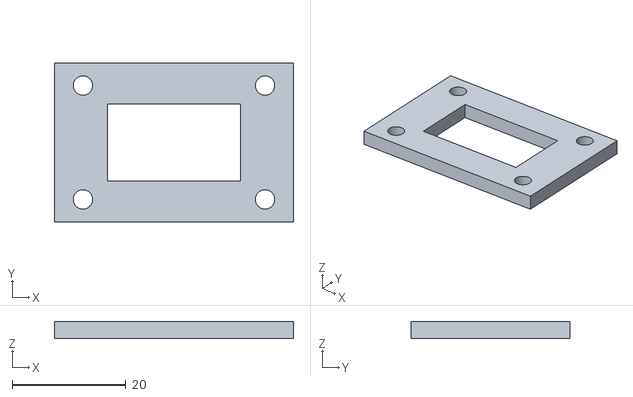
[picture p103: CAD file, 2026-10-17]
mechanical/production_180/servo_bracket_development/SG90_clamp_frame.stl
42.0 x 28.0 x 3.00
