Dhaval437/Baymax/mechanical/servo_fit_gauge/servo-fit-3.stl

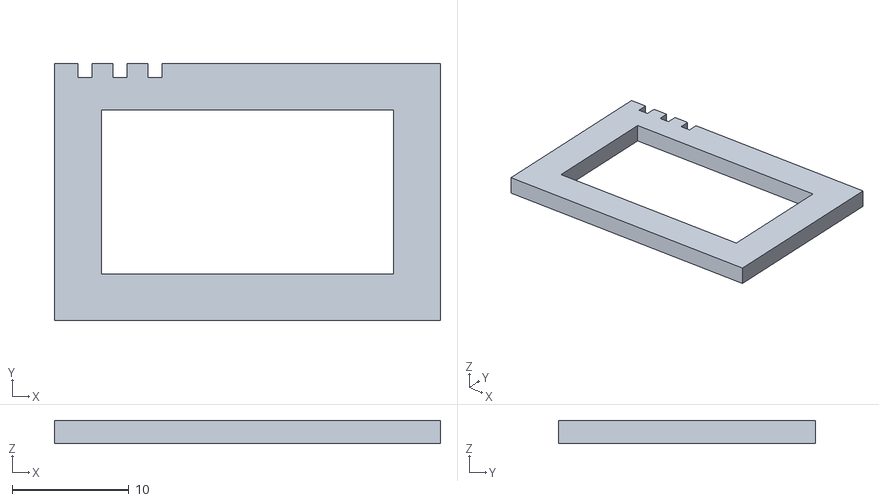
[picture p104: CAD file, 2026-10-17]
mechanical/servo_fit_gauge/servo-fit-3.stl
33.0 x 22.0 x 2.00
