Dhaval437/Baymax/assembly/arm-cad/06_Right_arm_and_hand_front_DRAFT.stl

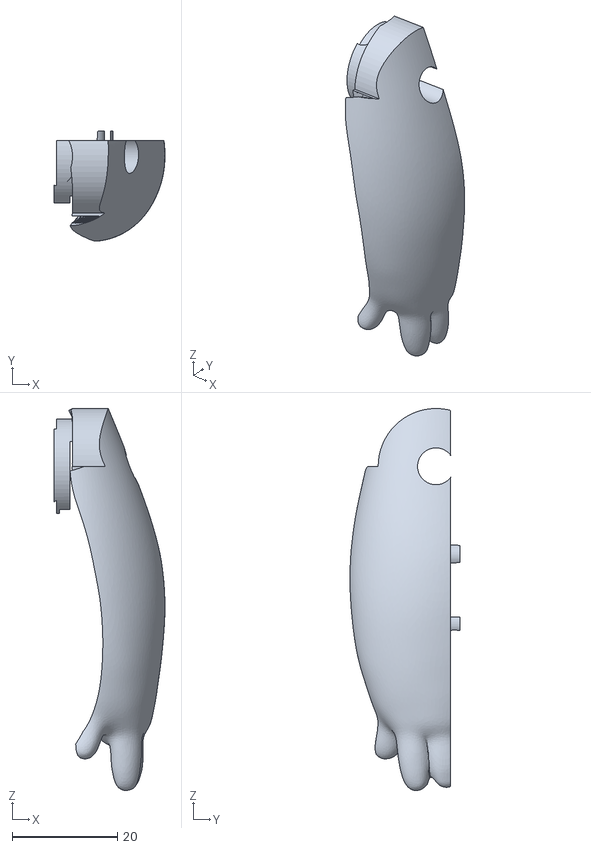
[picture p105: CAD file, 2026-10-17]
assembly/arm-cad/06_Right_arm_and_hand_front_DRAFT.stl
21.1 x 21.0 x 72.7
