Dhaval437/Baymax/mechanical/blender/draft_stl/01_torso_front_DRAFT.stl

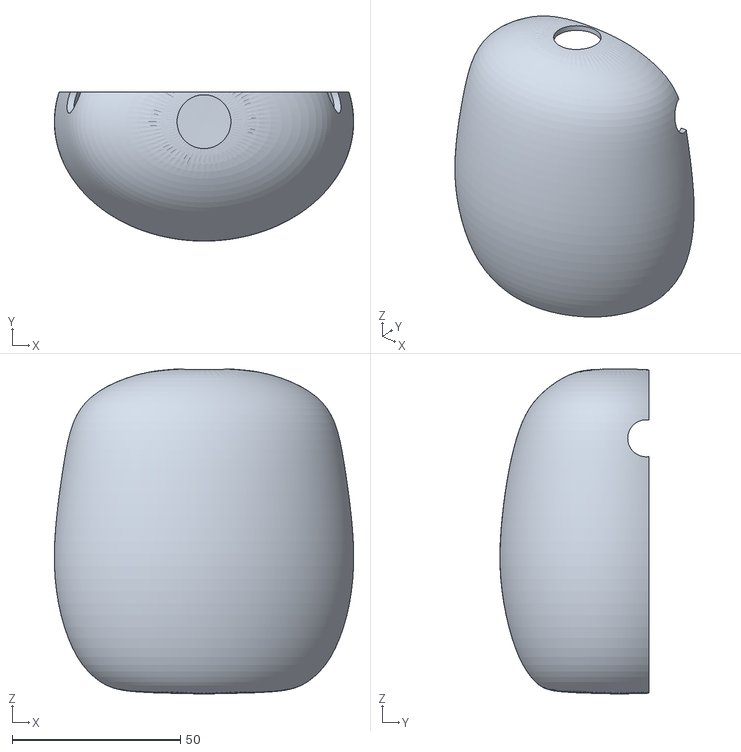
[picture p106: CAD file, 2026-10-17]
mechanical/blender/draft_stl/01_torso_front_DRAFT.stl
88.9 x 44.3 x 96.6
