Dhaval437/Baymax/mechanical/production_180/articulated_v3/BAMBU_REVIEW/04_HEAD_FEET_REVIEW.3mf

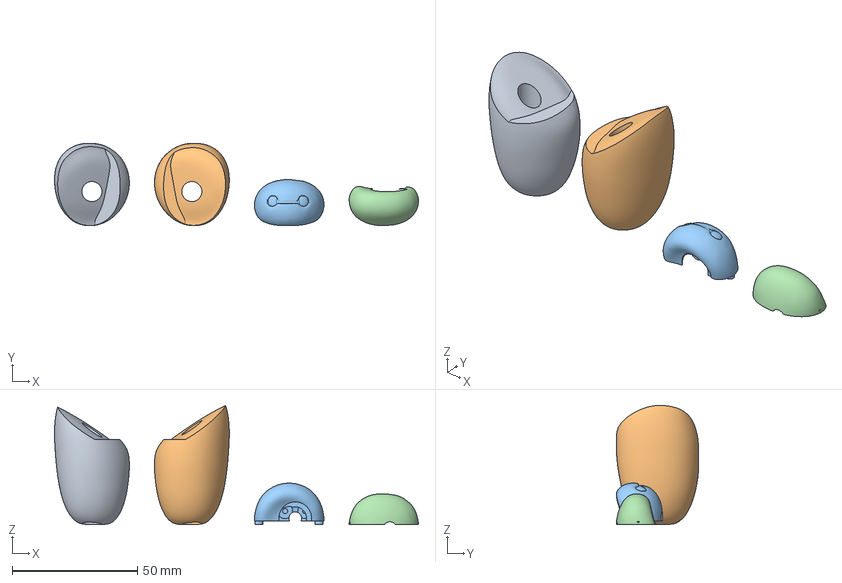
[picture p107: CAD file, 2026-10-17]
mechanical/production_180/articulated_v3/BAMBU_REVIEW/04_HEAD_FEET_REVIEW.3mf
145.2 x 32.9 x 47.5 mm
03_Leg_left_DRAFT
03_Leg_right_DRAFT
05_head_front_DRAFT
05_head_rear_DRAFT
