Dhaval437/Baymax/mechanical/production_180/articulated_v3/review_stl/04_torso_rear_DRAFT.stl

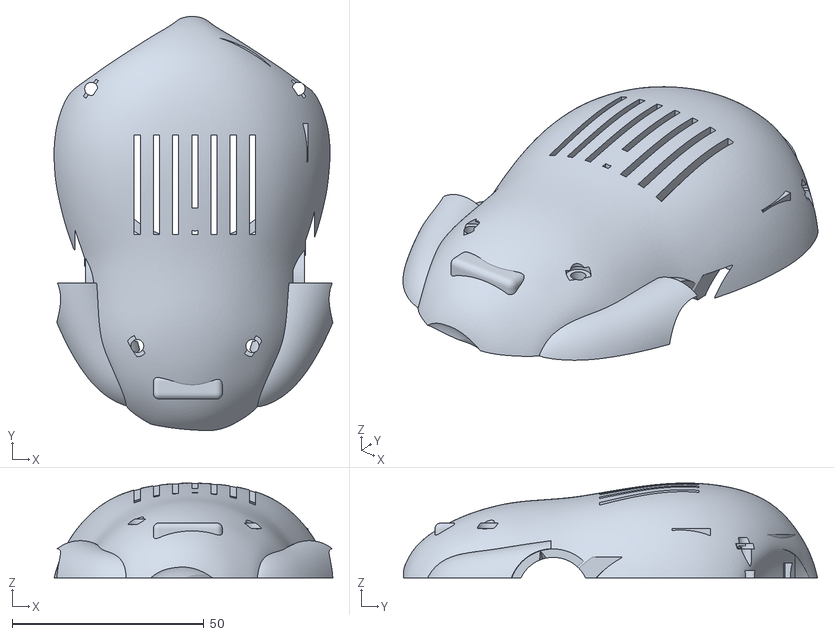
[picture p108: CAD file, 2026-10-17]
mechanical/production_180/articulated_v3/review_stl/04_torso_rear_DRAFT.stl
72.6 x 107.8 x 24.7
