Dhaval437/Baymax/mechanical/production_180/draft_stl/06_Right_arm_and_hand_rear_DRAFT.stl

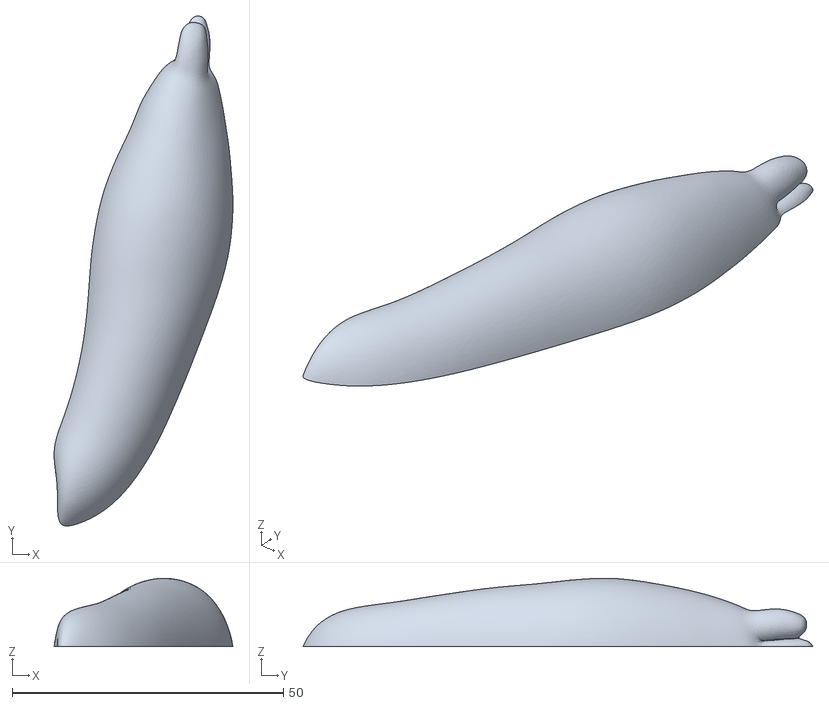
[picture p109: CAD file, 2026-10-17]
mechanical/production_180/draft_stl/06_Right_arm_and_hand_rear_DRAFT.stl
32.9 x 93.9 x 12.6
