Dhaval437/Baymax/mechanical/production_180/HOLD_NOT_FOR_PRINT/05_TORSO_DEVELOPMENT.3mf

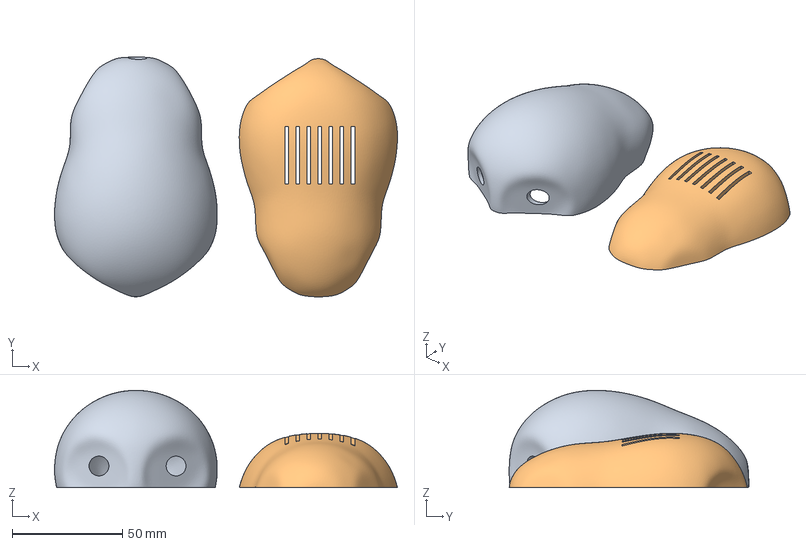
[picture p110: CAD file, 2026-10-17]
mechanical/production_180/HOLD_NOT_FOR_PRINT/05_TORSO_DEVELOPMENT.3mf
155.8 x 108.9 x 44.2 mm
04_torso_front_DRAFT
04_torso_rear_DRAFT
