Dhaval437/Baymax/mechanical/production_180/panel_fasteners_v2/06_Left_arm_and_hand_front_DRAFT.stl

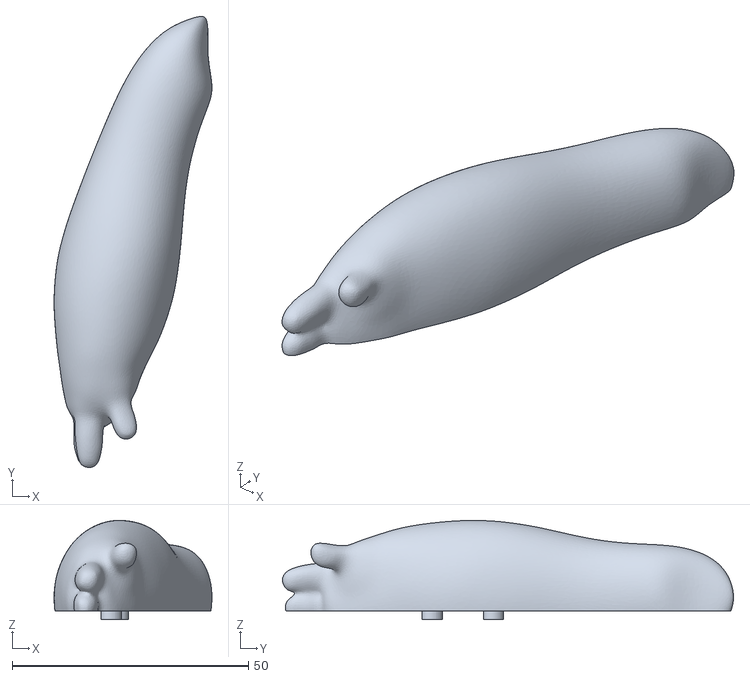
[picture p111: CAD file, 2026-10-17]
mechanical/production_180/panel_fasteners_v2/06_Left_arm_and_hand_front_DRAFT.stl
33.4 x 95.5 x 21.0
