Dhaval437/Baymax/assembly/arm-cad/07_Left_horn_clamp_DRAFT.stl

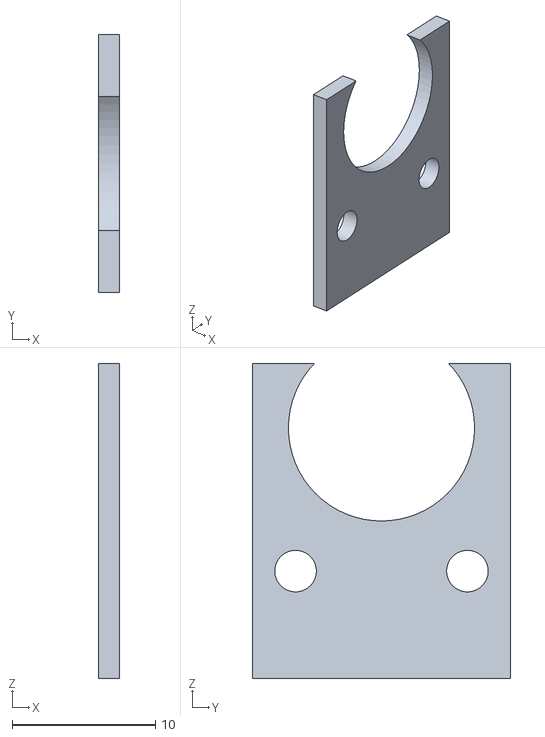
[picture p112: CAD file, 2026-10-17]
assembly/arm-cad/07_Left_horn_clamp_DRAFT.stl
1.50 x 18.0 x 22.0
