Dhaval437/Baymax/assembly/head-cad/05_head_front_DRAFT.stl

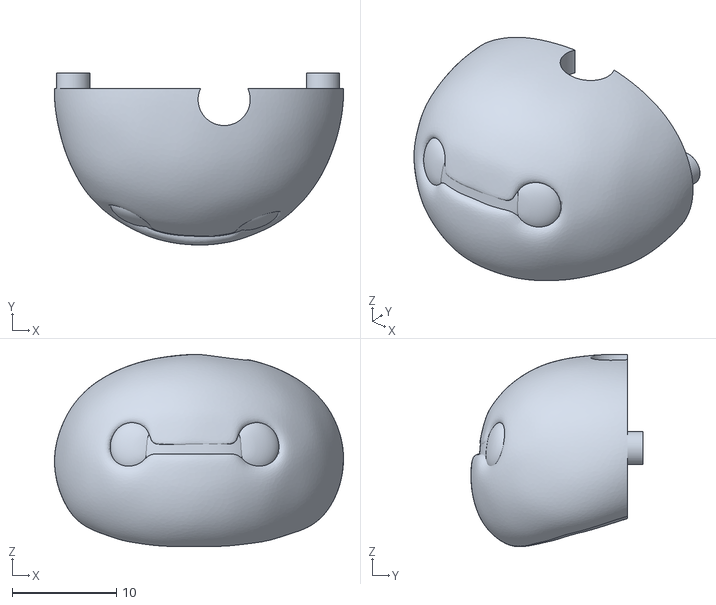
[picture p113: CAD file, 2026-10-17]
assembly/head-cad/05_head_front_DRAFT.stl
27.8 x 16.5 x 18.5
