Dhaval437/Baymax/mechanical/head_led_3mm/assembly_meshes/REFERENCE Right LED lens.stl

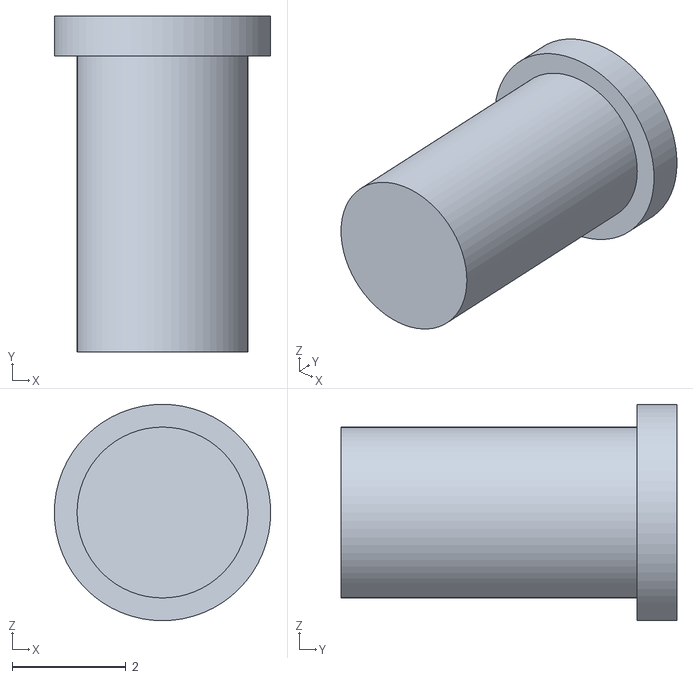
[picture p114: CAD file, 2026-10-19]
mechanical/head_led_3mm/assembly_meshes/REFERENCE Right LED lens.stl
3.80 x 5.90 x 3.80
