Dhaval437/Baymax/mechanical/production_180/articulated_v3/BAMBU_REVIEW/02_TORSO_REVIEW.3mf

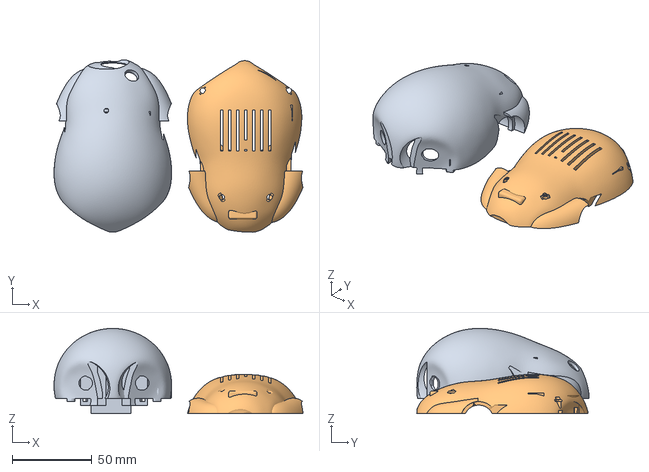
[picture p115: CAD file, 2026-10-17]
mechanical/production_180/articulated_v3/BAMBU_REVIEW/02_TORSO_REVIEW.3mf
156.5 x 108.4 x 53.6 mm
04_torso_front_DRAFT
04_torso_rear_DRAFT
