Dhaval437/Baymax/mechanical/production_180/articulated_v3/review_stl/03_Leg_right_DRAFT.stl

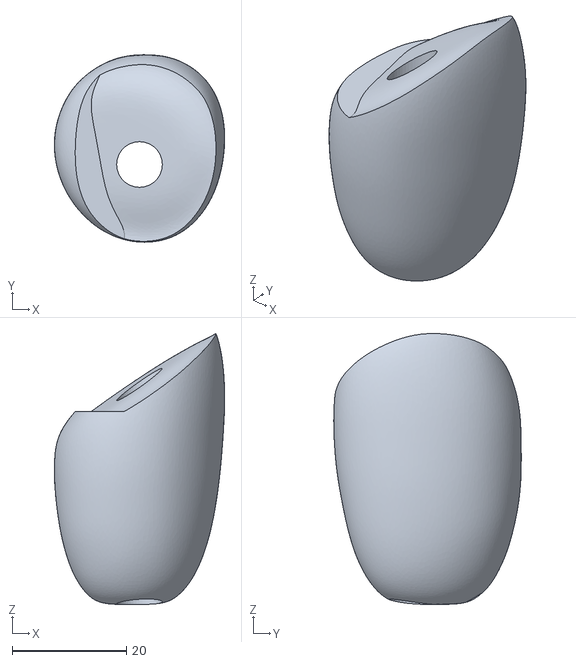
[picture p116: CAD file, 2026-10-17]
mechanical/production_180/articulated_v3/review_stl/03_Leg_right_DRAFT.stl
29.9 x 32.9 x 47.5
