Dhaval437/Baymax/mechanical/production_180/fit_tests/fit_lip_male.stl

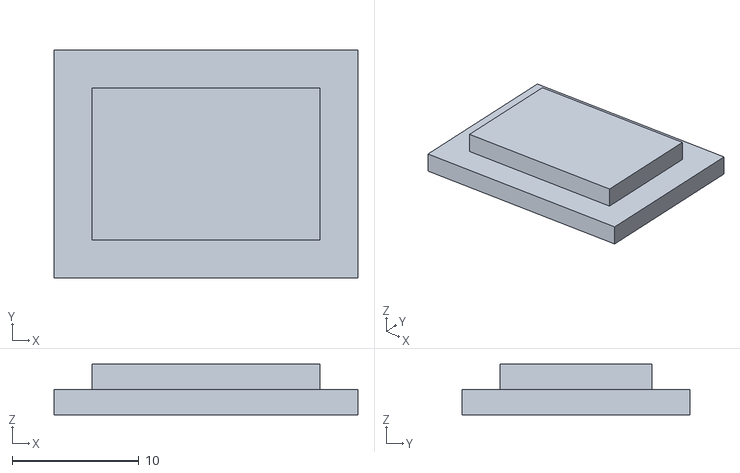
[picture p117: CAD file, 2026-10-17]
mechanical/production_180/fit_tests/fit_lip_male.stl
24.0 x 18.0 x 4.00
