Dhaval437/Baymax/mechanical/production_180/panel_fasteners_v2/06_Right_arm_and_hand_rear_DRAFT.stl

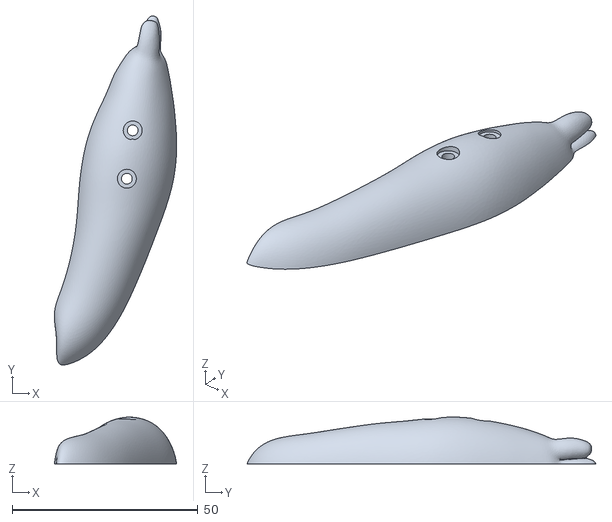
[picture p118: CAD file, 2026-10-17]
mechanical/production_180/panel_fasteners_v2/06_Right_arm_and_hand_rear_DRAFT.stl
32.9 x 93.9 x 12.6
