Dhaval437/Baymax/mechanical/blender/draft_stl/02_head_front_DRAFT.stl

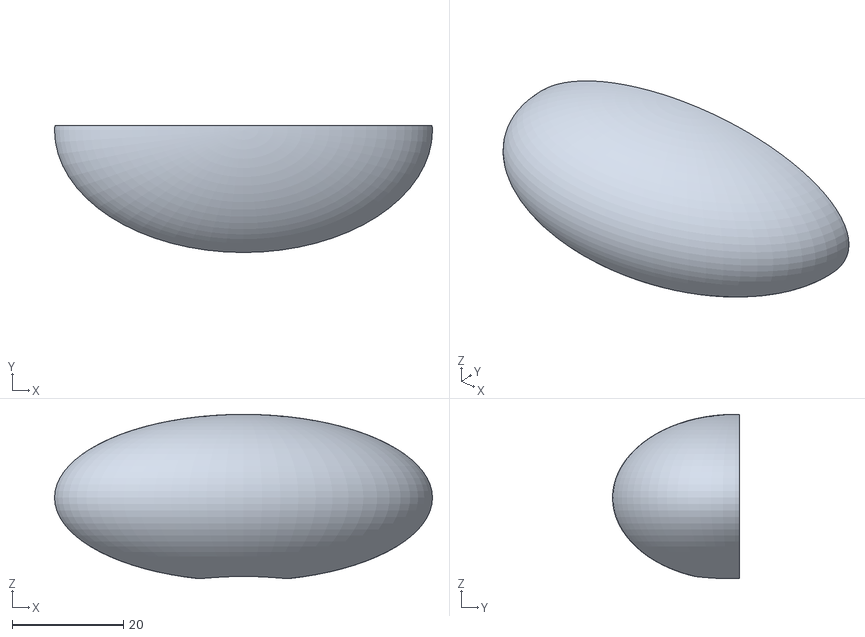
[picture p119: CAD file, 2026-10-17]
mechanical/blender/draft_stl/02_head_front_DRAFT.stl
68.0 x 22.9 x 29.6
