Dhaval437/Baymax/mechanical/production_180/articulated_v3/BAMBU_REVIEW/03_ARMS_REVIEW.3mf

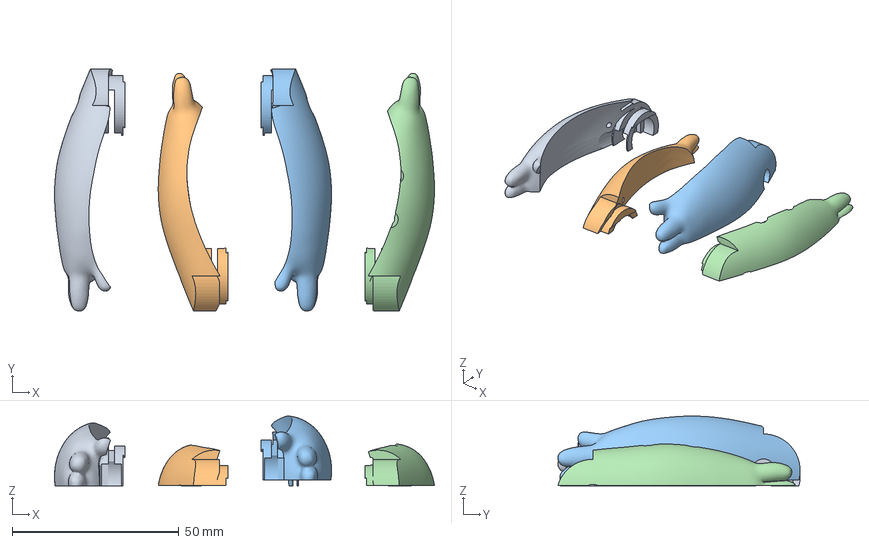
[picture p120: CAD file, 2026-10-17]
mechanical/production_180/articulated_v3/BAMBU_REVIEW/03_ARMS_REVIEW.3mf
114.0 x 72.7 x 21.0 mm
06_Left_arm_and_hand_front_DRAFT
06_Left_arm_and_hand_rear_DRAFT
06_Right_arm_and_hand_front_DRAFT
06_Right_arm_and_hand_rear_DRAFT
