Dhaval437/Baymax/mechanical/production_180/HOLD_NOT_FOR_PRINT/06_HEAD_DEVELOPMENT.3mf

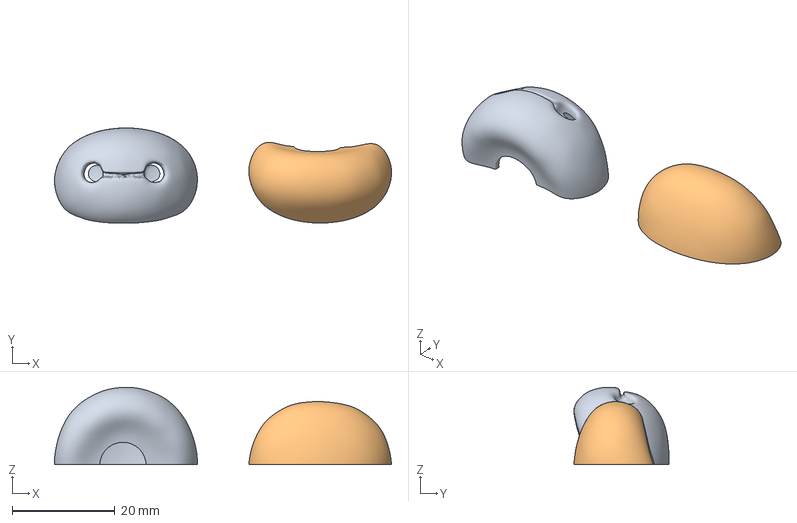
[picture p122: CAD file, 2026-10-17]
mechanical/production_180/HOLD_NOT_FOR_PRINT/06_HEAD_DEVELOPMENT.3mf
65.5 x 18.5 x 15.0 mm
05_head_front_DRAFT
05_head_rear_DRAFT
