Dhaval437/Baymax/mechanical/production_180/panel_fasteners_v2/04_torso_front_DRAFT.stl

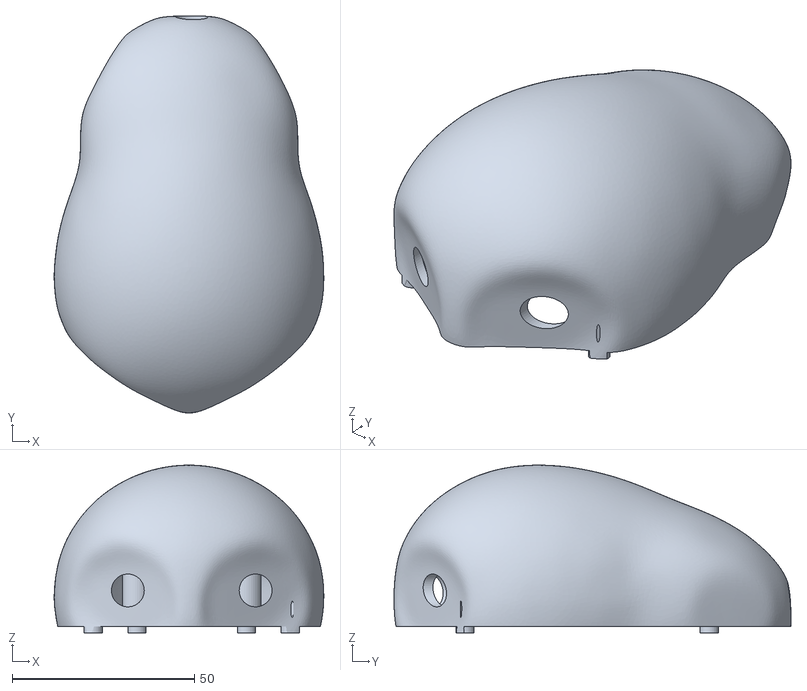
[picture p123: CAD file, 2026-10-17]
mechanical/production_180/panel_fasteners_v2/04_torso_front_DRAFT.stl
73.9 x 108.9 x 46.0
