Dhaval437/Baymax/mechanical/production_180/articulated_v3/BAMBU_REVIEW/05_SMALL_PARTS_REVIEW.3mf

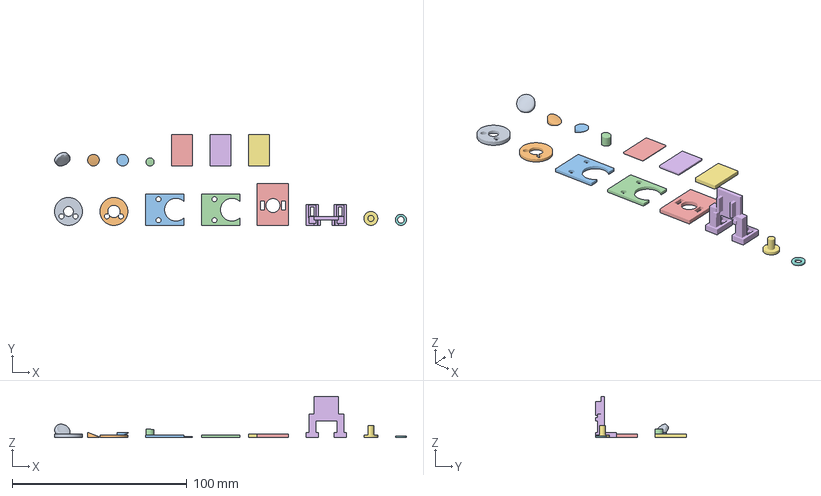
[picture p124: CAD file, 2026-10-17]
mechanical/production_180/articulated_v3/BAMBU_REVIEW/05_SMALL_PARTS_REVIEW.3mf
201.4 x 52.0 x 23.6 mm
07_head_carrier_DRAFT
07_head_horn_clamp_DRAFT
07_Left_horn_clamp_DRAFT
07_Right_horn_clamp_DRAFT
08_power_entry_insert_DRAFT
09_button_bracket_DRAFT
10_talk_button_DRAFT
11_button_retainer_DRAFT
12_Chest_badge_DRAFT
13_Left_arm_access_plug_DRAFT
13_Right_arm_access_plug_DRAFT
14_head_access_plug_DRAFT
15_servo_shim_1_DRAFT
15_servo_shim_2_DRAFT
15_servo_shim_3_DRAFT
