Dhaval437/Baymax/mechanical/blender/draft_stl/02_head_rear_DRAFT.stl

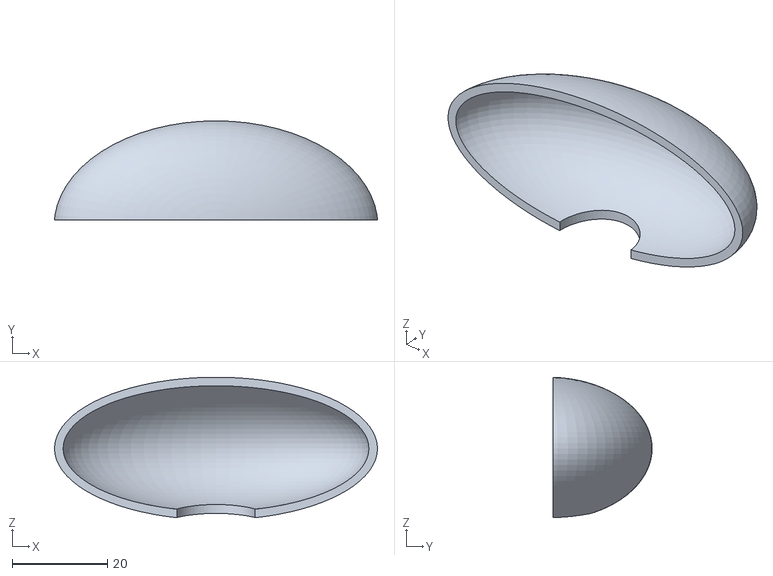
[picture p125: CAD file, 2026-10-17]
mechanical/blender/draft_stl/02_head_rear_DRAFT.stl
67.8 x 20.8 x 29.5
