Dhaval437/Baymax/mechanical/blender/draft_stl/03_neck_sleeve_DRAFT.stl

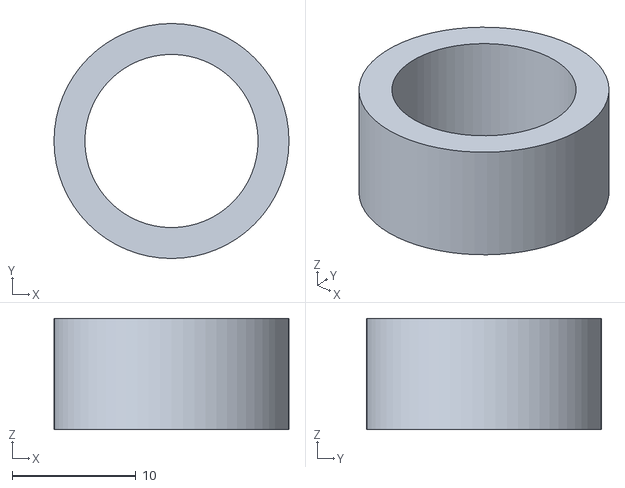
[picture p128: CAD file, 2026-10-17]
mechanical/blender/draft_stl/03_neck_sleeve_DRAFT.stl
19.0 x 19.0 x 9.00
