Dhaval437/Baymax/mechanical/production_180/articulated_v3/review_stl/08_power_entry_insert_DRAFT.stl

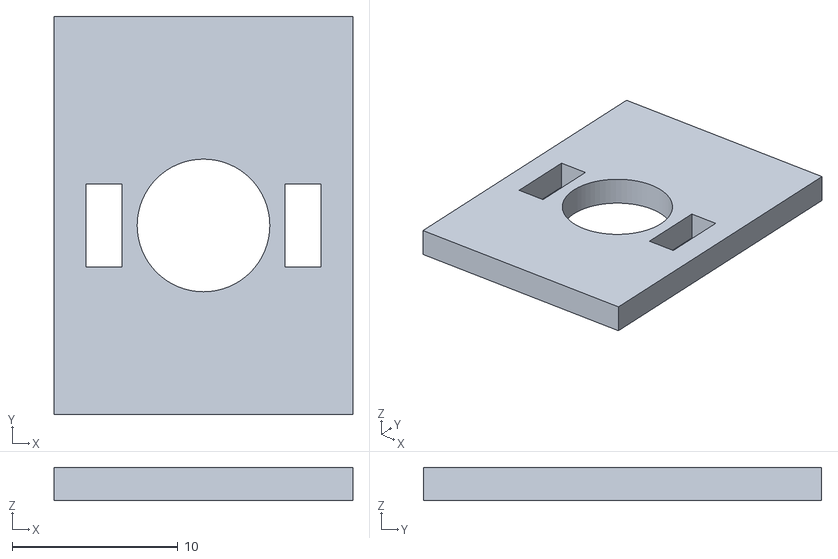
[picture p129: CAD file, 2026-10-17]
mechanical/production_180/articulated_v3/review_stl/08_power_entry_insert_DRAFT.stl
18.0 x 24.0 x 2.00
