Dhaval437/Baymax/mechanical/production_180/draft_stl/05_head_front_DRAFT.stl

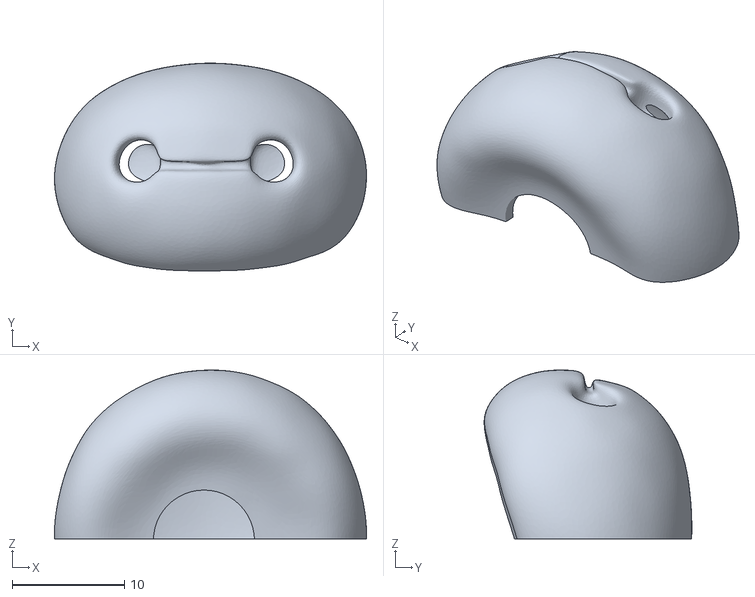
[picture p130: CAD file, 2026-10-17]
mechanical/production_180/draft_stl/05_head_front_DRAFT.stl
27.8 x 18.5 x 15.0
