Dhaval437/Baymax/mechanical/production_180/articulated_v3/review_stl/PAINT GUIDE - 12_Face_marking.001_DRAFT.stl

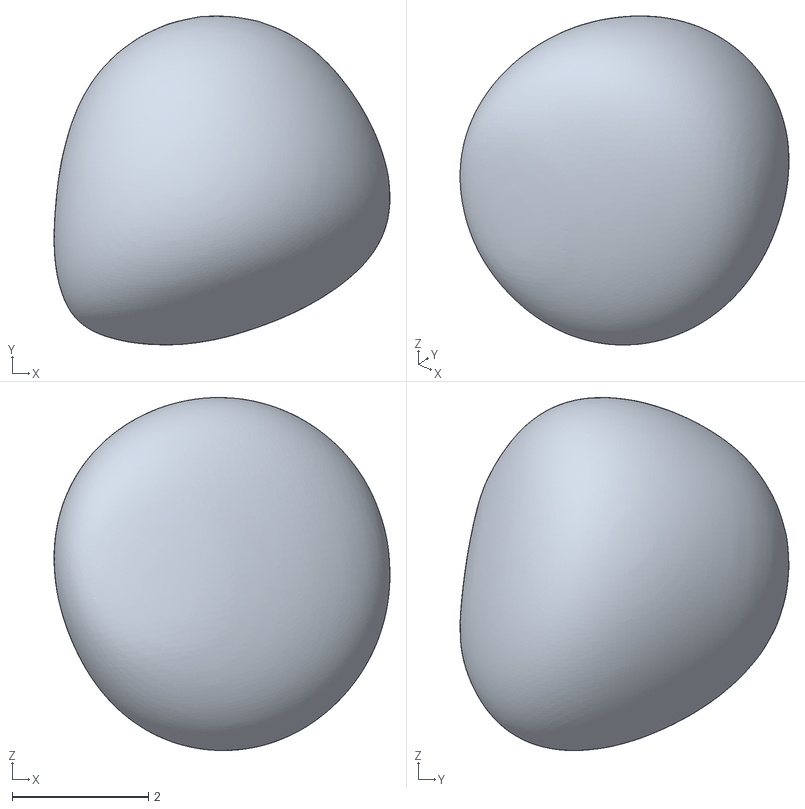
[picture p131: CAD file, 2026-10-17]
mechanical/production_180/articulated_v3/review_stl/PAINT GUIDE - 12_Face_marking.001_DRAFT.stl
4.93 x 4.83 x 5.18
