Dhaval437/Baymax/mechanical/production_180/draft_stl/04_torso_rear_DRAFT.stl

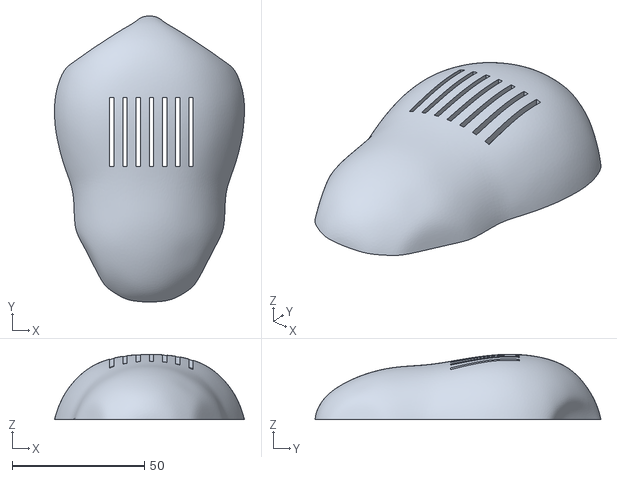
[picture p132: CAD file, 2026-10-17]
mechanical/production_180/draft_stl/04_torso_rear_DRAFT.stl
71.9 x 108.2 x 24.7
