Dhaval437/Baymax/mechanical/production_180/draft_stl/05_head_rear_DRAFT.stl

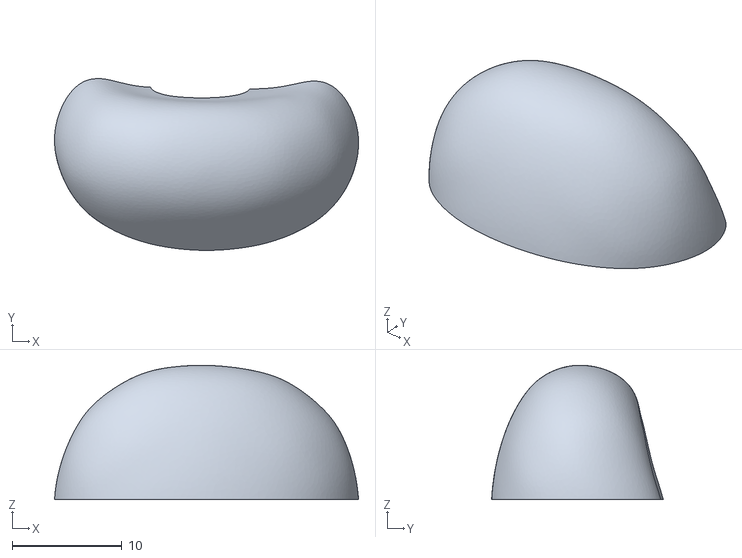
[picture p133: CAD file, 2026-10-17]
mechanical/production_180/draft_stl/05_head_rear_DRAFT.stl
27.7 x 15.7 x 12.3
