Dhaval437/Baymax/mechanical/production_180/articulated_v3/review_stl/15_servo_shim_2_DRAFT.stl

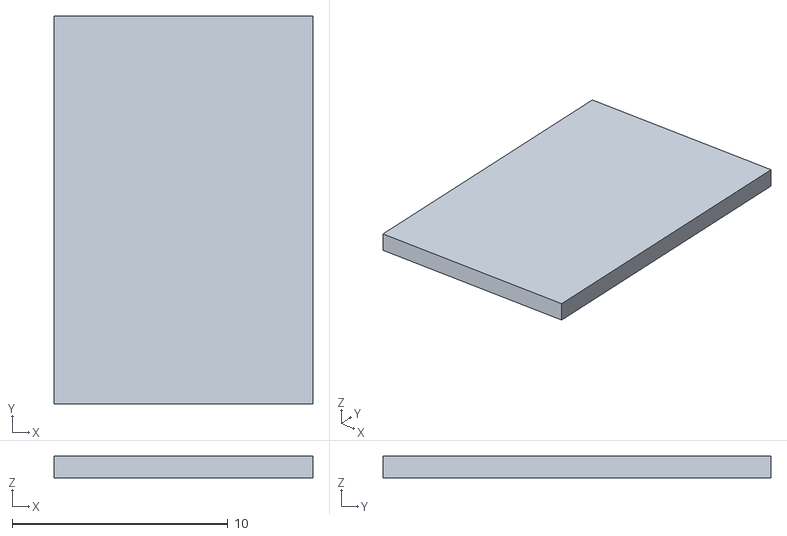
[picture p134: CAD file, 2026-10-17]
mechanical/production_180/articulated_v3/review_stl/15_servo_shim_2_DRAFT.stl
12.0 x 18.0 x 1.00
