Dhaval437/Baymax/mechanical/production_180/articulated_v3/review_stl/11_button_retainer_DRAFT.stl

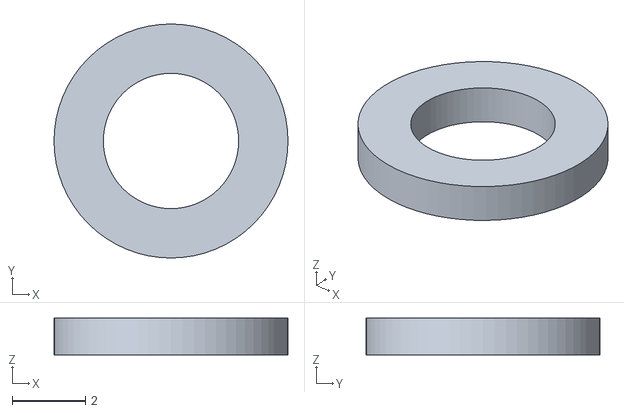
[picture p135: CAD file, 2026-10-17]
mechanical/production_180/articulated_v3/review_stl/11_button_retainer_DRAFT.stl
6.40 x 6.40 x 1.00
