Dhaval437/Baymax/mechanical/production_180/articulated_v3/review_stl/10_talk_button_DRAFT.stl

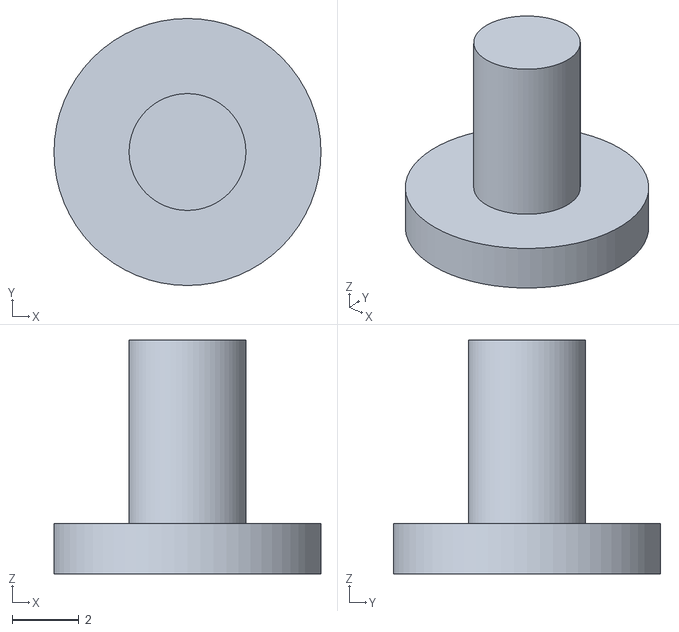
[picture p136: CAD file, 2026-10-17]
mechanical/production_180/articulated_v3/review_stl/10_talk_button_DRAFT.stl
8.00 x 8.00 x 7.00
