Dhaval437/Baymax/mechanical/production_180/articulated_v3/review_stl/03_Leg_left_DRAFT.stl

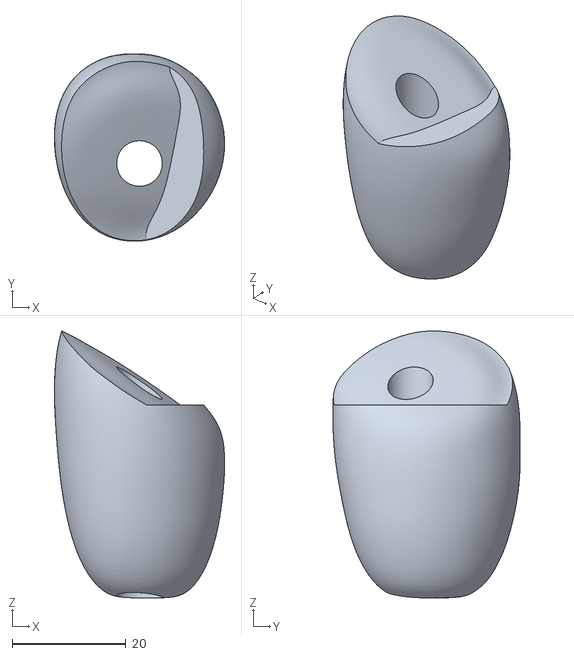
[picture p137: CAD file, 2026-10-17]
mechanical/production_180/articulated_v3/review_stl/03_Leg_left_DRAFT.stl
29.9 x 32.9 x 46.9
