Dhaval437/Baymax/mechanical/production_180/articulated_v3/review_stl/PAINT GUIDE - 12_Face_marking.002_DRAFT.stl

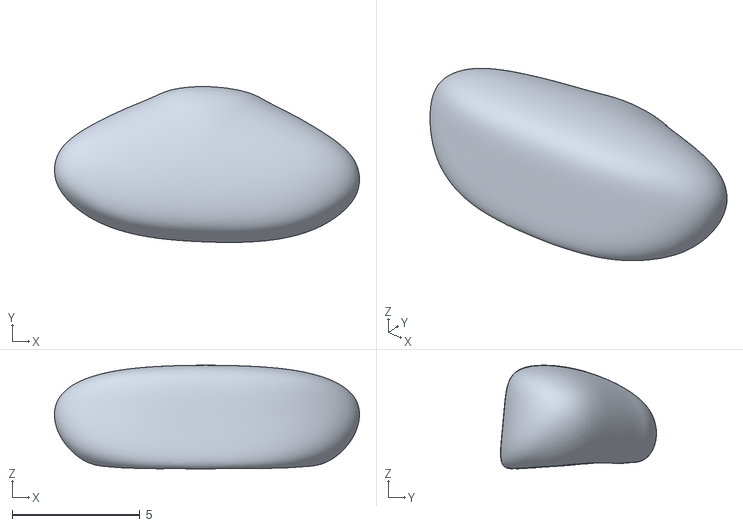
[picture p138: CAD file, 2026-10-17]
mechanical/production_180/articulated_v3/review_stl/PAINT GUIDE - 12_Face_marking.002_DRAFT.stl
11.9 x 6.09 x 4.05
