Dhaval437/Baymax/mechanical/production_180/articulated_v3/review_stl/PAINT GUIDE - 12_Face_marking_DRAFT.stl

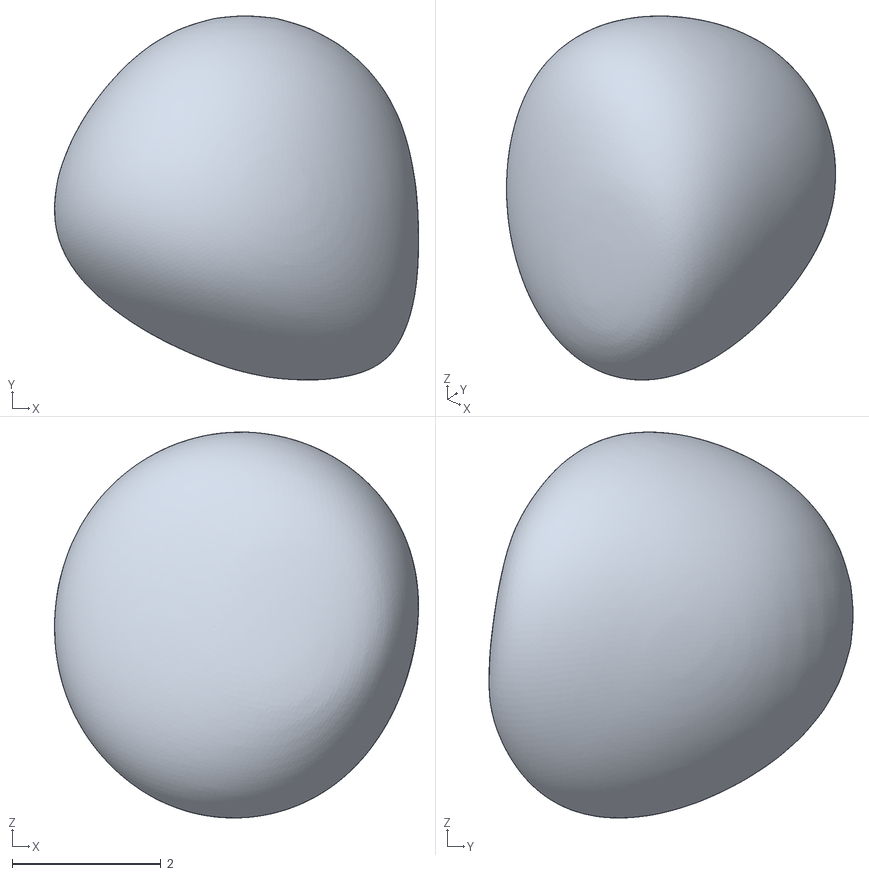
[picture p140: CAD file, 2026-10-17]
mechanical/production_180/articulated_v3/review_stl/PAINT GUIDE - 12_Face_marking_DRAFT.stl
4.89 x 4.89 x 5.18
