Dhaval437/Baymax/(list of files, cad)

Other CAD files:
mechanical/head_led_3mm/sliced/Baymax_LED_head_3mm_SLICED.3mf
mechanical/production_180/geometry_only/01_FIT_TESTS_GEOMETRY_ONLY.3mf
mechanical/production_180/PRINT_PACKAGE_180MM/Baymax_180mm_P1S_PRINT.gcode.3mf
mechanical/production_180/servo_bracket_development/SG90_tab_clamp_right.stl
mechanical/head_led_3mm/assembly_meshes/06_Original_horn_clamp.stl
mechanical/production_180/articulated_v3/BAMBU_REVIEW/01_BASE_REVIEW.3mf
assembly/head-cad/07_head_carrier_DRAFT.stl
mechanical/head_led_3mm/assembly_meshes/03_Left_LED_retainer.stl
mechanical/head_led_3mm/STL/03_Right_LED_retainer.stl
mechanical/production_180/fit_tests/fit_lip_2_socket.stl
mechanical/blender/draft_stl/05_left_foot_DRAFT.stl
mechanical/head_led_3mm/STL/06_Original_horn_clamp.stl
mechanical/production_180/draft_stl/02_base_bottom_DRAFT.stl
mechanical/production_180/HOLD_NOT_FOR_PRINT/02_BASE_BOX_DEVELOPMENT.3mf
assembly/arm-cad/13_Left_arm_access_plug_DRAFT.stl
mechanical/head_led_3mm/assembly_meshes/07_Original_roof_plug.stl
mechanical/head_led_3mm/STL/02_LED_head_rear.stl
mechanical/production_180/draft_stl/01_base_box_DRAFT.stl
mechanical/production_180/fit_tests/fit_lip_3_socket.stl
assembly/arm-cad/04_torso_front_DRAFT.stl
mechanical/blender/draft_stl/04_right_arm_front_DRAFT.stl
mechanical/head_led_3mm/assembly_meshes/05_Original_head_carrier.stl
mechanical/head_led_3mm/STL/03_Left_LED_retainer.stl
mechanical/production_180/articulated_v3/review_stl/13_Left_arm_access_plug_DRAFT.stl
mechanical/production_180/draft_stl/06_Right_arm_and_hand_front_DRAFT.stl
mechanical/production_180/panel_fasteners_v2/06_Right_arm_and_hand_front_DRAFT.stl
assembly/arm-cad/07_Right_horn_clamp_DRAFT.stl
mechanical/head_led_3mm/assembly_meshes/REFERENCE Left LED lens.stl
mechanical/production_180/articulated_v3/review_stl/06_Right_arm_and_hand_front_DRAFT.stl
mechanical/production_180/draft_stl/06_Left_arm_and_hand_rear_DRAFT.stl
mechanical/head_led_3mm/assembly_meshes/01_LED_head_front.stl
mechanical/production_180/articulated_v3/review_stl/07_head_carrier_DRAFT.stl
mechanical/production_180/draft_stl/03_Leg_right_DRAFT.stl
mechanical/production_180/panel_fasteners_v2/06_Left_arm_and_hand_rear_DRAFT.stl
mechanical/blender/draft_stl/04_left_arm_front_DRAFT.stl
mechanical/production_180/panel_fasteners_v2/02_base_bottom_DRAFT.stl
mechanical/blender/draft_stl/04_left_arm_rear_DRAFT.stl
mechanical/production_180/panel_fasteners_v2/03_Leg_left_DRAFT.stl
mechanical/production_180/articulated_v3/review_stl/06_Left_arm_and_hand_rear_DRAFT.stl
mechanical/production_180/panel_fasteners_v2/03_Leg_right_DRAFT.stl
mechanical/production_180/articulated_v3/review_stl/04_torso_front_DRAFT.stl
mechanical/production_180/articulated_v3/review_stl/05_head_rear_DRAFT.stl
mechanical/production_180/articulated_v3/review_stl/13_Right_arm_access_plug_DRAFT.stl
mechanical/production_180/articulated_v3/review_stl/07_Left_horn_clamp_DRAFT.stl
mechanical/production_180/articulated_v3/review_stl/06_Left_arm_and_hand_front_DRAFT.stl
mechanical/production_180/articulated_v3/review_stl/07_head_horn_clamp_DRAFT.stl
mechanical/production_180/articulated_v3/review_stl/06_Right_arm_and_hand_rear_DRAFT.stl
mechanical/production_180/articulated_v3/review_stl/14_head_access_plug_DRAFT.stl
mechanical/production_180/articulated_v3/review_stl/05_head_front_DRAFT.stl
mechanical/production_180/articulated_v3/review_stl/07_Right_horn_clamp_DRAFT.stl
mechanical/production_180/articulated_v3/review_stl/02_base_bottom_DRAFT.stl
mechanical/arm_extension_5mm_5mm_fit/Baymax_arm_extension_5mm.scad
mechanical/arm_extension_10mm/Baymax_arm_extension_10mm.scad
mechanical/blender/Baymax_150mm_DRAFT.blend
mechanical/head_led_3mm/Baymax_LED_head_3mm.blend
mechanical/production_180/Baymax_180_BASE_LAYOUT_CANDIDATE.blend
mechanical/production_180/Baymax_180_INTERNAL_LAYOUT_AUDIT.blend
mechanical/production_180/Baymax_180_INTERNAL_LAYOUT_WITH_FASTENERS.blend
mechanical/production_180/Baymax_180_MECHANICAL_DEVELOPMENT.blend
mechanical/production_180/articulated_v3/Baymax_180_ARTICULATED_PROTOTYPE.blend
mechanical/production_180/fit_tests/fit_M3_nut_and_screw.stl
mechanical/production_180/panel_fasteners_v2/Baymax_180_SERVICE_PANELS_V2.blend
mechanical/production_180/servo_bracket_development/SG90_adjustable_tab_clamp.blend
mechanical/reference_model/Baymax_ARMS_DOWN_STRAIGHT_HEAD_150mm.blend
mechanical/reference_model/Baymax_BOTH_ARMS_DOWN_150mm.blend
mechanical/reference_model/Baymax_ORIGINAL_150mm_WORKING.blend
