Dhaval437/Baymax/assembly/NEXT_SESSION.md

> 26 October: The separate battery-powered walking robot requirements are in [WALKING_ROBOT_BRIEF.md](WALKING_ROBOT_BRIEF.md). Read that brief before planning new hardware; preserve the existing Baymax.

# Continue Baymax from here ? 19 October 2026

## 20 October continuation
- Latest firmware `2026-10-20-noise-v16`, running MD5 `7aca4921e8e1ac0c7117c3ba35684532` verified after USB upload. During v15 observation, a60sec/1920044byte recording uploaded very slowly (463447->749211 bytes over~20sec). No evidence user actually spoke continuously; foreground capture could be extended by isolated spikes because endpoint still used raw loud. v16 uses confirmedSpeech48ms for both voiced count and endpoint quiet reset; preroll retains starts. Integration test feeds periodic single-frame clicks after speech and verifies endpoint closes in<2sec. Native tests/build/flash pass. Six Python hallucination/fallback tests and63Node tests previously passed. Wide speaking motion remains; no new listening-side gestures. Do not overclaim physical word accuracy fixed: user had reported missing words and said repeated okay wasn't theirs. Server restarted; final ready check pending when written.
- Latest ESP firmware `2026-10-20-startup-v15`, running MD5 `f574df3f2463cc74ca890c95025ccdef` matches flashed binary. Repeated identical13164byte (~0.41sec) clips after mic restart persisted with motors0 in v14. Added160ms settling eligibility before onset can trigger, retaining samples after initial32ms in750ms preroll so ongoing first words are available. v14 onset48ms and server hallucination filters retained. Six Python recognition tests (including preserving legitimate "okay"/ordinary sentences), native firmware tests, compile and flash passed. User reported missing words before this latest startup fix; still requires real validation. Server restarted and fresh listening telemetry verified; do not claim overall recognition resolved.
- Live test after recognition fallback transcribed a full question ("I think it's going to destroy humanity. What do you think?") and ESP logged two completed Reply played events. Then0.46sec-ish noise generated ~100 "okay" repetitions. User explicitly confirmed they did not say those words. Added transcript rejection (both primary/fallback): more than duration*8+8words, or >=12words with <=25% unique words => empty/no-speech; never send that result to answer generation. Restarted service after passing tests. Do not claim all hallucinations eliminated or full recognition fixed. Latest worker warmup pending final verification when written.
- v14 live follow-up still showed no-speech clips (including3.53sec,RMS3765 afterDC removal, recognizer254ms). Do NOT claim the onset gate alone solved the issue. Added server recognition fallback: if Silero keeps0seconds and yields no words on0.15..60sec clip, retry Whisper once without Silero, keeping Whisper no-speech0.6/logprob-1/compression2.4 checks. No forced transcript/hotword substitution. Four Python mock regression tests pass; all63Node tests pass. Restarted local service to load fallback. Need real user recognition validation; no end-to-end success confirmed yet.
- Latest installed `2026-10-20-onset-v14`, running MD5 `c808cc1a1cce992a427256e4f4de27b5` verified. User again reported ignored/misrecognised words. Live pre-change evidence: repeated0.4sec-ish clips rejected as no speech, uploads1.8..4sec; actual5.24sec speech did transcribe imperfectly and generate answer, but upload alone7.48sec. No server error/lockup demonstrated. Added SpeechOnset48ms consecutive above-threshold gate, retaining750ms preroll and counting already-confirmed voiced samples; isolated frame spikes no longer launch recording. Removed new between-reply/listening motor starts as possible noise source; full wide alternating playback gestures unchanged, existing in-progress gesture may finish after playback. Native servo/endpoint/noise/onset tests pass; compile/upload/hash verified.
- After v14 restart, fresh connected/listening telemetry, no movement, wake RMS110..181 versus450threshold, no events/empty uploads in initial observation. Asked user via async prompt for "Baymax hello", greeting then full question to verify end-to-end. Do not claim recognition fully fixed without that evidence. Tiny.en recognizer unchanged; no exact claim motor noise caused each rejected recording.
- Latest installed `2026-10-20-turns-v13`, MD5 `1328f014c5f7db42efcb42f2c679fb74` verified against binary. User reported premature sentence cutoff and missed/slow replies during longer conversations; explicitly likes current movements, so v12 motion unchanged. Conversational endpoint base650->1200ms, wake450->700ms, duration allowance /20->/12, observed-pause allowance400->600ms, ceiling2000->2600ms. Native test proves one-second mid-sentence pause can resume in same capture. This is silence detection, NOT semantic sentence completion.
- Found firmware requests lacked segments=1 despite existing tested server sentence delivery. Both original POST and refused-connection retry now request async=1&segments=1; existing part polling enables earlier first audio. Interrupted HTTP200 audio downloads retry same unplayed immutable part up to3times; never replay after playback starts. 63Node tests and native servo/listening/noise tests passed; build/upload/hash verified. Physical pause/latency validation remains needed. Latest pre-fix server snapshot had15completed, noerror,14memoryturns; did not demonstrate server lockup. Shared I2S remains half-duplex, cannot capture while speaking/processing.
- Latest installed `2026-10-20-motion-v12`, running MD5 `3eb81a870b9c93c79c41d4e62b522d83` matches uploaded binary. User explicitly authorized wider arm/head motion after adding extenders. JOINTS now1000..2000us around1500, intended nominal90-degree total sweep (physical angles unmeasured). Head accompaniment now full excursion rather than half. Quintic easing preserved; normal14us/frame and expressive28us/frame let wider sweeps reach endpoints; expressive repeats twice per6sec. Native tests verify both endpoints, step bounds, centering, stop/stall/I2C failure; test runner now propagates negative assertion exits.
- Speech gestures use alternating arms plus head at full configured strength. During active conversation between replies, alternate6sec arm+head cycles with at least2500ms quiet gaps, only starting outside capture/jobs. Passive wake mode remains still, and submission stops gestures as before. This preserves quiet listening windows and idle sensitivity fixes. Compile/upload/hash verified; physical movement still requires observation, no exact angle measured.
- Latest installed firmware is `2026-10-20-idle-v11`, verified running MD5 `11b26059f04a4d4ddf56355ce50a5dd0`. Fixed idle microphone sensitivity: replaced unbounded per-frame noise-floor EMA with a bounded quiet-window estimator (20th percentile of 125 eligible frames, floor30..800, slow upward adjustment, prompt downward recovery). Excludes capture/above-threshold/motor activity. Removed wake-mode multiplier jump from2.5 to3.0: wake and conversation now use2.5, minimum450. Existing endpoint/preroll preserved.
- Before fix, dashboard showed fresh/listening microphone but wake trigger rising1260->2579. After USBflash and server restart, running fingerprint matches binary, dashboard connected/fresh/listening/Wi-Fi/motion true; latest wake samples trigger450, RMS165..3060. Physical "ouch" recognition after a long pause still requires user validation; do not claim it was demonstrated. Final native servo/endpoint/noise-floor tests passed, including simulated long idle, bounds and quiet recovery; all63Node tests passed. Build and flash verification passed. Server PID stored in verification/final-server.pid.
- Latest firmware now `2026-10-20-latency-v10`, running MD5 verified `1ef177342a5c34d7298bc1da9a9f4d4b`. Reduces base conversational end-of-speech silence from1000 to650ms (500ms spoken example1025->675ms); wake base500->450ms. Speech-duration allowance, observed-hesitation+400ms and2sec ceiling remain;750ms preroll/250ms transmitted tail unchanged. Native endpoint/servo tests and63Node tests passed, compile andUSBflash verified. Server restarted. No claim of measured total response speedup yet.
- Pre-change last6completed replies averaged receiving990ms, recognition953ms, thinking5123ms, synthesis2529ms. Thinking is currently largest. Tested stable system-prompt prefix but saw no consistent improvement: rainbow6820->7103ms, planet2638->2302ms; prompts produced differing token counts. Reverted prompt experiment; local-provider remains prior prompt. Reproducible experiment in assembly/benchmark-prompt-cache.mjs; results verification/prompt-cache-benchmark.json. Do not claim that experiment improved runtime. RSSI atverification-74.
- Server-only learning features now active (firmware remains speech-v9). learning-store.mjs persists explicit corrections and voice mode in ignored assembly/private/learning.json. Commands while awake (or prefix Baymax): "What did you hear?", "I said ...", then separate "Remember this correction" within2min; "Forget my corrections"; "Use fast voice"/"Use character voice". Corrections are bounded30 phrases, passed as at most600chars of recognizer hotwords, NOT transcript replacement or model retraining. Memory changes are atomic and require explicit save. No automatic code rewriting.
- New standard Windows SAPI voice option uses assembly/fast-voice.ps1 with plain-text file input (no speech text shell interpolation) and existing output audio filter. Character voice remains default; mode persists once chosen. Switching clears PCM cache and wake cache. Benchmark same13-word sentence: character4711/4657ms; fast1609/802ms. Processed fast pipeline1078ms, valid24kmonoPCM,4.63sec audio. Local synthesis only, no end-to-end speed claim. Benchmark report assembly/verification/fast-voice-benchmark.json.
- Dashboard now has Learning & speed panel and recommendations from the last20 completed ordinary reply preparation timings. Needs3replies before recommendation; excludes capture/download/playback; timings reset atserverrestart. No personal transcripts persisted for metrics. 63Node tests pass incl store restart/deletion/dedup, explicitcommands, compressedtransport, timingrecommendations. Dashboard script syntax and HTTPcontent verified; browserautomation tool failed to initialize, no visual inspection claimed.
- Updatedserver restarted successfully: speechloaded, fixedaudio prewarmed, USBfresh/listening/Wi-Fi/motiontrue. Physical spoken correction/fastvoice switch still need usertest. No new ESPflash required. Avoid loading another Sopro process beside live server: duplicated model benchmark process exited under resourcepressure. Laptopdisk nearlyfull; do not download moremodels or delete userfiles without scope.
- Latest installed `2026-10-20-speech-v9`, running MD5 verified `6244867ace0ac1a2368aeee2722552e1`. Server running, wake/goodbye prewarm completed; USB telemetry fresh, listening/Wi-Fi/PCA/motion true. Latest small upload12652bytes received153ms, transcribed282ms (not comparable to earlier58sec clip and not a full spoken-response benchmark). Wi-Fi RSSI-76; latency still needs physical validation.
- v9 reuses idle reply PSRAM buffer for ROM miniz zlib lossless compression (16 probes), sends Content-Encoding:deflate only when smaller; raw fallback preserves samples. Server bounded inflate, validated WAV, old raw clients supported. Trims only endpoint tail beyond250ms; keeps preroll. Node59 tests passed including corruption/oversize compressed payloads/sample equality. Native servo/listening tests passed; compile/upload verified.
- Talking gestures now restart bounded cycles while speech has >2sec left, alternate arms with head accompaniment; gentle cycles40% strength. Existing1300..1700us limits/easing/watchdog remain, no180-degree expansion. Detailed replies60words/240tokens instead90/360, full conversation memory retained. Direct leading Pmax/P max normalized toBaymax; ordinary mentions unchanged. Fixed wake/care-end/goodbye PCM prepared on server startup.
- User asked for RSI/self-improvement recommendation. Recommended measured correction-based updates; no autonomous code rewriting or endless speech/movement implemented. Shared I2S remains half-duplex, so robot cannot recognize user while speaker is playing. Prior observed58.096sec user utterance: upload49104ms, recognition2695ms, thinking9219ms, then synthesis; do not attribute all delay to speech recognition.
- Microphone update: local-provider.mjs now applies a gentle 70 Hz high-pass before recognition to remove DC/rumble without gain. Live mic snapshot showed DC 2564, RMS 8760; no confirmed clipping. Synthetic offset test reduced DC 2500 to -0.026 and preserved 1 kHz RMS 3535.53 ->3534.82. Shared speech_recognition.py used by resident and legacy paths: tiny.en int8, 4 threads, beam3, deterministic decoding, condition_on_previous_text=False to reduce segment carry-over repetitions; padded VAD and wake hotwords retained. No transcript substitution of beating/painting/paining.
- Recognition comparison did NOT establish a fix for "it's paining": tiny.en and base.en both heard synthetic speech as painting; base also dropped Baymax on one clip. Report assembly/verification/recognition-comparison.json. Small.en download ran out of disk; removed its partial model, base model and temporary duplicate created this turn. Roughly 574 MiB free afterward. Existing tiny model retained. Larger models need additional space; never claim full recognition issue fixed. 57 Node tests pass. Firmware remains v8; server restarted for filtering/settings. User's live microphone confirmation still needed.
- Latest installed firmware `2026-10-20-status-v8`, running MD5 verified `ae71a43b61b915940b8fe23c7dc657a5`; server restarted. Adds authenticated per-request X-Baymax-Motion/Pca/Conversation headers, parsed strictly into booleans or unknown. Spoken "check status" bypasses LLM and wake gate, reports receipt over Wi-Fi/server, recognition, motor control/controller availability, and active versus waiting state. Does not claim physical motor movement. Status does not mutate server memory/quiet latch; returns conversation end for passive state.
- Name normalization handles Bay Max, Be Max, spelled B-E M-A-X / B-A-Y-M-A-X and standalone direct-address Max, preserving ordinary sentences about Max. Ow already counts as distress. Whisper now beam3/hotwords Baymax,ouch,ow,check status with padded VAD retained. Raw transcript saved in dashboard snapshot rawHeard; normalized text in heard. No claim of perfect physical recognition.
-57Node tests passed;17targeted tests rerun after synthetic audio revealed "Check status" -> "checks status", now explicitly accepted. Actual synthetic Sopro->Whisper recognized Baymax and ouch; report assembly/verification/voice-commands-v8.json retains pre-fix classification failure for checks status. The subsequent parser regression test verifies the correction; do not describe that report as a wholly passing rerun.
- Spoken offline status is NOT supported: recognition/TTS still depend on laptop server. If Wi-Fi/server unavailable, a spoken check-status request cannot be recognized. Explain this limit rather than fabricating offline connectivity reports.
- Final latest is `2026-10-20-wake-v7`, USB flash verified and running MD5 `3ee11ab3fd4c57ff4173a618450b1cd2`. Adds one-second startup room-noise calibration (after I2S startup discard), preserves pre-roll, short wake silence500ms versus850ms; active-conversation pause policy unchanged. Reverted interim v6 eight-second wake cap to preserve full initial questions (60sec ceiling). Final fingerprint report updated; service restarted. Native motion/listening tests passed;54Node tests passed for server changes.
- Before v7: microphone repeatedly triggered on levels678–1450 with threshold450; recognized one8sec clip as unrelated words. Cannot infer whether those words were actual speech or a hallucination. One v6 upload completed256044bytes in7011ms/RSSI-74. v7 startup RSSI-69. Cached-ouch path and calibration are installed, but user-perceived wake latency and physical playback still require verification. Do not promise no future lag.
- Latest `2026-10-20-wake-v6`, USB installed and running MD5 verified `b1618651b97a5641dd693d9c7f74a812`. User reported persistent lag after v5. Observed real failed upload:353256/564780bytes after29334ms, then invalid recording. Do not claim all lag was TTS. Board RSSI-72dBm; laptop RSSI-69dBm,2.4GHz link27/36Mbps.
- v6 disables segmented requests (returns to whole uninterrupted audio; server opt-in support retained). Short distress cues use cached wake greeting even on active /turn; removed20sec pre-recognition wake cooldown so repeated ouch works.54Node tests pass. User physical ouch reply still needs confirmation.
- Restored Whisper VAD with threshold0.35,500ms padding,min_speech0 to filter noise without aggressively trimming word edges. Firmware wake capture capped8sec (conversation60sec preserved), base trigger restored450 after lower v5 trigger caused frequent empty clips; no-speech retry reduced1sec to100ms. TCP_NODELAY enabled through PromptClient, upload durations/RSSI/status now logged. Server body timeout60sec instead15sec allows slow uploads to finish; this is reliability mitigation, not a speed guarantee. Earlier v4/v5 arm improvements retained within1300–1700us.
- Newest firmware `2026-10-20-sentence-v5` supersedes v4 after user still reported dropped openings and slow replies. USB upload hashes and running MD5 `7a756c85a3ff82618f89eaf602049fe0` verified. Server restarted and fresh telemetry confirms listening/PCA/motion; physical first-word capture remains unconfirmed.
- Opt-in `/device/turn?async=1&segments=1` (and wake) publishes sentence PCM as generated. Firmware requests `?part=N`, follows X-Reply-More, listens only after final part. Older firmware retains whole-reply response. Server keeps busy through generation, validates each part, and commits memory on full success. Tests verify first part accessible before second completes and retryable retrieval. There can be inter-sentence pauses if synthesis falls behind playback.
- Playback PCM edges trimmed conservatively with80ms padding; internal pauses preserved. Cached wake greeting also trimmed. Mic restarted directly in final playback handling before phone maintenance. Conversation trigger lowered to65% base/twice noise floor; servo motion cannot teach noise-floor estimator. Second Whisper VAD disabled because firmware already endpoints; monitor for false transcriptions of background noise. Shared I2S is still half-duplex.
- More expressive arm motion: two smooth sweeps in6sec, full existing calibrated1300–1700us range for explanation/greeting, alternating arms between explanation parts where previous gesture finished, head accompanying. No blind180degree expansion: assembled clearance unverified. Native tests confirm bounded steps and center return.
- 53Node tests plus native motion/listening tests passed. Real local voice-only benchmark: whole reply ready5202ms; first sentence1491ms; all sentence chunks8112ms. This is earlier onset, NOT faster total synthesis or an end-to-end latency guarantee. Report `assembly/verification/sentence-delivery-benchmark.json`.
- Latest installed firmware is now `2026-10-20-conversation-v4`, USB COM14 flashed and running MD5 verified `45b820d58110c555cb75f984f6f5a0d3`; SHA256 `E9605197E7CE7357FD43C7D584204A530B1486C9532698E3E54F1051E9DE5B2E`. Server restarted, PID recorded in final-server.pid, fresh telemetry verifies listening/PCA/motion enabled.
- Fixed avoidable follow-up capture gaps: no waiting for servo gestures or 1200ms post-reply pause, speaker zero tail reduced 500ms to50ms, mic startup discard reduced400ms to32ms, pre-roll250ms to750ms. Shared I2S remains half-duplex: speech during robot playback is NOT captured. Physical first-word accuracy and motor-noise false triggers still need user validation.
- Server now sends bounded `X-Gesture`: greeting/farewell right arm with gentle head turn; explanation left arm with head turn; care/distress gentle head-only; acknowledgement head-only. Existing 1300–1700us calibrated limits, easing and stop behavior preserved. Head is a turn axis, not a physical nod axis. Both arms are not driven together. Native servo tests include combined head/arm.
- Ready-result polling reduced1000ms to150ms (initial700ms to150ms). Identical completed spoken answers reuse bounded12MiB RAM audio cache; question/context generation is never cached. Invalid or overlong audio not retained. Ordinary answers aim35words, brief18, detailed90 unchanged; model keep_alive30min. All50Node tests and both native firmware tests passed. Voice CPU benchmark fixed sample:4threads3.411s,2threads4.541s for2.763saudio; retained existing4-thread setting. No measured end-to-end latency claim yet.
- Installed and verified `2026-10-20-network-v3` after the user requested that the connection error not return. It retains each recording while retrying a refused laptop connection up to five times (six total attempts), uses increasing short backoff, disables Wi-Fi sleep, and resumes listening after an unrecovered outage. Intermediate successful retries no longer appear as failures. Dashboard history clears on a real ESP32 reboot so old pre-update errors are not presented as current.
- The wireless installer paused the robot but could not confirm its reboot; no success was assumed. The board was recovered through connected USB, flash hashes were verified, and the laptop service was restarted. Running revision and MD5 match the compiled binary: `2026-10-20-network-v3`, MD5 `0e1bf0f2e09cdc32ec162d98df12a0e6`, SHA256 `27B9FC9CAD935FF144BDC3A78E99D8B8A7817B174F1CE0696D53EE7607D0B31F`.
- Final status: Wi-Fi connected, listening true, correct laptop server address, fresh USB telemetry, PCA/motion available, empty post-reboot error history. Eighteen targeted dashboard/device/integration tests passed. A physical reply was confirmed on v2; a fresh spoken reply on v3 is useful but not required to establish the installed fingerprint and network state.
- User resumed testing; the laptop server is running again (PID file identifies it).
- User reported no responses. Serial telemetry showed repeated `Laptop request HTTP -1` errors despite working microphone levels and Wi-Fi association. A few recordings reached recognition but returned no speech.
- Built and installed `2026-10-20-network-v2`: TCP connect/read timeouts are 5 seconds; a failed TCP connection is retried twice using the same recording. Requests that may have reached the server are not replayed. ESP32 Wi-Fi sleep is disabled.
- OTA reboot and running-image MD5 were verified: `445237f6f9009e5ce414baf225521435`. SHA256: `E8A9C7F2D411639E3145E977EBCE8486AFC5A714DC69FC69BBECC14EC9B11F74`.
- User confirmed "Yes, it replied" after the update. Serial telemetry also reported "Reply played. Speak your answer after a short pause." The following recording uploaded completely (75,628 / 75,628 bytes; 2.362 seconds, 0% clipping) and reached speech synthesis.
- Added local-only upload byte counts and microphone RMS/peak/DC/clipping diagnostics to the dashboard state. No raw audio is retained by this addition; the authenticated LAN status remains redacted. All 18 targeted device/integration/dashboard tests passed.
- Server is running and the robot is listening. Continue the physical care/joke/quiet-mode checks when requested. A successful reply is verified, but it does not establish long-term Wi-Fi reliability.
- Earlier stopped-state instructions below are historical. Do not start a duplicate server.

User explicitly stopped work for the night. Do not resume until asked. Continue the existing project, do not start over.

## Stopped state
Baymax was paused through its authenticated phone control API; listening=false was verified. The pause handler also stops servo PWM. The identified Baymax server and speech/serial child processes were stopped. The ESP32 starts listening automatically after a power cycle, so leave robot power off overnight if desired.

## Completed and saved
- Installed ESP32 firmware: 2026-10-19-adaptive-v1. Adaptive silence timing, 60-second capture/playback ceilings, adaptive follow-up window. Existing smooth six-second motor gestures and volume peak 20000 remain.
- Adaptive RAM conversation memory keeps recent exchanges and summarizes older ones when the context budget fills. Real-model name/color/corrected-budget check passed.
- Latest server code adds general-care guides for small cuts, minor heat burns, colds, mild headaches and hydration, with NHS sources. An unrestricted small-model health test produced an unsafe remedy, so that version was NOT deployed. Common-care guidance now bypasses freeform generation. This is limited educational support, not clinical validation or a diagnostic system.
- Friendly robot jokes and spoken Ha ha responses are implemented. It is synthesized speech, not natural laughter audio.
- I am satisfied with my care (including contractions and simple variants) plays a farewell, clears conversation memory and latches quiet mode until a recognized Baymax/ouch/short distress cue. Negation and hypothetical examples do not trigger it. Silence gate also handles stale turn-route requests and failed farewell synthesis.
- 47 Node regression tests passed. Six synthetic response checks passed; the general encouragement case used the local model. Farewell speech synthesized successfully (5.79 seconds), spoken laugh (3.27 seconds). These were not played on the physical robot.
- Latest server changes were restarted and loaded, then explicitly stopped for the night. No further ESP32 flash is needed for the care/humor/end-command changes.

## First next steps when the user asks to continue
1. Start the existing laptop service with Start-Baymax.cmd or node --env-file-if-exists=.env start-baymax.mjs in this project. Avoid duplicate servers. If launching in background use hidden window and record PID in assembly/verification/final-server.pid.
2. Verify models/server ready, the local dashboard, and robot Wi-Fi status. Device-specific robot and laptop addresses are intentionally omitted from the repository; check the current private configuration instead of assuming they are unchanged.
3. Resume the ESP32 through authenticated phone control only when asked to continue. Private key is in firmware/MiniBaymax/SetupPrivate.h; do not print it. Status returns a session needed for X-Baymax-Session. Power-cycling auto-starts firmware listening.
4. Ask user to try a basic-care question, a joke, spoken laughter, then I am satisfied with my care. Verify physical farewell playback and quiet-until-wake behavior with the user. This physical test remains pending.
5. Marathi recognition/TTS is still not enabled. Current recognizer is tiny.en and Sopro English voice. Do not claim multilingual support.

## Evidence and main files
- assembly/verification/adaptive-release.json
- assembly/verification/companion-model-test.json
- assembly/verification/companion-audio-test.json
- assembly/FINAL_RELEASE.md
- companion-replies.mjs, companion-personality.mjs, wake-response.mjs
- device-server.mjs, local-provider.mjs, conversation-policy.mjs
- public/robot-dashboard.html

Prior mechanical/assembly work and all existing files remain in the project. User wants continuation tomorrow, not a scheduled reminder or automatic restart.
