Dhaval437/Baymax/assembly/SERVO_DIAGNOSTIC_STATUS.md

# Servo diagnostic — 4 October 2026

User reports all three servos buzz but do not turn even after securing a loose supply connection. Repeated completion messages do not prove electrical or physical success.

Audit: previous code uses 50 Hz / 14-bit LEDC. Duty calculation for 1400/1500/1600 us gives about 1399/1499/1599 us after quantization. No gross period or pulse-width error established. Prior 16-bit allocation defect was already corrected before these buzzing tests. Previous controller does not check ledcWrite return values, so its software completion messages are insufficient evidence.

Separate firmware/ServoDiagnostic uses ESP32Servo 3.2.1, no custom ServoController, Wi-Fi, I2S or application code. One H/L/R command performs one bounded 2.4-second 1500->1600->1400->1500 us cycle then detaches. X cancels; ? reports software state. No movement on boot; only one servo attached. These are conservative pulse widths, not calibrated angles.

Compiled successfully (322399 bytes flash, 23372 bytes RAM), uploaded COM13 with flash verification. Main application remains preserved in firmware/MiniBaymax, but board currently runs diagnostic only. No test movement sent after this upload. Physical output waveform and servo-terminal voltage remain unmeasured. Library replacement is an isolation test, not a confirmed fix.

Next: with USB powering ESP32 and external positive disconnected from ESP32 5V, use external 5V for ONE unloaded servo, common ground, horns off; one short diagnostic test. Stop power if buzzing persists. Voltage under load and, if available, oscilloscope/logic-analyzer verification distinguish signal and power problems.

Follow-up: ran the bounded head diagnostic on the original motor and then a second motor using GPIO16. Both serial sequences completed and outputs returned LOW. User explicitly reported original motor did not move; following second test user reports continued failure/frustration, without a clear distinction between silence and buzzing. No physical waveform or voltage measurement is available. Root cause remains unconfirmed; inspect current end-to-end wiring and measure servo-terminal voltage during a bounded test before more repetitions.

User subsequently confirmed physical motor movement, but slight. At user request widened diagnostic to 1300–1700 us (previously 1400–1600 us), slowed ramp to 4 us per 20 ms, and extended bounded duration to five seconds. Compiled and uploaded successfully. Root cause of earlier failures remains unconfirmed; do not infer all wiring or motors validated.

4 October follow-up: user confirmed head motor moved perfectly. Arm motion remains unconfirmed. Single H/L/R tests now last 15 seconds with 1300–1700 us slow ramps and holds. At explicit user request, added A: three independent Servo objects on GPIO16/17/18, all commanded together for four 15-second cycles (60 seconds total). Starts idle; X detaches all; failed attach stops all. Compiled 322907 bytes flash / 23548 bytes RAM; upload hash verified. Simultaneous test start acknowledged; software status is not physical movement verification.

14 October PCA9685 investigation: user reports channel0 motor silent, external V+ about5V, VCC about3.3V, OE0V, and no Hz reading during commanded test. Accepted these observations; no repeat photo requested. Installed Adafruit PWM Servo Driver Library3.0.3/BusIO1.17.4. Replaced custom initialization and PWM writes with library; each channel write now reads back all four PWM registers. Compiled331232 bytes, uploaded COM13 verified. Ran head channel0 for15seconds then X. Live readback: MODE1=0x20 (internal clock selected, sleep clear, auto-increment enabled), MODE2=0x04, prescale121, pulse ticks307/348/266 for1500/1700/1300us, full-off cleared while running. All16 full-off registers verified after stop. This confirms register configuration, NOT a physical output waveform or movement. No root cause proven. Old custom version preserved in assembly/PcaServoDiagnostic-before-library.ino.txt. Next outcome needed: whether physical motor moved under revised library initialization. If still no output, isolate connector/channel or board output with an appropriate physical measurement; do not increase frequency blindly.

15 October: physical channel3 head test from 14 October did not move, per user. Added explicit M command: measures channel3 PWM on spare GPIO10 using bounded pulseIn high/low samples for five seconds, then full-off. No automatic movement. Compiled332480 bytes flash/24296 RAM. Upload on 14 October failed because COM13 was absent. On 15 October identified USB CH343 COM14, esptool confirmed ESP32-S3 and successfully uploaded with hash verification. Firmware Serial uses native USB CDC, so commands require reconnecting laptop to board port marked USB (native), not COM bridge. Measurement has NOT been run: user must unplug head servo, turn external motor 5V off, connect channel3 yellow PWM to GPIO10 with PCA VCC remaining3.3V, then reconnect native USB. Instructions: assembly/PCA_SIGNAL_TEST.md. No root cause established; prior register readbacks are not physical waveform verification.

15 October physical feedback test: user confirmed channel3 PWM -> GPIO10 jumper, head unplugged, external motor supply off. Only COM14 (CH343 bridge) present. Added dual serial console support (Serial native CDC and Serial0 bridge); replies follow the interface receiving commands. Compiled/uploaded verified. M measured real pulses: high1390.9us low17170.8us estimated53.87Hz, 90 samples, zero missed pairs. This establishes a physical output exists on the feedback path, contrary to prior no-Hz meter report. Calibrated oscillator constant to26,920,000Hz, prescale130; pulse conversion now uses the calibrated oscillator/divider rather than fixed25MHz formula. Recompiled341636bytes/24296RAM and uploaded hash verified. Second M: high1501.7us low18470.9us estimated50.07Hz, high min1501 max1502,74 complete sample pairs,5 missed pairs. Software measurements approximate; missed pairs could reflect sampling/contact/signal and remain unexplained. All16 outputs full-off verified after both runs. No motor movement tested in this configuration. Timing corrected, but not established as original no-motion cause. Next physical step: power off USB/external, remove GPIO10 feedback jumper, reconnect head servo channel3 in correct orientation, restore USB and motor5V, then bounded H test. Both USB sockets now supported, so no cable-socket change needed. Raw logs saved PCA_FEEDBACK_RESULT_2026-10-15.txt and PCA_FEEDBACK_CALIBRATED_2026-10-15.txt.

15 October: user reported calibrated PCA head test stayed silent. Added D for direct ESP32Servo GPIO16 comparison,15seconds,1300–1700us,50Hz; keeps PCA outputs off. Uploaded361167bytes flash/24852RAM,hashverified. D has NOT been sent; awaiting physical signal reroute. See PCA_DIRECT_COMPARISON.md. Startup status:
STOPPED: all 16 full-off registers verified.
PCA STATUS ready=1 active=-1 prescale=130
DIRECT_STATUS pin=16 active=0 attached=0
REGISTERS MODE1=20 MODE2=04 HEAD_CHANNEL=3 ON=00:00 OFF=10:00

15 October: user identified and corrected a motor-power issue while keeping direct GPIO16 signal and PCA channel3 V+/GND. User confirmed first and second motors moved successfully on this same path. Third motor moved but jerked. Do not increase range as a presumed fix. Added command C: fixed1500us/50Hz onGPIO16 for8seconds, written once on start, hardware PWM maintained, then detached. No changing target during hold. Preparing fixed-target comparison; physical outcome pending. PCA PWM operation with a servo after the power fix remains untested.

15 October: user confirms all three servos work; identifies internally broken motor-power wire as the problem. Returning to normal PCA9685 wiring, head0/left1/right2,15second individual tests. Compiled361355bytes flash/24852RAM,uploaded COM14 hashverified. No movement command sent. All motors await physical reconnection to PCA ports. Current instructions assembly/SERVO_CONNECTIONS_CURRENT.md supersede temporary direct GPIO16 wiring and head3 isolation. Microphone/amplifier remain next stage after servo tests. State:
STOPPED: all 16 full-off registers verified.
PCA STATUS ready=1 active=-1 prescale=130
DIRECT_STATUS pin=16 active=0 attached=0
REGISTERS MODE1=20 MODE2=04 HEAD_CHANNEL=0 ON=00:00 OFF=10:00

15 October: channel2-only R test completed15seconds and all outputs stopped. User then said 'The motor is dead. Every motor is working very fine. Now ... next step?' Interpreting the overall message as tests done/all working, but the word dead is ambiguous; do not record independent verification. Proceeding to microphone wiring instructions using existing MiniBaymax pinmap BCLK4/WS5/micSD6. No microphone firmware uploaded yet. Current board remains idle PCA diagnostic; microphone and speaker operation unverified.
