Dhaval437/Baymax/assembly/microphone-monitor/index.html

Baymax · Hardware check

# See what your microphone hears

Start a test, then follow the large prompt. Speak near Baymax’s round microphone and watch the line rise and fall.

Start 20-second testStopESP32 microphone · Motors off

Ready to test20 seconds

No live test running

Sound level · higher means louderPrevious test

The first 3 seconds are startup settling and are excluded from the line. Sound levels update about once per second. This shows loudness, not recognised words.

Exact readings

Time | Level (RMS) | Read errors | Clipped samples
