Dhaval437/Baymax/assembly/arms-assembly-cad.png

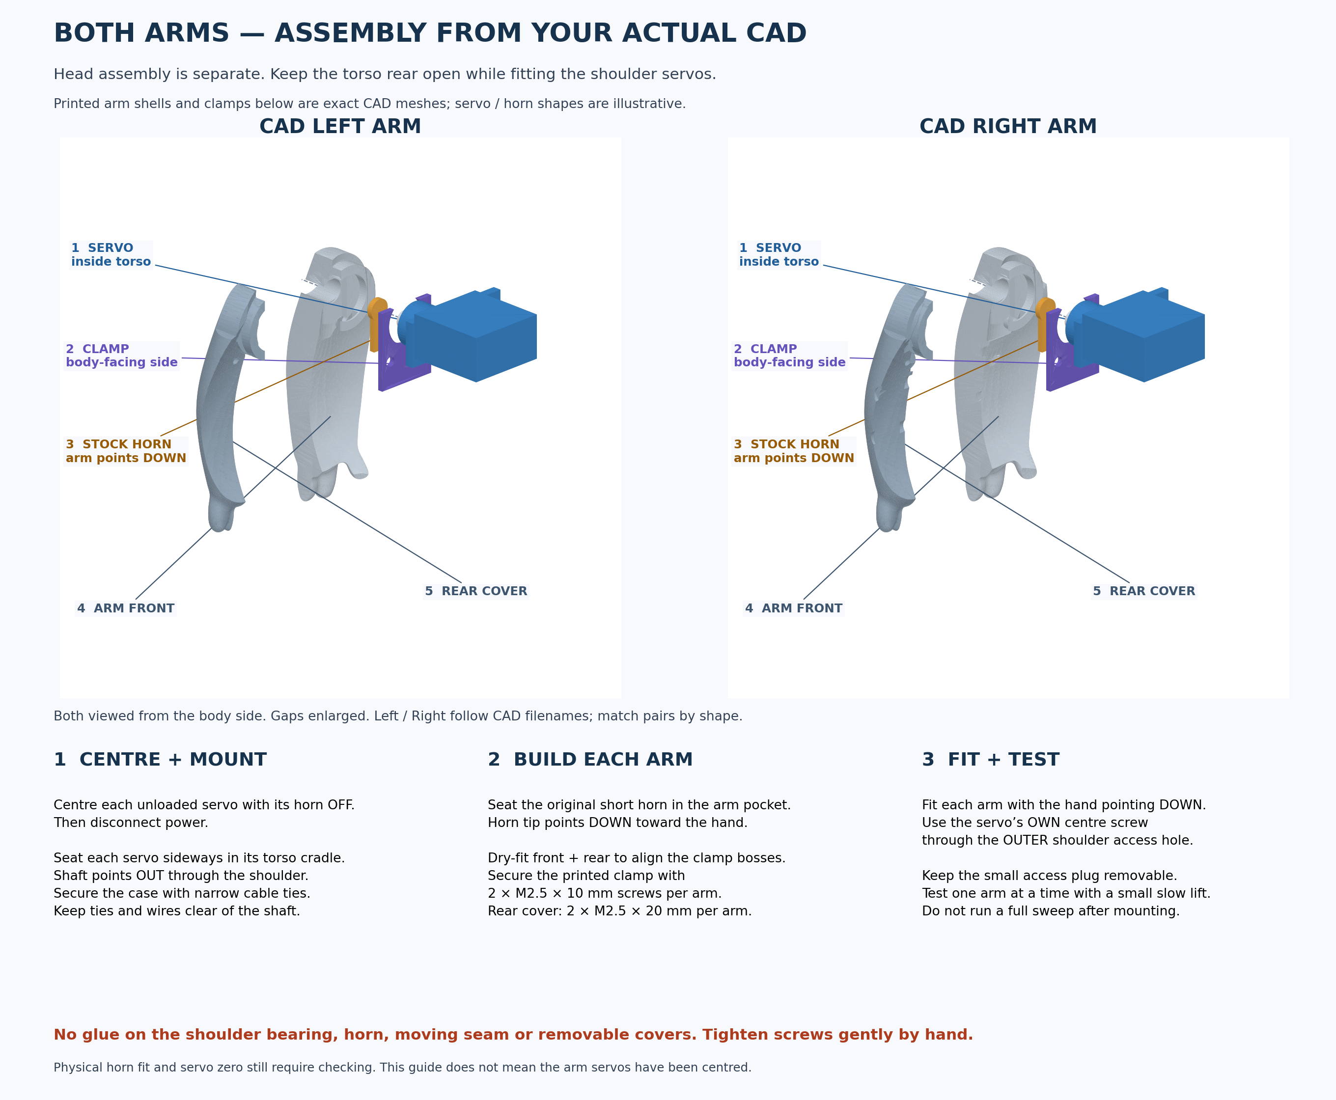
assembly/arms-assembly-cad.png
