Dhaval437/Baymax/assembly/base_box_soldered_layout.png

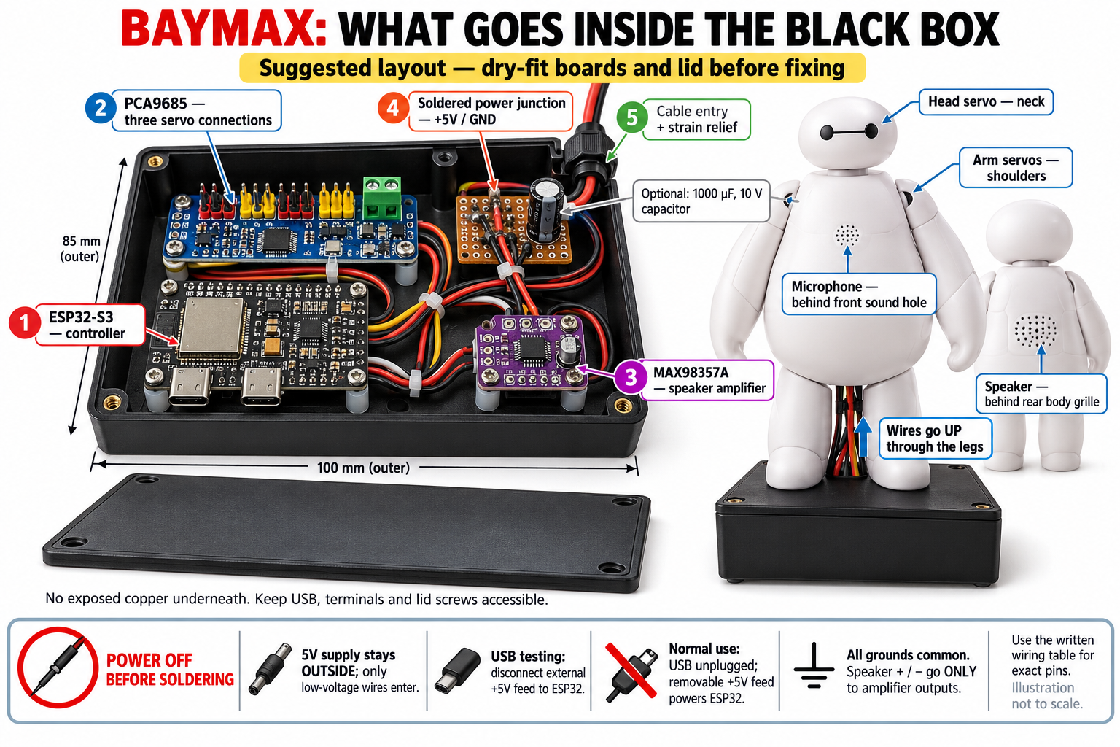
assembly/base_box_soldered_layout.png
