Dhaval437/Baymax/assembly/esp32-no-hole-mounting.png

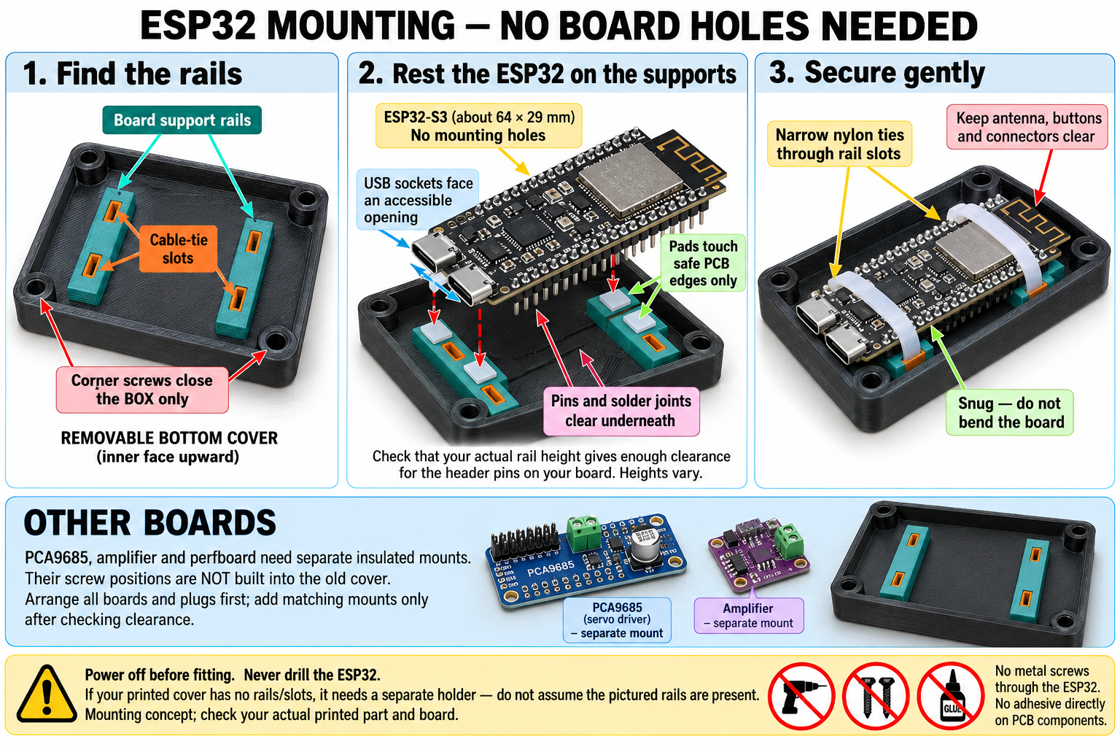
assembly/esp32-no-hole-mounting.png
