Dhaval437/Baymax/assembly/head-attachment-cad.png

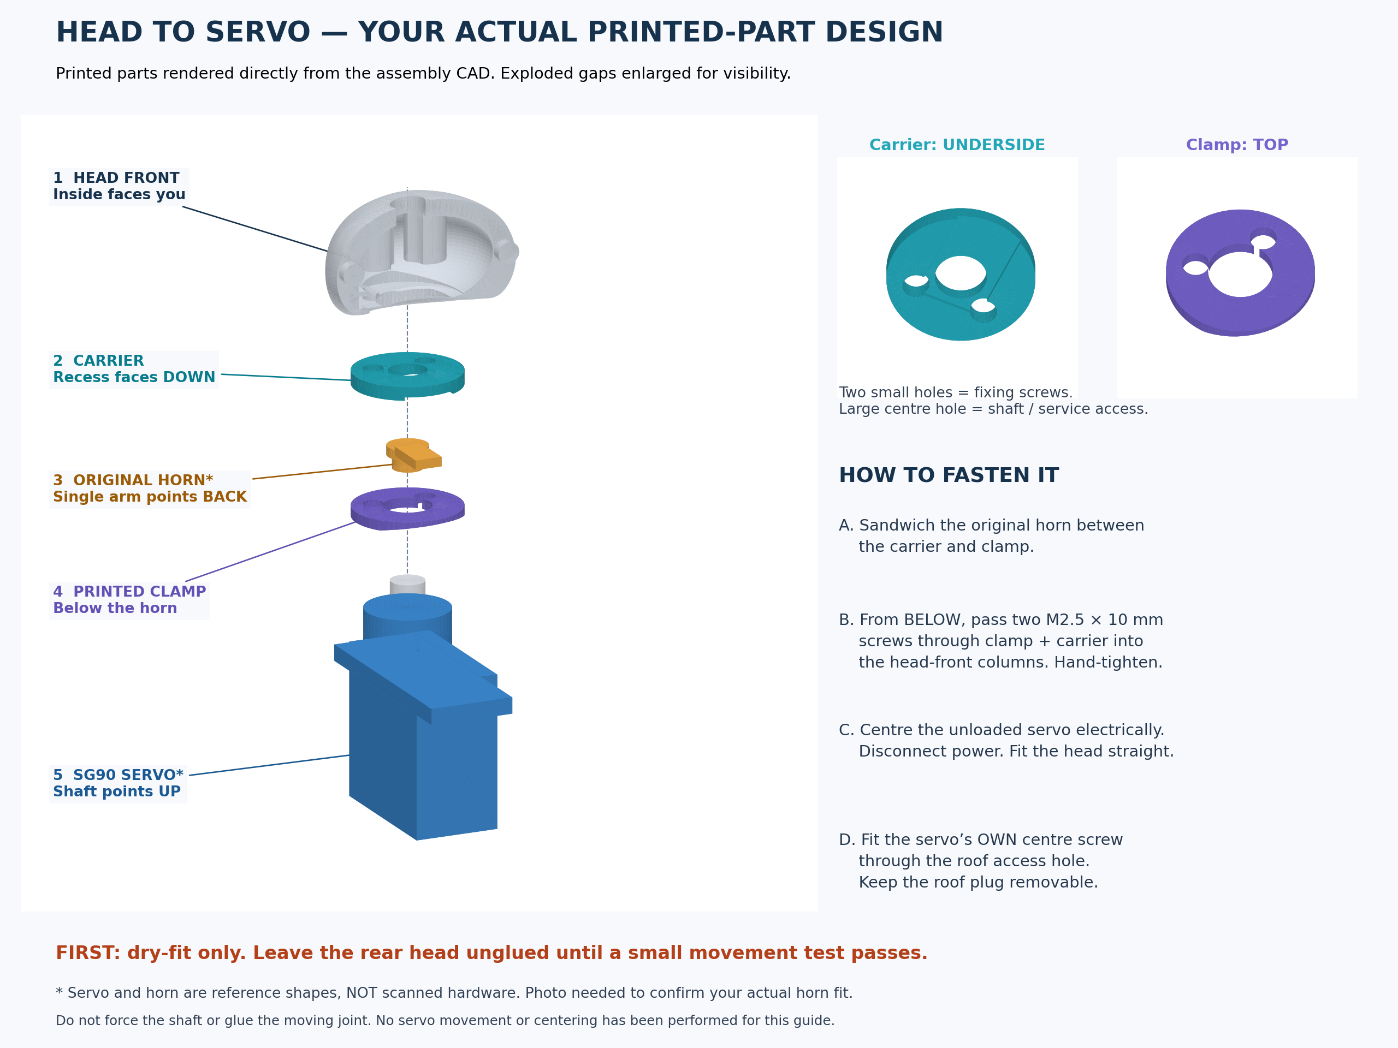
assembly/head-attachment-cad.png
