Dhaval437/Baymax/assembly/microphone-only-wiring.png

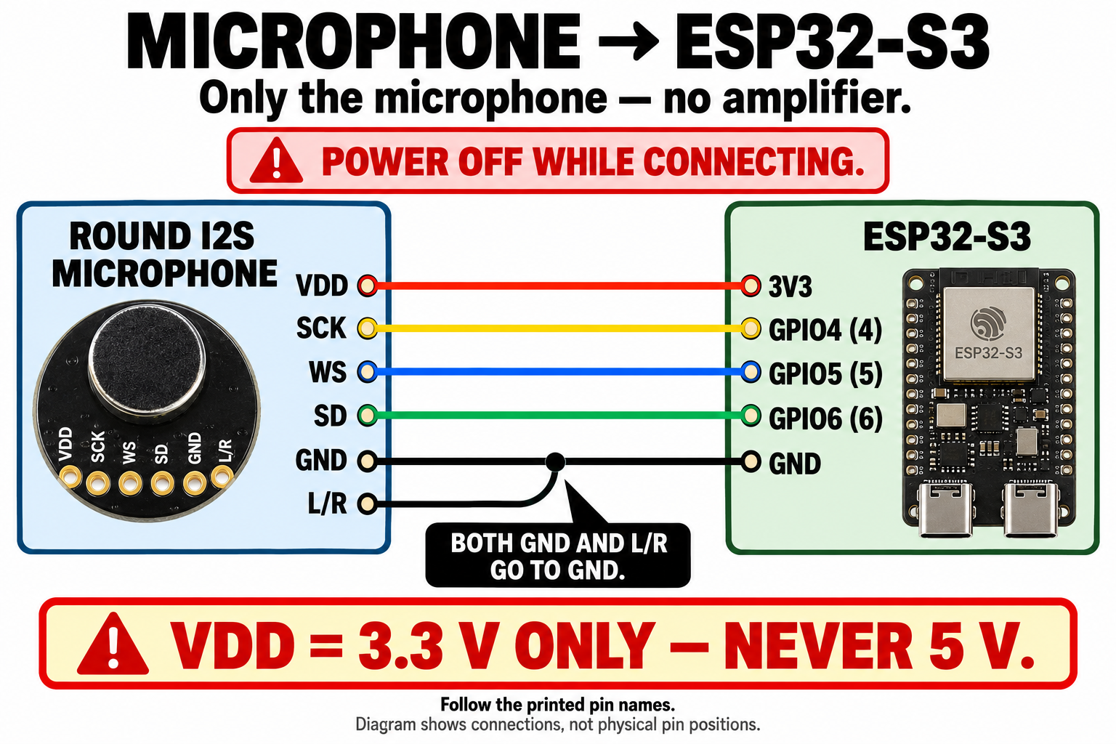
assembly/microphone-only-wiring.png
