Dhaval437/Baymax/assembly/pca9685-head-frequency-probes.png

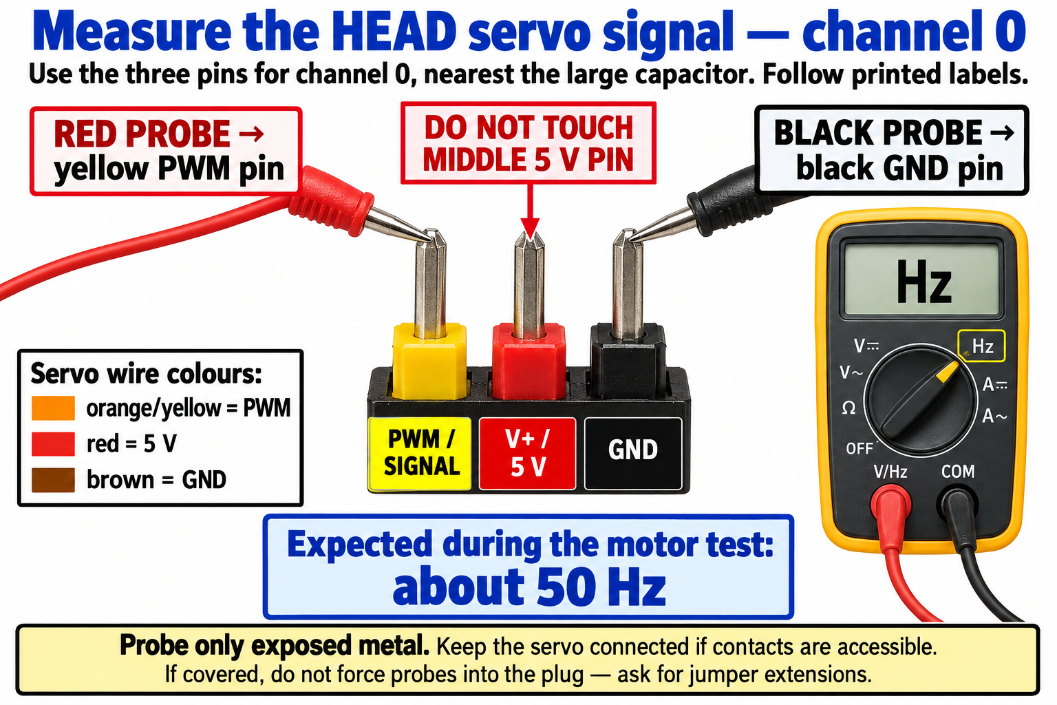
assembly/pca9685-head-frequency-probes.png
