Dhaval437/Baymax/assembly/pca9685-servo-wiring-v2.png

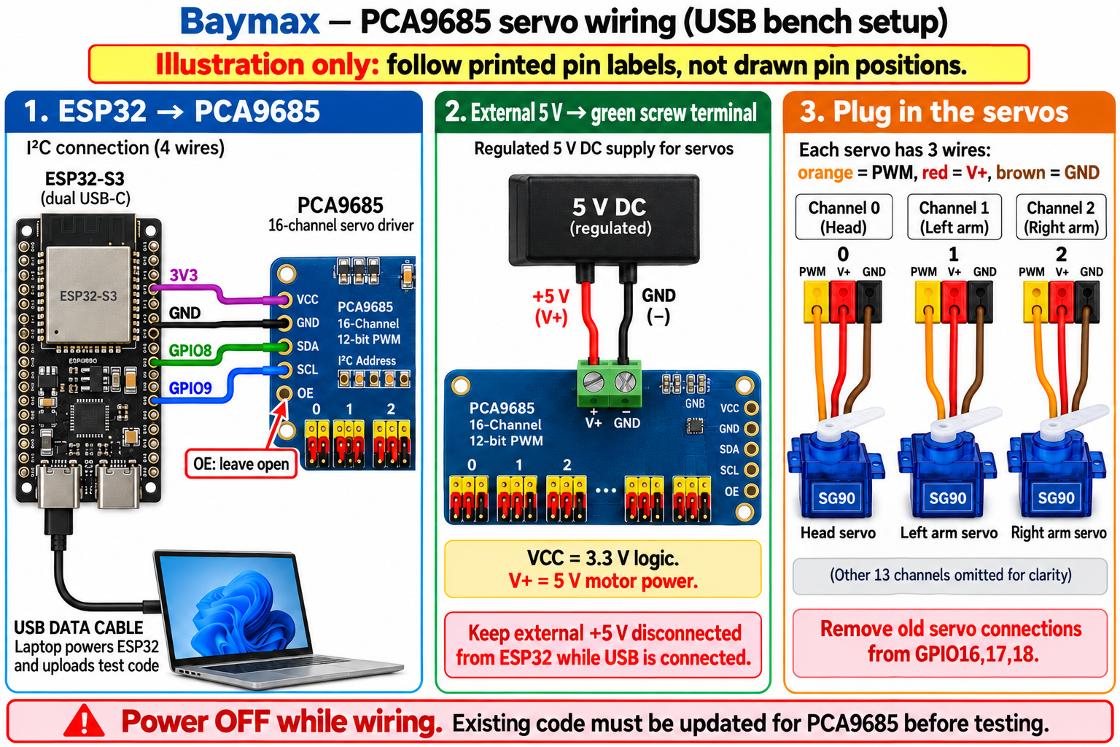
assembly/pca9685-servo-wiring-v2.png
