Dhaval437/Baymax/assembly/servo-only-connections.png

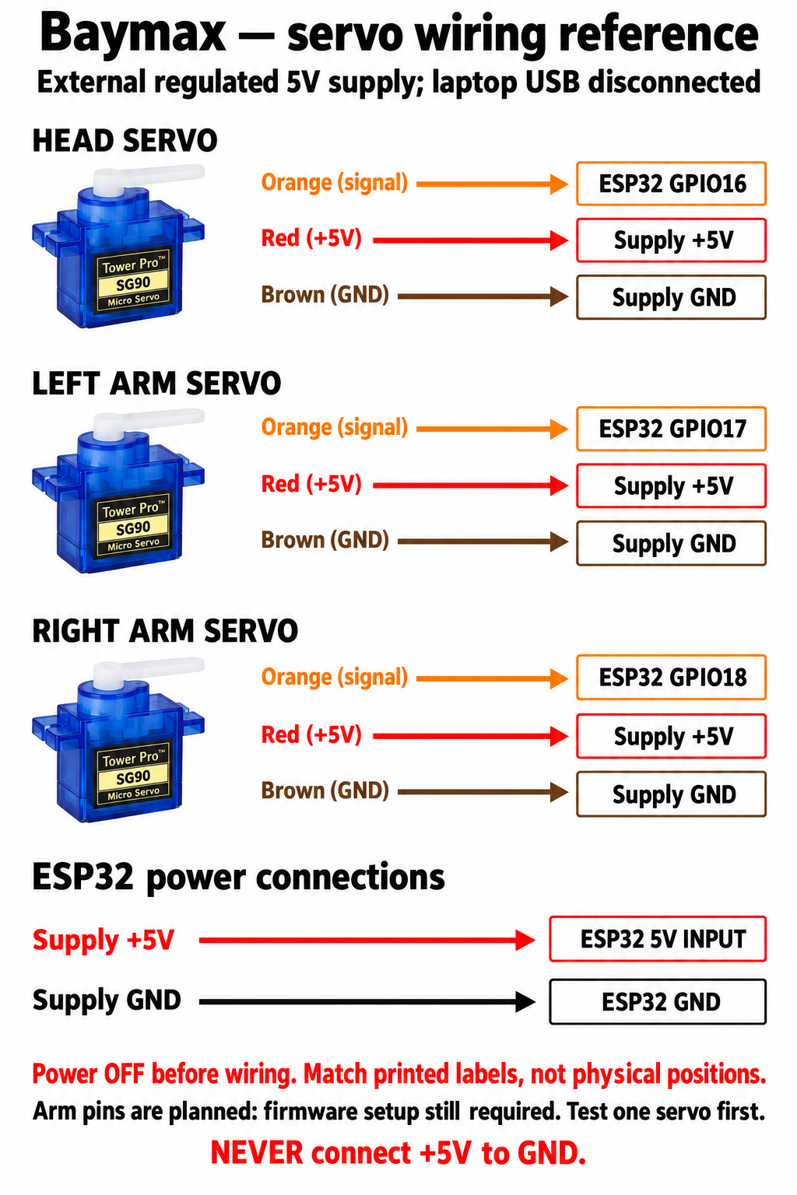
assembly/servo-only-connections.png
