Dhaval437/Baymax/assembly/verification/phone-setup-desktop.png

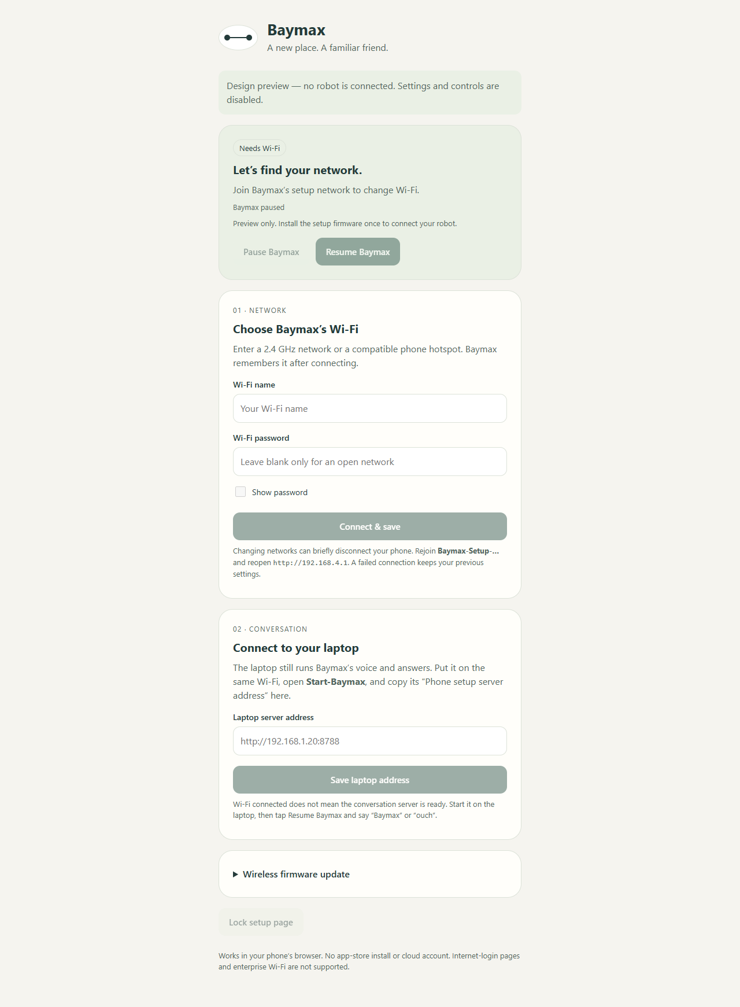
assembly/verification/phone-setup-desktop.png
