Dhaval437/Baymax/assembly/verification/phone-setup-mobile.png

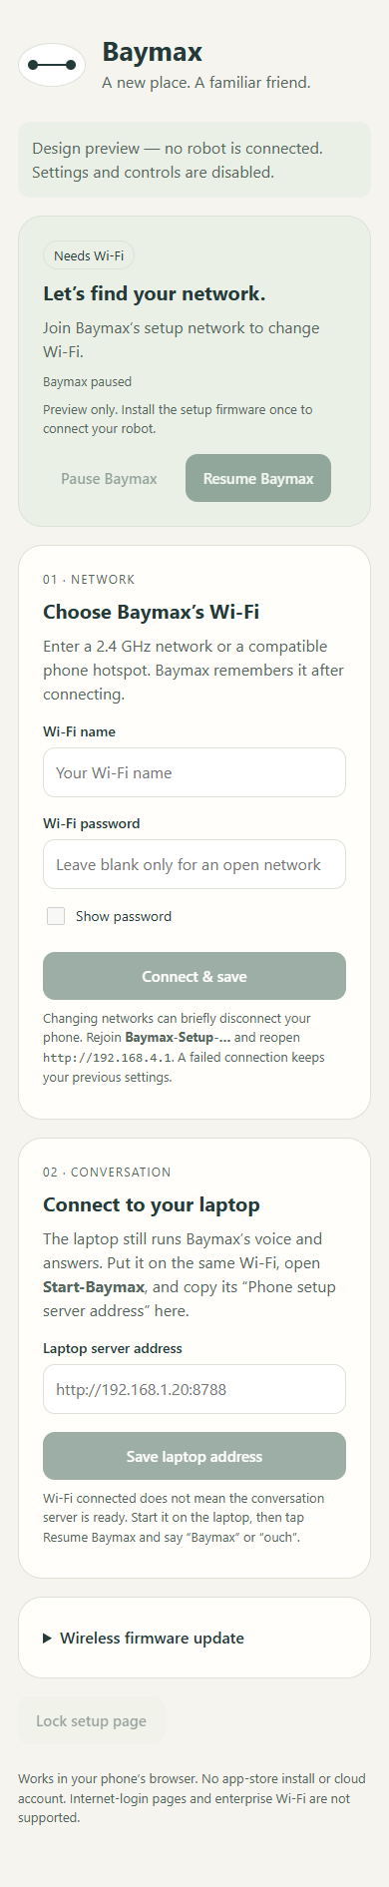
assembly/verification/phone-setup-mobile.png
