Dhaval437/Baymax/mechanical/head_led_3mm/head_led_assembly.png

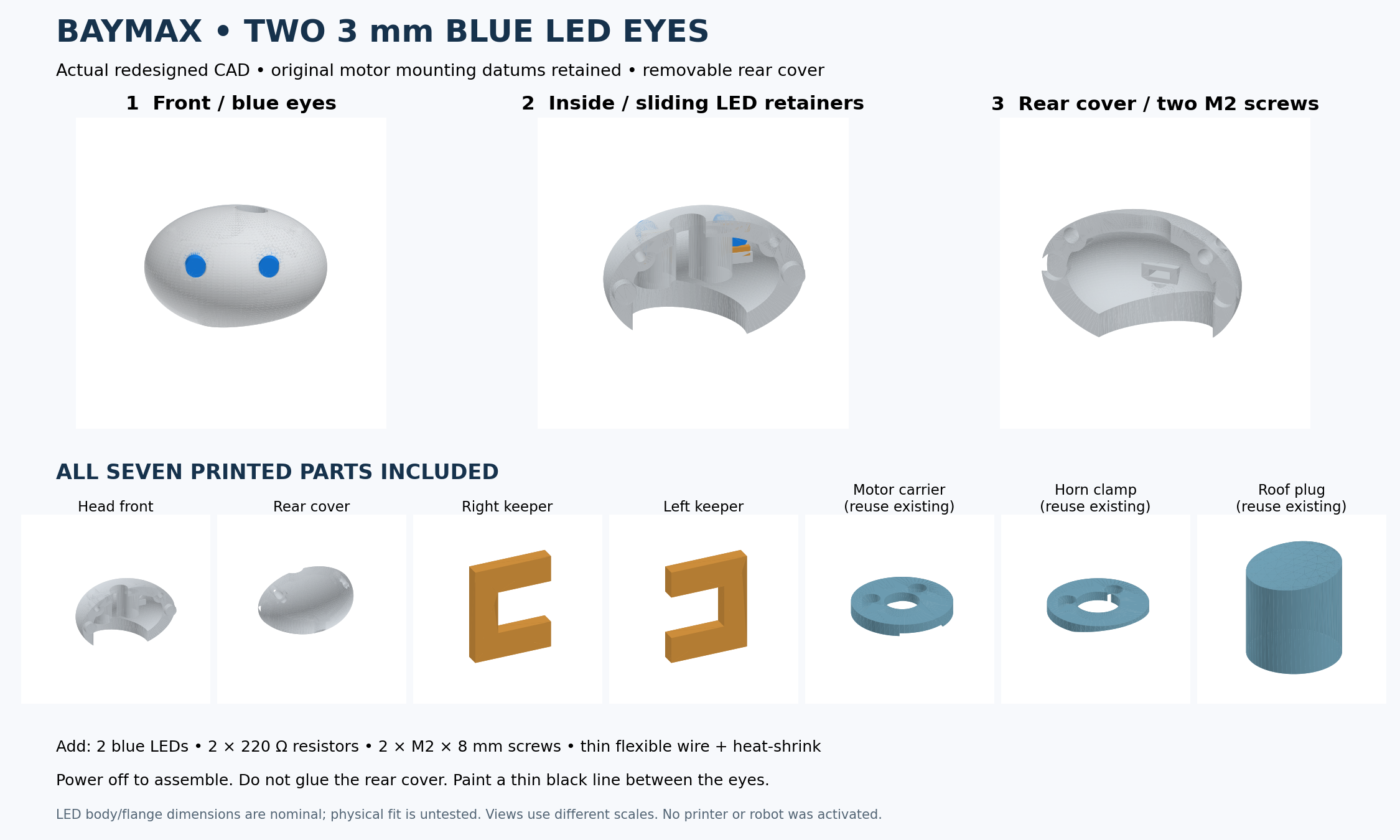
mechanical/head_led_3mm/head_led_assembly.png
