Dhaval437/Baymax/mechanical/production_180/articulated_v3/assembly_preview.png

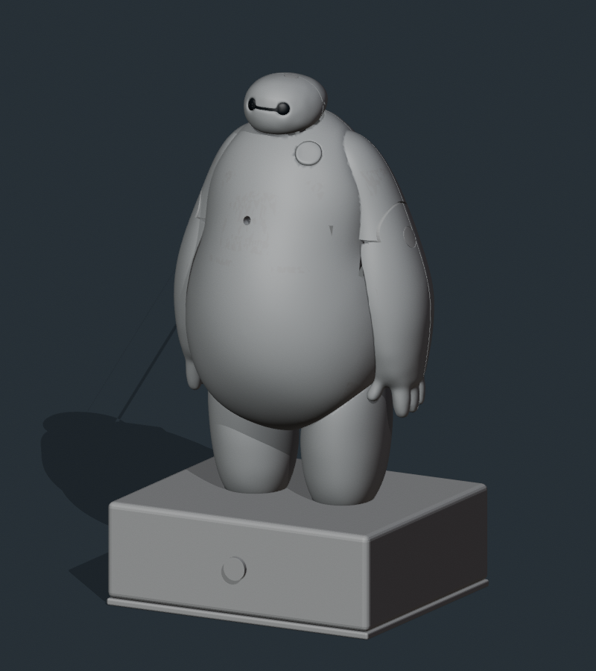
mechanical/production_180/articulated_v3/assembly_preview.png
