Dhaval437/Baymax/mechanical/production_180/assembly_180.png

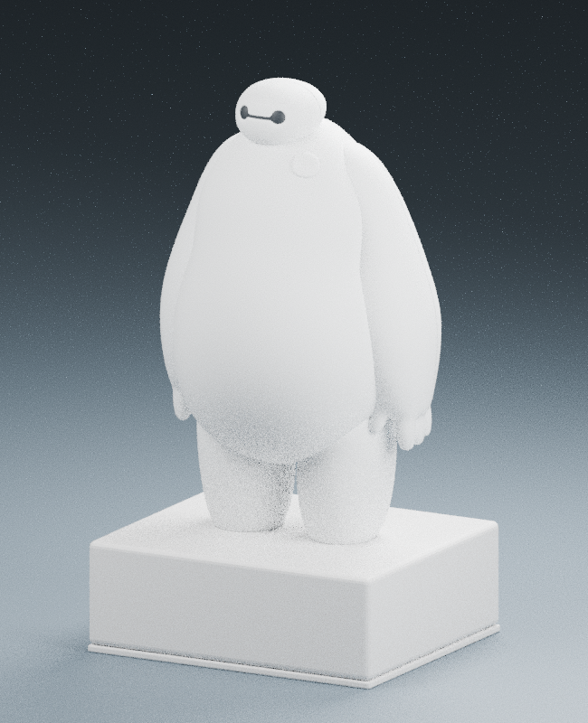
mechanical/production_180/assembly_180.png
