Dhaval437/Baymax/mechanical/production_180/PRINT_PACKAGE_180MM/plate_1_preview.png

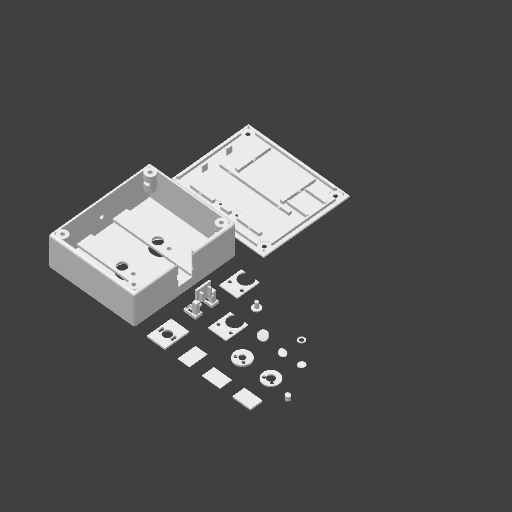
mechanical/production_180/PRINT_PACKAGE_180MM/plate_1_preview.png
