Dhaval437/Baymax/mechanical/production_180/PRINT_PACKAGE_180MM/plate_2_preview.png

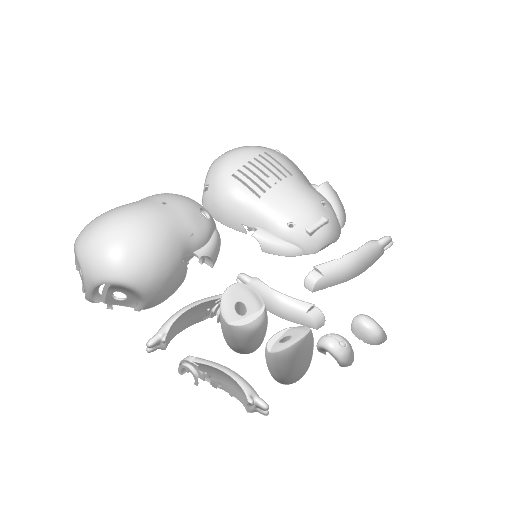
mechanical/production_180/PRINT_PACKAGE_180MM/plate_2_preview.png
