Dhaval437/Baymax/assembly/verification/benchmark-text.txt

I heard you. Tell me what happened, and I will try to help.
