Dhaval437/Baymax/assembly/verification/dashboard-desktop.png

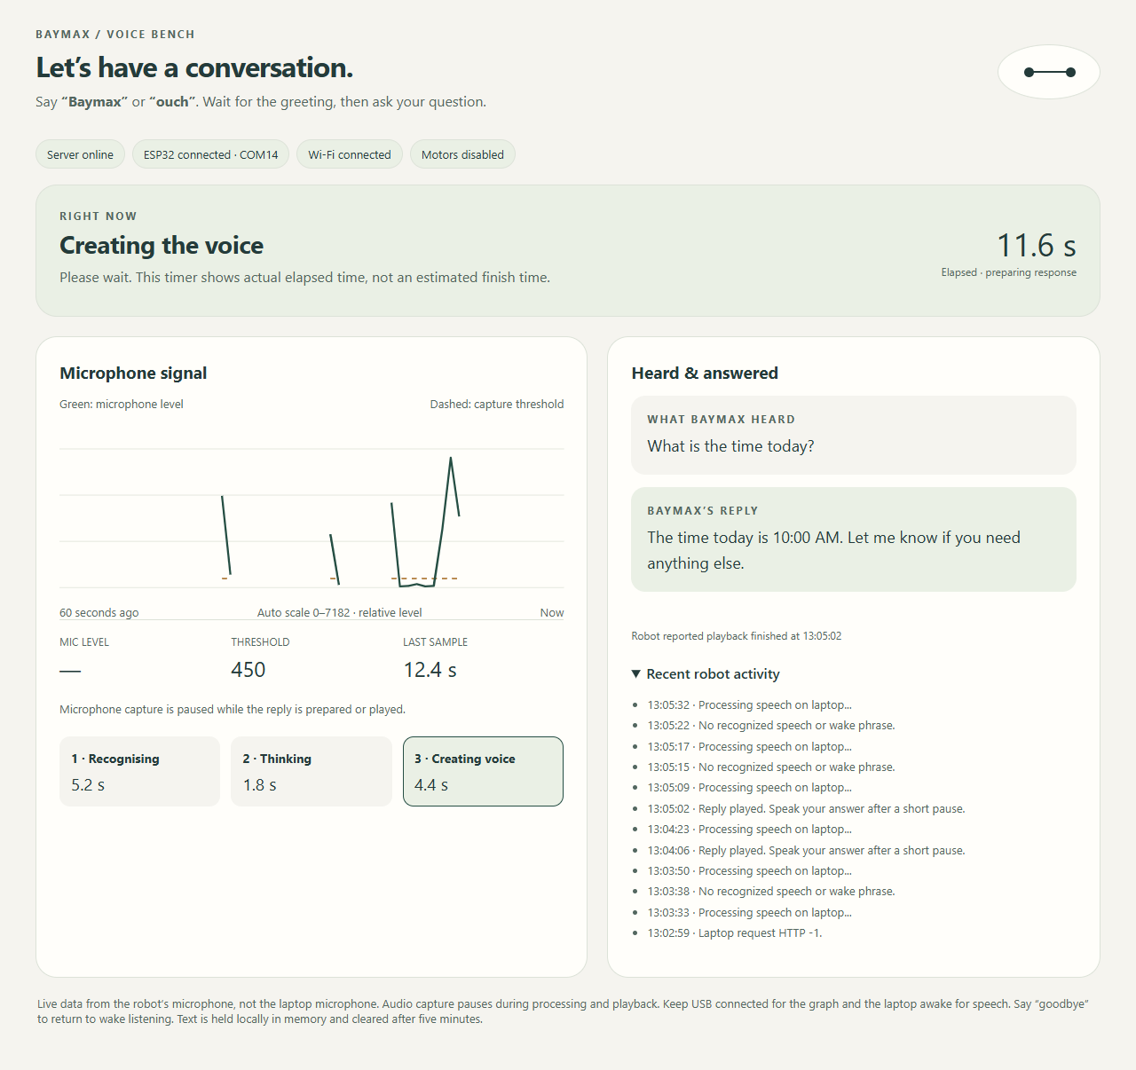
assembly/verification/dashboard-desktop.png
