Dhaval437/Baymax/assembly/verification/dashboard-mobile.png

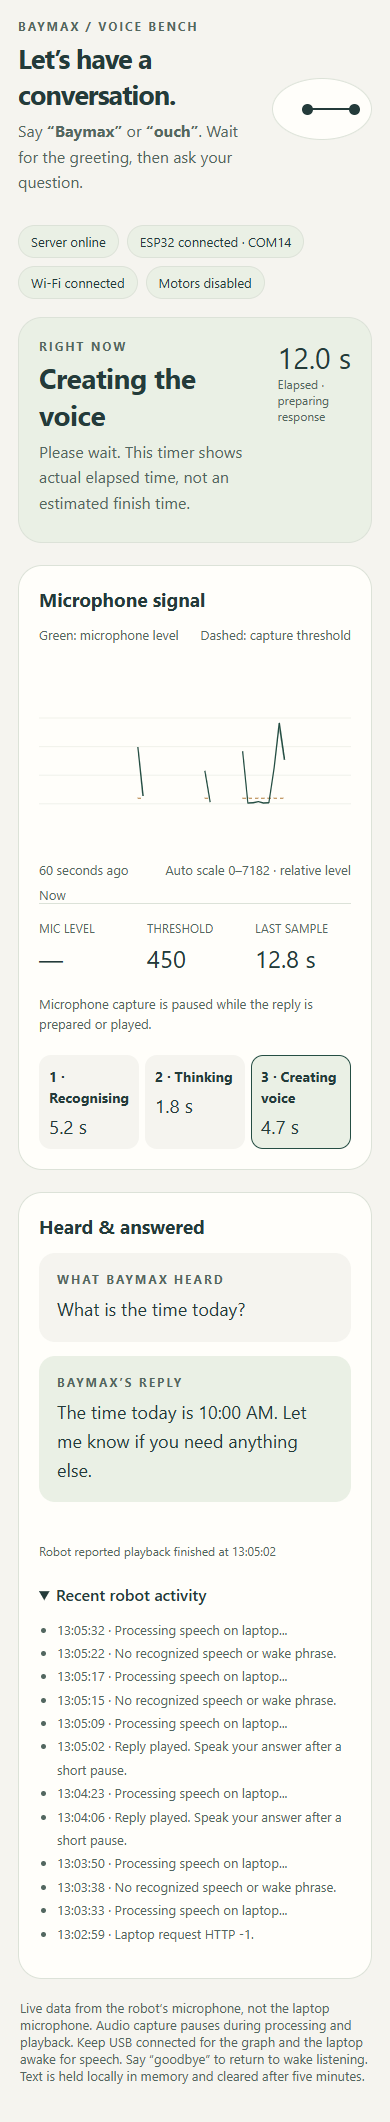
assembly/verification/dashboard-mobile.png
