Dhaval437/Baymax/firmware/MiniBaymax/config.example.h

#pragma once
#define WIFI_SSID "YOUR_2_4_GHZ_WIFI_NAME"
#define WIFI_PASSWORD "YOUR_WIFI_PASSWORD"
#define DEVICE_URL "http://YOUR_LAPTOP_IPV4:8788/device/turn"
#define DEVICE_TOKEN "SAME_RANDOM_TOKEN_AS_BAYMAX_DEVICE_TOKEN_IN_ENV"
#define BAYMAX_AUTO_LISTEN 1
// Leave off during assembly. See RobotSettings.h and SOFTWARE_READY.md.
#define BAYMAX_MOTION_ENABLED 0
#define BAYMAX_MIC_THRESHOLD 450
#define BAYMAX_VOICE_PEAK 20000
