Dhaval437/Baymax/(commit log)

2026-10-17 feat: add persistent local speech worker, wiring diagrams, and verification benchmarks
2026-10-19 Add phone setup, mechanical parts (arm extension, head LED), network address module, and updated firmware
    [01_LED_head_front.stl, 02_LED_head_rear.stl, 03_Left_LED_retainer.stl, 03_Right_LED_retainer.stl, 05_Original_head_carrier.stl, 06_Original_horn_clamp.stl, 07_Original_roof_plug.stl, Baymax_LED_head_3mm.blend]
2026-10-20 Add companion personality, gesture policy, speech cache, adaptive model, and release verification
    [Baymax_arm_extension_5mm.scad, Baymax_arm_extension_5mm_5mm_pair.stl, Baymax_arm_extension_5mm_5mm_single.stl]
2026-10-26 feat: add firmware build artifacts, hardware setup docs, and test configuration
    [partitions.csv]
